kethoo/mimu-gloves/gestures.png

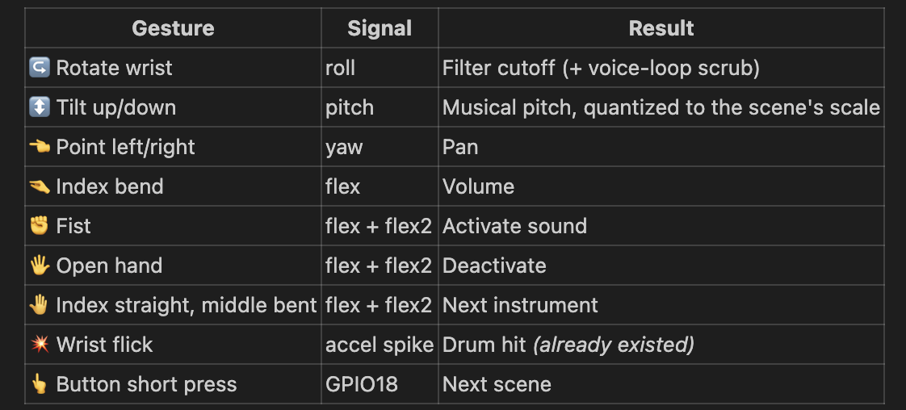
gestures.png
