kethoo/mimu-gloves/gestures_2.png

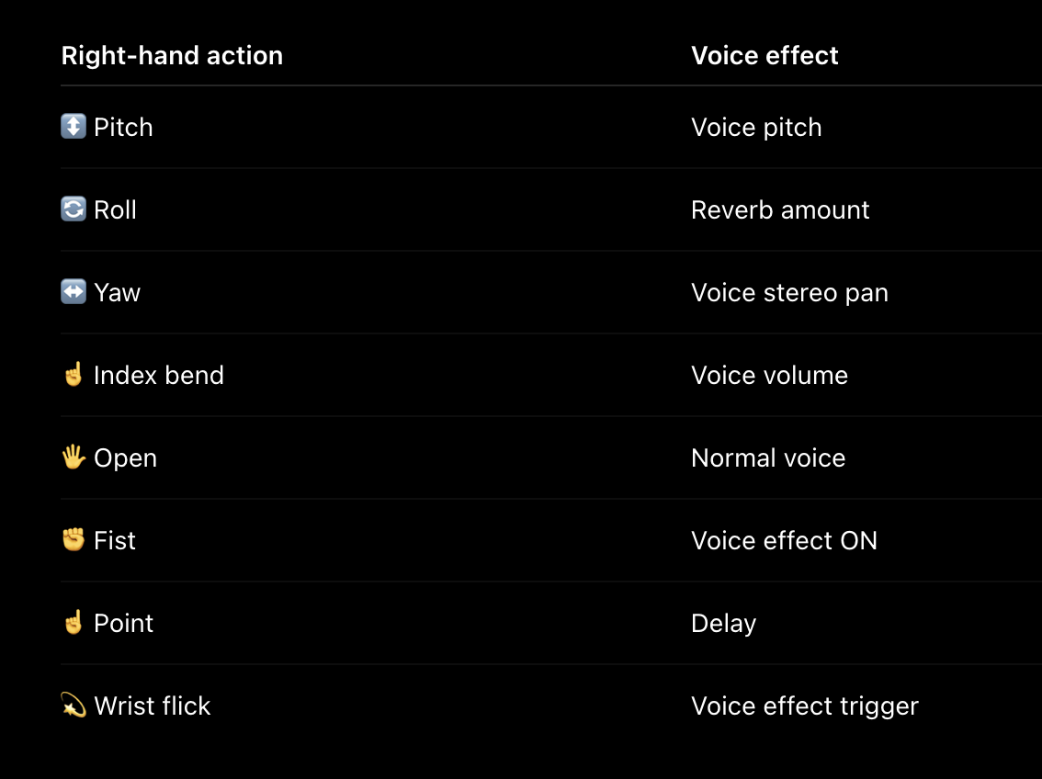
gestures_2.png
