kethoo/mimu-gloves/mid-tr-gestures.png

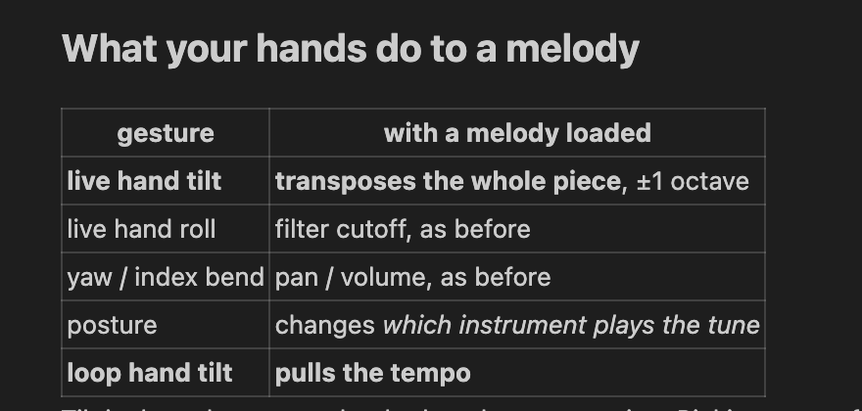
mid-tr-gestures.png
