kethoo/mimu-gloves/esp32/glove_ble/glove_ble.ino

// MiMu-style glove — ESP32 + BNO08x firmware
//
// The BNO08x does sensor fusion on-chip, so we stream ready-made
// orientation (Euler angles) plus linear acceleration over BLE at ~100 Hz.
// Sensor init and quaternion->Euler math merged from the user's original
// serial sketch (see ../reference/bno08x_serial_original.ino).
//
// Wiring (GY-BNO08x -> ESP32):
//   VCC -> 3V3,  GND -> GND,  SDA -> GPIO21,  SCL -> GPIO22,  RST -> GPIO4
//
// This firmware NEVER fabricates motion. If the sensor is missing it keeps
// retrying init and reports status=0 so the laptop can say so plainly.
//
// Wiring (flex sensors): 3V3 -> flex -> GPIO34 -> 15k -> GND
//                        3V3 -> flex -> GPIO35 -> 15k -> GND
//
// Packet format (40 bytes, little-endian, must match ble_receiver.py):
//   float roll, pitch, yaw;  // degrees, absolute (laptop zeroes them)
//   float lax, lay, laz;     // linear acceleration, m/s^2 (gravity removed)
//   float status;            // 1 = live sensor, 0 = sensor not detected
//   float flex, flex2;       // raw ADC 0..4095 from the two flex dividers
//   float scenePresses;      // running count of short button presses; the
//                            // laptop advances one scene per increment

#include <Adafruit_BNO08x.h>
#include <ESP_I2S.h>
#include <BLE2902.h>
#include <BLEDevice.h>
#include <BLEServer.h>
#include <BLEUtils.h>
#include <Wire.h>
#include <math.h>

// Which hand this board is. Flash one board with "-I" and the other with
// "-V"; the laptop tells them apart by advertised name, since two boards
// running the same sketch would otherwise advertise identically and the host
// would connect to whichever it happened to see first — nondeterministically,
// run to run. The service/characteristic UUIDs stay the same for both:
// devices are addressed by device, not by UUID.
//
//   "-I"  instrument hand (pitch, brightness, pan, scenes)
//   "-V"  voice hand      (voice pitch, reverb, delay, stutter)
//
// The laptop also matches by prefix, so a board still on the old un-suffixed
// "MIMU-GLOVE" firmware keeps working as the instrument hand.
// Defaults to the instrument hand. Flash the voice board by adding
//   --build-property "compiler.cpp.extra_flags=-DHAND_VOICE"
// to the arduino-cli command — no editing this file, so there is no way to
// leave the wrong identity committed or to flash two boards the same.
#ifdef HAND_VOICE
  #define HAND_SUFFIX "-V"
#else
  #define HAND_SUFFIX "-I"
#endif
#define DEVICE_NAME  "MIMU-GLOVE" HAND_SUFFIX
#define SERVICE_UUID "6e400001-b5a3-f393-e0a9-e50e24dcca9e"
#define CHAR_UUID    "6e400003-b5a3-f393-e0a9-e50e24dcca9e"
#define AUDIO_UUID   "6e400004-b5a3-f393-e0a9-e50e24dcca9e"
// The first thing the laptop can SEND to the glove rather than read from it.
// Everything else here is notify-only, so the glove had no way of knowing
// which instrument or loop mode it was part of — which is most of what the
// LED on the hand wants to show.
#define LED_UUID     "6e400005-b5a3-f393-e0a9-e50e24dcca9e"

#define BNO08X_I2C_ADDR 0x4B
#define BNO_RST 4
// Flex sensor divider. GPIO34 is input-only and on ADC1, which (unlike ADC2)
// keeps working while the BLE radio is active.
// The divider only swings ~212 of 4095 counts end to end (a 13-16k sensor
// into a 15k leg is 0.17 V), and raw ESP32 ADC noise measured ~50 counts —
// a quarter of the whole usable range. Averaging N samples cuts random noise
// by sqrt(N), so 16 reads takes it to ~13 counts. 32 reads per loop at 50 Hz
// is a rounding error against the BLE and I2S work.
#define FLEX_OVERSAMPLE 16
#define FLEX_PIN  34
#define FLEX2_PIN 35   // second finger; ADC1, input-only
// Record button, status LED and the INMP441 microphone.
#define BTN_PIN     18
#define HOLD_MS     400   // press longer than this records; shorter = next scene
// Longer than any real press, so a button that stays down is a fault.
#define BTN_STUCK_MS 8000
// More presses than this inside the window means the pin is producing them
// itself. A player does not press a glove's one button six times in ten
// seconds; a floating input does it constantly.
// Counted over a minute, not ten seconds. A pin that misfires every
// twenty or thirty seconds never produces a burst, so a short window
// never sees it — but each misfire still records two seconds of the room
// and replaces whatever was loaded. Three deliberate presses in a minute
// is already more than this button is for.
#define BTN_FAULT_PRESSES   3
#define BTN_FAULT_WINDOW_MS 60000
// Status LED: one WS2812B (NeoPixel). GND to ground, DIN here, and VDD to
// 3V3 rather than 5V — the ESP32 drives DIN at 3.3 V, while a WS2812B run
// from 5 V wants about 3.5 V before it reads a bit as high. That is the
// wiring that mostly works and occasionally shows the wrong colour.
// Driven by the core's own neopixelWrite(), so there is no library to add.
// GPIO23 rather than 16: on a WROVER the PSRAM chip owns 16 and 17, so the
// LED there works only in a build without PSRAM, which costs the 8 s
// recording buffer. 23 is not a strapping pin, not flash and not PSRAM, so
// it is quiet at boot and keeps both.
#define LED_PIN     23
#if defined(BOARD_HAS_PSRAM) && (LED_PIN == 16 || LED_PIN == 17)
  #error "LED_PIN 16/17 is the PSRAM bus on a WROVER - see the note above it"
#endif
// A WS2812B at full scale is blinding at arm's length and draws 60 mA. These
// are the only two levels the patterns use.
#define LED_LOW      6
#define LED_HIGH    60

// The second WS2812B: sewn to the back of the hand, between the glove's two
// layers, so the fabric spreads it into a patch of light rather than a dot.
// This one is driven by the laptop over LED_UUID and says what the hand is
// doing musically, where the board LED says whether the hardware is well.
// The same pin on both hands, so the two gloves are wired identically and
// there is nothing to get the wrong way round. 27 is a plain GPIO: no
// strapping, no flash, no PSRAM, nothing driven at boot.
#define HAND_LED_PIN 27
// The same trap as the status LED, plus one of its own: GPIO12 sets the
// flash voltage at boot, and held the wrong way the board does not come up
// at all — a far worse afternoon than a dark LED.
#if defined(BOARD_HAS_PSRAM) && (HAND_LED_PIN == 16 || HAND_LED_PIN == 17)
  #error "HAND_LED_PIN 16/17 is the PSRAM bus on a WROVER - use 27 or 19"
#endif
#if HAND_LED_PIN == 12
  #error "HAND_LED_PIN 12 is the flash-voltage strap (MTDI) - use 27 or 19"
#endif
// Sewn in under two layers of fabric. 48 read as off at the laptop's dimmer
// levels, and 255 is more current than this rail should carry for an indicator.
// The right glove stays at its earlier 48 until the brighter one has been judged.
#ifdef HAND_VOICE
  #define HAND_LED_MAX 48
#else
  #define HAND_LED_MAX 120
#endif
#define I2S_SCK     33
#define I2S_WS      25
#define I2S_SD      32
#define AUDIO_RATE  16000
#define MAX_SECONDS 8
// Internal RAM to leave untouched for the BLE stack, I2S DMA and the rest of
// the sketch when there is no PSRAM to put the audio buffer in. Sized with
// headroom: running the heap dry shows up as a BLE disconnect mid-recording,
// which is far harder to diagnose than a shorter take.
#define HEAP_RESERVE 40000
#define MAX_SAMPLES (AUDIO_RATE * MAX_SECONDS)
#define AUDIO_CHUNK 180   // bytes per BLE notification during a transfer
// 50 Hz is plenty for gesture control and leaves the I2C bus ~8x headroom;
// asking the BNO08x for 100 Hz on two reports wedges its SHTP transport.
#define SAMPLE_HZ 50
#define REPORT_US 20000  // 20 ms -> 50 Hz sensor reports
#define STALL_RESET_MS 20000  // silence before the sensor is hard reset

// No reset pin in the constructor: we drive it manually below, because the
// BNO08x needs a long (~500 ms) settle time after reset that the library's
// built-in pulse does not give it.
Adafruit_BNO08x bno08x;
sh2_SensorValue_t sensorValue;
BLECharacteristic *sensorChar;
BLECharacteristic *audioChar;
bool deviceConnected = false;
// Kept so a disconnect can clear them. See ServerCallbacks::onDisconnect.
BLE2902 *sensorCccd = nullptr;
BLE2902 *audioCccd = nullptr;
bool imuPresent = false;
uint32_t lastReportMs = 0;  // watchdog: when did a real sensor report arrive
uint32_t nextRetryMs = 0;   // rate-limit recovery attempts
int reEnableCount = 0;      // failed soft recoveries before a hard re-init

// Latest sensor readings, updated as reports arrive.
float roll = 0, pitch = 0, yaw = 0;
float lax = 0, lay = 0, laz = 0;
float flex = 0, flex2 = 0;  // smoothed raw ADC; the laptop calibrates these
uint32_t scenePresses = 0;  // running count of short button presses
bool btnStuck = false;      // button ignored until it releases (see buttonHeld)
bool btnFaulty = false;     // button disabled for this session (see buttonHeld)

// Microphone / recording state.
I2SClass i2s;
bool micOK = false, recording = false;
size_t maxSamples = 0;   // however many the allocation gave us
int16_t *audioBuf = nullptr;     // allocated in PSRAM at boot
size_t audioLen = 0;
int ledMode = 0;                 // 0 idle, 1 recording, 2 sending, 3 error

// The glove LED's state, as the laptop last described it. Declared here
// rather than beside its animation code because the BLE callback below
// writes it. See updateHandLed() for what the bytes mean.
enum : uint8_t {
  PAT_OFF = 0, PAT_STEADY, PAT_BREATHE, PAT_PULSE,
  PAT_SLICES, PAT_FROZEN, PAT_REVERSE, PAT_RECORD,
  // Like PULSE but barely dipping: the melody hand shares the loop's clock
  // without turning into a blinker and competing with what it is playing.
  PAT_ACCENT,
};
// hue, value, pattern, phase, period low, period high. Written by the BLE
// task and read by the loop; a torn read would cost one frame of one LED, so
// it is not worth a lock.
volatile uint8_t handPkt[6] = {0, 0, PAT_OFF, 0, 0, 0};
volatile uint32_t handPktAt = 0;

// Six bytes from the laptop: hue, value, pattern, phase, period (uint16 LE).
// Anything shorter is ignored rather than half-applied.
class LedCallbacks : public BLECharacteristicCallbacks {
  void onWrite(BLECharacteristic *c) override {
    if (c->getLength() < 6) return;
    const uint8_t *d = c->getData();
    for (int i = 0; i < 6; i++) handPkt[i] = d[i];
    handPktAt = millis();
  }
};

class ServerCallbacks : public BLEServerCallbacks {
  void onConnect(BLEServer *srv, esp_ble_gatts_cb_param_t *param) override {
    deviceConnected = true;
    // Ask for the fastest link Apple allows: 15-30 ms (units of 1.25 ms), no
    // skipped events, 4 s timeout. Left to itself the Mac was measured settling
    // on 30 ms with long gaps, about 20 packets a second from a 50 Hz sensor,
    // which is a visible lag on the wrist.
    srv->updateConnParams(param->connect.remote_bda, 12, 24, 0, 400);
  }
  void onDisconnect(BLEServer *srv) override {
    deviceConnected = false;
    // A subscription belongs to the link, but the stack keeps it after the
    // link is gone. The next client then gets 50 notifications a second while
    // it is still discovering services, and the Mac never finishes: the link
    // comes up, the status LED goes green, and the laptop times out, on every
    // connection after the first until the board reboots.
    if (sensorCccd) sensorCccd->setNotifications(false);
    if (audioCccd) audioCccd->setNotifications(false);
    // Nobody is describing the music any more, so stop showing the last colour:
    // it read as still being connected.
    handPkt[2] = PAT_OFF;
    srv->getAdvertising()->start();  // let the laptop reconnect
  }
};

void setReports() {
  if (!bno08x.enableReport(SH2_ROTATION_VECTOR, REPORT_US))
    Serial.println("Could not enable Rotation Vector");
  if (!bno08x.enableReport(SH2_LINEAR_ACCELERATION, REPORT_US))
    Serial.println("Could not enable Linear Acceleration");
  // NOTE: deliberately does not touch lastReportMs — only a real incoming
  // report may reset the watchdog, or it can never escalate to a re-init.
}

// Unstick the I2C bus. If the sensor locked up mid-transfer it can hold SDA
// low forever, which makes every device — including itself — invisible to a
// scan. Clocking SCL manually lets it finish that transfer and release SDA.
void recoverI2CBus() {
  Wire.end();
  pinMode(22, OUTPUT);      // SCL
  pinMode(21, INPUT_PULLUP);  // SDA
  for (int i = 0; i < 10 && digitalRead(21) == LOW; i++) {
    digitalWrite(22, LOW);
    delayMicroseconds(5);
    digitalWrite(22, HIGH);
    delayMicroseconds(5);
  }
  // Manual STOP condition so the bus is left idle.
  pinMode(21, OUTPUT);
  digitalWrite(21, LOW);
  delayMicroseconds(5);
  digitalWrite(22, HIGH);
  delayMicroseconds(5);
  digitalWrite(21, HIGH);
  delayMicroseconds(5);
  Wire.begin(21, 22);
  Wire.setClock(100000);  // slower bus: safer over long jumper wires
  Wire.setTimeOut(50);    // never block forever on a line that is still stuck
}

// Hard-reset the sensor the way the original sketch did: hold RST low,
// release, then give it half a second to boot before talking to it.
void hardResetSensor() {
  pinMode(BNO_RST, OUTPUT);
  digitalWrite(BNO_RST, LOW);
  delay(20);
  digitalWrite(BNO_RST, HIGH);
  delay(500);
}

void scanI2C() {
  Serial.print("I2C devices found:");
  bool any = false;
  for (uint8_t addr = 1; addr < 127; addr++) {
    Wire.beginTransmission(addr);
    if (Wire.endTransmission() == 0) {
      Serial.printf(" 0x%02X", addr);
      any = true;
    }
  }
  Serial.println(any ? "" : " NONE (check wiring: VCC/GND/SDA=21/SCL=22)");
}

// Try both common BNO08x addresses, with retries — a cold sensor sometimes
// needs a second attempt after reset.
bool initSensor() {
  for (int attempt = 1; attempt <= 3; attempt++) {
    recoverI2CBus();
    hardResetSensor();
    if (attempt > 1) scanI2C();  // show whether it is even on the bus
    for (uint8_t addr : {(uint8_t)BNO08X_I2C_ADDR, (uint8_t)0x4A}) {
      if (bno08x.begin_I2C(addr, &Wire)) {
        Serial.printf("BNO08X found at 0x%02X (attempt %d)\n", addr, attempt);
        setReports();
        lastReportMs = millis();
        reEnableCount = 0;
        return true;
      }
    }
    Serial.printf("BNO08X init attempt %d failed\n", attempt);
  }
  return false;
}

// Written only when the colour actually changes. Each write is an RMT
// transaction that holds the pin for ~80 us, and there is no reason to run
// one fifty times a second to say what the LED is already saying. The cache
// is per LED, since there are two of them on different pins now.
void writePixel(uint8_t pin, uint8_t idx, uint8_t r, uint8_t g, uint8_t b) {
  static uint8_t last[2][3] = {{0, 0, 0}, {0, 0, 0}};
  static bool written[2] = {false, false};
  if (written[idx] && r == last[idx][0] && g == last[idx][1] && b == last[idx][2])
    return;
  last[idx][0] = r; last[idx][1] = g; last[idx][2] = b; written[idx] = true;
  neopixelWrite(pin, r, g, b);
}

void setLed(uint8_t r, uint8_t g, uint8_t b) {
  writePixel(LED_PIN, 0, r, g, b);
}

// Status LED. Non-blocking so the pattern survives audio work. One colour
// per state, so the glove can be read on its own without the laptop:
//   solid red        recording
//   blue blink       sending the take over BLE
//   fast red blink   sensor stalled — the watchdog below is trying to recover
//   dim green        idle, laptop connected
//   dim blue pulse   idle, advertising and waiting to be connected to
void statusColour(uint8_t low, uint8_t high, uint8_t &r, uint8_t &g, uint8_t &b) {
  uint32_t t = millis();
  r = g = b = 0;
  if (ledMode == 1) r = high;
  else if (ledMode == 2) b = (t / 400) % 2 ? high : 0;
  else if (ledMode == 3) r = (t / 120) % 2 ? high : 0;
  else if (deviceConnected) g = low;
  else b = (t / 900) % 2 ? low : 0;
}

void updateLed() {
  uint8_t r, g, b;
  statusColour(LED_LOW, LED_HIGH, r, g, b);
  setLed(r, g, b);
}

// ---- the LED sewn into the glove ----------------------------------------
// This one belongs to the laptop. It knows the instrument, the loop mode and
// where the playhead is; the glove knows none of that, which is exactly why
// the write characteristic had to exist. Six bytes arrive and are animated
// here rather than streamed frame by frame, so the pulse stays smooth
// between updates and a dropped packet costs nothing.
// Mirrors N_SLICES in synth.py: the take is chopped into four, so the hand
// beats four times a cycle and you can see where the chops land.
#define HAND_SLICES 4

// Hue at full brightness; the pattern scales it afterwards. An integer
// rainbow rather than real HSV — this is a glowing patch of fabric, not a
// colour-managed display.
static void hueToRgb(uint8_t h, uint8_t &r, uint8_t &g, uint8_t &b) {
  uint8_t sector = h / 43, f = (uint8_t)((h % 43) * 6);
  switch (sector) {
    case 0:  r = 255;     g = f;       b = 0;       break;
    case 1:  r = 255 - f; g = 255;     b = 0;       break;
    case 2:  r = 0;       g = 255;     b = f;       break;
    case 3:  r = 0;       g = 255 - f; b = 255;     break;
    case 4:  r = f;       g = 0;       b = 255;     break;
    default: r = 255;     g = 0;       b = 255 - f; break;
  }
}

// A hit rather than a blink: full at the top of the cycle and gone a quarter
// of the way in, over a floor so the hand never goes black mid-loop.
static float accent(float p) {
  float a = 1.0f - p * 4.0f;
  return a > 0.0f ? a : 0.0f;
}

void updateHandLed() {
  uint8_t pat = handPkt[2];
  uint32_t now = millis();

#ifndef HAND_VOICE
  // The instrument glove has no LED on GPIO23, so this is the only one it can
  // speak through. It shows the status colours until the laptop sends a colour,
  // and again whenever the glove has something to say that the laptop cannot
  // know: recording, sending a take, or a stalled sensor.
  if (ledMode != 0 || pat == PAT_OFF) {
    uint8_t r, g, b;
    statusColour(HAND_LED_MAX / 2, HAND_LED_MAX, r, g, b);
    writePixel(HAND_LED_PIN, 1, r, g, b);
    return;
  }
#endif

  // Where the loop is *now*, carried on from the last packet. Interpolating
  // locally is what keeps the beat smooth: the laptop only has to resync
  // occasionally instead of sending every frame of the animation.
  float p = 0.0f;
  uint16_t period = (uint16_t)handPkt[4] | ((uint16_t)handPkt[5] << 8);
  if (period > 0) {
    float turns = handPkt[3] / 256.0f + (float)(now - handPktAt) / period;
    p = turns - floorf(turns);
  }

  float level;
  switch (pat) {
    case PAT_OFF:
      writePixel(HAND_LED_PIN, 1, 0, 0, 0);
      return;
    case PAT_RECORD:   // the one state that overrides its own colour
      writePixel(HAND_LED_PIN, 1, HAND_LED_MAX, 0, 0);
      return;
    case PAT_BREATHE:
      level = 0.15f + 0.35f * (0.5f + 0.5f * sinf(now / 1200.0f));
      break;
    case PAT_PULSE:
      level = 0.35f + 0.65f * accent(p);
      break;
    case PAT_SLICES: {
      float q = p * HAND_SLICES;
      level = 0.35f + 0.65f * accent(q - floorf(q));
      break;
    }
    case PAT_REVERSE:  // the hit decays into the beat instead of off it
      level = 0.35f + 0.65f * accent(1.0f - p);
      break;
    case PAT_ACCENT:
      level = 0.82f + 0.18f * accent(p);
      break;
    default:           // STEADY and FROZEN both just hold
      level = 1.0f;
      break;
  }

  uint8_t r, g, b;
  hueToRgb(handPkt[0], r, g, b);
  // The base colour eases over ~100 ms, so changing instrument reads as a
  // change rather than a glitch. Freeze snaps, because the audio snaps.
  static float cr = 0, cg = 0, cb = 0;
  float k = (pat == PAT_FROZEN) ? 1.0f : 0.25f;
  cr += (r - cr) * k; cg += (g - cg) * k; cb += (b - cb) * k;

  float scale = level * (handPkt[1] / 255.0f) * (HAND_LED_MAX / 255.0f);
  writePixel(HAND_LED_PIN, 1, (uint8_t)(cr * scale),
             (uint8_t)(cg * scale), (uint8_t)(cb * scale));
}

// Oversampled flex read: see FLEX_OVERSAMPLE above for why this matters.
int readFlex(int pin) {
  uint32_t sum = 0;
  for (int i = 0; i < FLEX_OVERSAMPLE; i++) sum += analogRead(pin);
  return (int)(sum / FLEX_OVERSAMPLE);
}

bool buttonHeld() {
  static bool stable = false, lastRaw = false, lastStable = false;
  static uint32_t lastChange = 0, heldSince = 0;
  bool raw = digitalRead(BTN_PIN) == LOW;
  if (raw != lastRaw) { lastRaw = raw; lastChange = millis(); }
  if (millis() - lastChange > 30) {
    if (raw && !stable) heldSince = millis();
    stable = raw;
  }
  // A healthy button is pressed deliberately, a few times a minute. One
  // that produces presses on its own is a wiring fault, and it is far more
  // damaging than it sounds: each phantom hold records two seconds of the
  // room from the glove's own mic, and a take REPLACES the loop — so a song
  // you just loaded is overwritten by whatever the speakers were playing.
  // Measured on the faulty glove: four recordings in twenty-two seconds.
  static uint32_t presses = 0, windowStart = 0;
  if (stable && !lastStable) {
    uint32_t now = millis();
    if (now - windowStart > BTN_FAULT_WINDOW_MS) { windowStart = now; presses = 0; }
    if (++presses > BTN_FAULT_PRESSES && !btnFaulty) {
      btnFaulty = true;
      Serial.printf("!! button produced %u presses in %lu s on its own - "
                    "disabling it for this session (check its wiring)\n",
                    (unsigned)presses,
                    (unsigned long)(BTN_FAULT_WINDOW_MS / 1000));
    }
  }
  lastStable = stable;
  if (btnFaulty) return false;

  if (!stable) { btnStuck = false; return false; }

  // A press that never ends is a wiring fault, not a very long press. It
  // matters because the buffer-full path waits for the release and would
  // spin there for good, and recording returns early from the loop — so a
  // shorted button stops the glove sending orientation at all. Measured on
  // a glove whose GPIO18 was shorted: one heartbeat in thirty seconds, the
  // panel showing it connected and stalled with the hand frozen at zero.
  if (!btnStuck && millis() - heldSince > BTN_STUCK_MS) {
    btnStuck = true;
    Serial.println("!! button has read as pressed for 8 s - treating it as "
                   "stuck and ignoring it until it releases (check its wiring)");
  }
  return !btnStuck;
}

// Ship the take to the laptop: a 12-byte header, then raw little-endian
// int16 samples. Latency does not matter here - the recording is already
// finished - which is why this works where live streaming would not.
void sendAudio() {
  if (!deviceConnected || audioLen == 0) return;
  ledMode = 2;
  uint8_t hdr[12];
  memcpy(hdr, "AUD0", 4);
  uint32_t n = audioLen, r = AUDIO_RATE;
  memcpy(hdr + 4, &n, 4);
  memcpy(hdr + 8, &r, 4);
  audioChar->setValue(hdr, sizeof(hdr));
  audioChar->notify();
  delay(20);

  const uint8_t *data = (const uint8_t *)audioBuf;
  size_t total = audioLen * sizeof(int16_t), sent = 0;
  while (sent < total && deviceConnected) {
    size_t n2 = min((size_t)AUDIO_CHUNK, total - sent);
    audioChar->setValue((uint8_t *)(data + sent), n2);
    audioChar->notify();
    sent += n2;
    updateLed();
    delay(6);   // let the BLE stack drain; without this notifications are lost
  }
  Serial.printf("audio sent: %u samples (%.2f s)\n",
                (unsigned)audioLen, (float)audioLen / AUDIO_RATE);
  ledMode = 0;
  audioLen = 0;
}

void setup() {
  Serial.begin(115200);
  delay(100);
  Serial.println("========== MIMU GLOVE (BLE) ==========");

  Wire.begin(21, 22);
  // 100 kHz, NOT 400 kHz. Measured: at 400 kHz over dupont jumpers the
  // BNO08x wedged every ~15-20 s (it kept ACKing its address but would not
  // re-initialize); at 100 kHz it ran 90 s under BLE load with zero dropouts.
  Wire.setClock(100000);
  // A held-low SDA or SCL makes endTransmission() block, and a board that
  // blocks here never reaches BLEDevice::init and so never advertises at
  // all — which looks exactly like a dead board. Seen on the voice glove:
  // serial stopped mid-way through the I2C scan and nothing followed.
  Wire.setTimeOut(50);
  delay(100);

  pinMode(BTN_PIN, INPUT_PULLUP);
  // Held low until the first colour is written: a WS2812B whose DIN floats
  // at power-up latches whatever noise it saw and sits there lit.
  pinMode(LED_PIN, OUTPUT);
  digitalWrite(LED_PIN, LOW);
  pinMode(HAND_LED_PIN, OUTPUT);
  digitalWrite(HAND_LED_PIN, LOW);
  // Nobody powers the glove up with the button held, so a button that is
  // already down at boot is a short. Waiting out BTN_STUCK_MS still let it
  // record a stray take first, and a take REPLACES whatever is in the loop
  // — so a song you had just loaded was overwritten by two seconds of the
  // room, picked up from the speakers, which then looped.
  delay(20);
  if (digitalRead(BTN_PIN) == LOW) {
    btnStuck = true;
    Serial.println("!! button is already pressed at boot - treating it as "
                   "stuck and ignoring it (check its wiring)");
  }

  // The audio buffer lives in PSRAM: this is a WROVER module, and internal
  // RAM has no room for it beside the BLE stack. Falls back to a shorter
  // take in internal RAM if PSRAM is unavailable.
  audioBuf = (int16_t *)ps_malloc(MAX_SAMPLES * sizeof(int16_t));
  if (audioBuf) {
    maxSamples = MAX_SAMPLES;
    Serial.printf("Audio buffer: %d s in PSRAM.\n", MAX_SECONDS);
  } else {
    // No PSRAM. Size the buffer to what internal RAM can actually spare
    // rather than assuming: free heap after the BLE stack comes up varies by
    // core version and build options, and a hardcoded 2 s was leaving room
    // unused on some boards and would overrun on others.
    // Largest CONTIGUOUS block, not total free. getFreeHeap() reports the
    // sum of every free fragment, so asking malloc for that much fails on a
    // fragmented heap — measured 228 kB free but no single block that size,
    // which silently produced a 0-second buffer.
    size_t freeHeap = ESP.getMaxAllocHeap();
    size_t budget = freeHeap > HEAP_RESERVE ? freeHeap - HEAP_RESERVE : 0;
    size_t want = (size_t)AUDIO_RATE * MAX_SECONDS * sizeof(int16_t);
    size_t take = budget < want ? budget : want;
    maxSamples = take / sizeof(int16_t);
    audioBuf = maxSamples ? (int16_t *)malloc(maxSamples * sizeof(int16_t)) : nullptr;
    if (!audioBuf) maxSamples = 0;
    Serial.printf(
        "No PSRAM - largest free block %u B, reserving %u B -> %.1f s buffer.\n",
        (unsigned)freeHeap, (unsigned)HEAP_RESERVE,
        (float)maxSamples / AUDIO_RATE);
  }

  i2s.setPins(I2S_SCK, I2S_WS, -1, I2S_SD);
  micOK = i2s.begin(I2S_MODE_STD, AUDIO_RATE, I2S_DATA_BIT_WIDTH_32BIT,
                    I2S_SLOT_MODE_MONO);
  Serial.println(micOK ? "Microphone ready." : "Microphone FAILED to start.");

  BLEDevice::init(DEVICE_NAME);
  BLEDevice::setMTU(517);   // big MTU so audio chunks fit in one packet
  BLEServer *server = BLEDevice::createServer();
  server->setCallbacks(new ServerCallbacks());
  BLEService *service = server->createService(SERVICE_UUID);
  sensorChar = service->createCharacteristic(
      CHAR_UUID, BLECharacteristic::PROPERTY_NOTIFY);
  sensorCccd = new BLE2902();
  sensorChar->addDescriptor(sensorCccd);
  audioChar = service->createCharacteristic(
      AUDIO_UUID, BLECharacteristic::PROPERTY_NOTIFY);

  // Write-without-response as well as write: the laptop sends this several
  // times a second and has no use for an acknowledgement, and waiting for
  // one would put it in the way of the audio transfer.
  BLECharacteristic *ledChar = service->createCharacteristic(
      LED_UUID, BLECharacteristic::PROPERTY_WRITE |
                BLECharacteristic::PROPERTY_WRITE_NR);
  ledChar->setCallbacks(new LedCallbacks());
  audioCccd = new BLE2902();
  audioChar->addDescriptor(audioCccd);
  service->start();
  server->getAdvertising()->start();
  // Print the real macro, never a copy of it: a hardcoded literal here
  // said "MIMU-GLOVE" on a board that was correctly advertising as
  // "MIMU-GLOVE-V", which is a genuinely confusing thing to debug.
  Serial.print("Advertising as ");
  Serial.println(DEVICE_NAME);

  // Sensor last, and only after the radio is up. The flex sensors and the
  // microphone do not need the IMU, so a glove with a dead BNO08x should
  // still link and still be playable — and a board that cannot be found at
  // all is far harder to diagnose than one that connects and reports
  // status=0. recoverI2CBus() first, to clock out a stuck line before the
  // scan rather than after it.
  recoverI2CBus();
  hardResetSensor();
  scanI2C();
  imuPresent = initSensor();
  if (!imuPresent)
    Serial.println("BNO08X not found - will keep retrying (no fake data sent).");
}

void readSensor() {
  if (bno08x.wasReset()) {
    Serial.println("Sensor reset.");
    delay(100);
    setReports();
  }
  // Drain everything that has arrived since last loop.
  while (bno08x.getSensorEvent(&sensorValue)) {
    lastReportMs = millis();
    if (sensorValue.sensorId == SH2_ROTATION_VECTOR) {
      float qr = sensorValue.un.rotationVector.real;
      float qi = sensorValue.un.rotationVector.i;
      float qj = sensorValue.un.rotationVector.j;
      float qk = sensorValue.un.rotationVector.k;
      yaw = atan2(2.0f * (qr * qk + qi * qj),
                  1.0f - 2.0f * (qj * qj + qk * qk)) * 180.0f / PI;
      pitch = asin(constrain(2.0f * (qr * qj - qk * qi), -1.0f, 1.0f))
              * 180.0f / PI;
      roll = atan2(2.0f * (qr * qi + qj * qk),
                   1.0f - 2.0f * (qi * qi + qj * qj)) * 180.0f / PI;
    } else if (sensorValue.sensorId == SH2_LINEAR_ACCELERATION) {
      lax = sensorValue.un.linearAcceleration.x;
      lay = sensorValue.un.linearAcceleration.y;
      laz = sensorValue.un.linearAcceleration.z;
    }
  }

  // Watchdog: reports stop arriving if the SHTP transport wedges (a known
  // BNO08x quirk, provoked here by BLE traffic). Try re-enabling reports a
  // few times, then escalate to a full hardware reset + re-init.
  uint32_t now = millis();
  uint32_t since = now - lastReportMs;
  // The error colour was defined and never used, which is a waste of the one
  // thing the glove can say by itself. The stall now shows on the hand as it
  // happens, instead of only in the laptop's log: red the moment reports go
  // missing, back to idle the moment they come back. Recording and sending
  // outrank it — those say something the wearer is waiting on.
  if (ledMode != 1 && ledMode != 2) ledMode = (since > 1000) ? 3 : 0;
  if (since > 1000 && now > nextRetryMs) {
    nextRetryMs = now + 1000;
    // Measured on the right glove: reports stopped while the hand lay still and
    // flowed while it moved, and escalating after 3 s rebooted the board and
    // dropped the laptop about every 8 s. So a quiet sensor is only re-enabled,
    // and the reset waits until it has been silent for a long time.
    if (since < STALL_RESET_MS) {
      reEnableCount++;
      Serial.printf("No reports for %lums - re-enabling (%d).\n",
                    (unsigned long)since, reEnableCount);
      setReports();
    } else {
      Serial.println("Soft recovery failed - hard resetting sensor.");
      imuPresent = initSensor();
      lastReportMs = millis();
      reEnableCount = 0;
      if (!imuPresent) {
        // The sensor still ACKs its address but refuses to initialize: it is
        // wedged in a state that re-init cannot clear. A full reboot is the
        // one recovery proven to work every time, so stop limping and reboot.
        Serial.println("Sensor unrecoverable in place - rebooting ESP32.");
        Serial.flush();
        delay(50);
        ESP.restart();
      }
    }
  }
}

void loop() {
  static uint32_t next = 0;
  uint32_t now = millis();

  updateLed();
  updateHandLed();

  // One button, two jobs: a short press asks the laptop for the next scene,
  // holding it records. Recording only begins once the press passes HOLD_MS,
  // so a tap can never start a stray take.
  //
  // The scene press is reported as a running count rather than a one-frame
  // pulse: a dropped BLE notification would silently swallow a pulse, but the
  // laptop notices a count that has moved on whenever the next packet lands.
  bool btn = buttonHeld();
  static bool prevBtn = false;
  static uint32_t pressStart = 0;
  if (btn && !prevBtn) pressStart = now;
  if (!btn && prevBtn && !recording && now - pressStart < HOLD_MS) {
    scenePresses++;
    Serial.println(">>> short press: next scene");
  }
  prevBtn = btn;

  // Audio capture takes priority over the sensor stream: a few dropped
  // orientation frames cost nothing, a gap in the recording is audible.
  bool held = micOK && btn && (now - pressStart >= HOLD_MS);
  if (held && !recording) {
    recording = true;
    audioLen = 0;
    ledMode = 1;
    Serial.println(">>> RECORDING <<<");
  } else if (!held && recording) {
    recording = false;
    Serial.printf(">>> STOPPED: %.2f s\n", (float)audioLen / AUDIO_RATE);
    sendAudio();
  }

  if (recording) {
    static int32_t rawAudio[256];
    size_t got = i2s.readBytes((char *)rawAudio, sizeof(rawAudio));
    size_t n = got / sizeof(int32_t);
    for (size_t i = 0; i < n && audioLen < maxSamples; i++)
      audioBuf[audioLen++] = (int16_t)(rawAudio[i] >> 16);   // 24-bit -> 16-bit
    if (audioLen >= maxSamples) {
      Serial.println("(buffer full)");
      recording = false;
      sendAudio();
      while (buttonHeld()) { updateLed(); delay(5); }
    }
    return;   // skip sensor work while capturing
  }

  if (imuPresent) {
    readSensor();
  } else if (now > nextRetryMs) {
    // Never give up: a marginal connection often comes back, and a boot-time
    // failure must not doom the whole session. After a few in-place retries,
    // reboot — that path reliably brings the sensor back.
    nextRetryMs = now + 3000;
    static int missingRetries = 0;
    Serial.println("Retrying BNO08X...");
    imuPresent = initSensor();
    if (imuPresent) {
      missingRetries = 0;
    } else if (++missingRetries >= 2) {
      Serial.println("Still no sensor - rebooting ESP32.");
      Serial.flush();
      delay(50);
      ESP.restart();
    }
  }

  // Yield to the FreeRTOS scheduler. Without this the tight poll loop
  // starves the BLE stack, which is what wedged the sensor's I2C transport
  // as soon as a client connected.
  delay(2);

  if (now < next) return;
  next = now + 1000 / SAMPLE_HZ;

  // Flex sensor, lightly smoothed against ADC noise. Sent raw (0..4095) so
  // the laptop can calibrate it to the player's actual bend range. Seed the
  // filter from the first sample — ramping up from 0 produced a fake swing
  // that looked like a real bend to the laptop's auto-calibration.
  int flexRaw = readFlex(FLEX_PIN);
  int flex2Raw = readFlex(FLEX2_PIN);
  static bool flexInit = false;
  if (!flexInit) {
    flex = flexRaw;
    flex2 = flex2Raw;
    flexInit = true;
  } else {
    flex = 0.8f * flex + 0.2f * flexRaw;
    flex2 = 0.8f * flex2 + 0.2f * flex2Raw;
  }

  // Heartbeat first, so serial diagnostics work with no BLE client attached.
  static uint32_t nextLog = 0;
  if (now > nextLog) {
    nextLog = now + 1000;
    Serial.printf("%s roll %7.2f  pitch %7.2f  yaw %7.2f  |acc| %5.2f  flex %5.0f/%5.0f  ble=%d\n",
                  imuPresent ? "SENSOR " : "NO-IMU!", roll, pitch, yaw,
                  sqrtf(lax * lax + lay * lay + laz * laz), flex, flex2,
                  deviceConnected);
  }

  if (!deviceConnected) return;

  if (!imuPresent) roll = pitch = yaw = lax = lay = laz = 0;

  float pkt[10] = {roll,      pitch, yaw, lax, lay, laz,
                   imuPresent ? 1.0f : 0.0f, flex, flex2,
                   (float)scenePresses};
  sensorChar->setValue((uint8_t *)pkt, sizeof(pkt));
  sensorChar->notify();
}
