kethoo/mimu-gloves/glove/mapping.py

"""The LIVE hand: everything about the note happening right now.

One of two hands, and deliberately asymmetric with the other. This hand makes
sound — pitch, brightness, dynamics, articulation — and never touches an
effect. `loop_mapping.py` shapes what has already been captured and never
plays a note. There is exactly one of each parameter in the instrument, and
each belongs to exactly one hand; see renewed-design.md.

Gesture vocabulary:

  ^v tilt hand up/down (pitch)  -> musical pitch, quantized to the scene's scale
  |> rotate wrist (roll)        -> filter cutoff / brightness
  <> point left/right (yaw)     -> stereo pan
  -- index finger bend (flex)   -> volume / expression
  ~~ middle finger bend         -> vibrato depth
  >> motion                     -> how hard a wrist flick lands
  () fist, both fingers curled  -> activate the sound
  || open hand, both straight   -> deactivate it
  ^  point: index straight,
     middle curled              -> next instrument
  *  wrist flick                -> drum hit
  #  button, short press        -> next scene
  #  button, hold               -> capture the phrase into the loop

Two notes on what the hardware can actually sense.

"Up/down" and "left/right" are tilt and yaw, not translation. The BNO08x
reports orientation only; position would mean double-integrating acceleration,
which drifts into nonsense within seconds. Tilting the hand is the honest
proxy and is what the sensor can support.

Postures come from two flex sensors, which give four states in total, and the
index finger is already busy being the volume control — a swell sweeps it
through the posture regions constantly. So a posture fires only on entry, once,
and only after it has been held steady for POSTURE_HOLD seconds. The dead band
between POSTURE_LO and POSTURE_HI is the hysteresis: values in between are
"playing", not "posturing".

Discrete gesture/button events (see handle_event):
  punch    -> wrist flick: percussive hit; in slice mode, fires a chunk
  scene    -> next scene (instrument + scale + modes)
  record   -> start/stop recording the mic into the voice loop
  overdub  -> start/stop layering a new take on top of the playing loop
  loop     -> voice loop play/pause
  granular -> normal loop <-> granular cloud
  slices   -> punch = drum hit <-> punch = recording slice
  mute     -> drone tone on/off (hear the voice alone)
  instrument:<name> -> switch drone instrument (see synth.INSTRUMENTS)
"""

from __future__ import annotations

import math

from glove.sensors import SensorFrame
from glove.synth import GloveSynth

# Scales as MIDI note numbers, low to high. A scene picks one.
SCALES = {
    "pentatonic": [57, 60, 62, 64, 67, 69, 72, 74, 76, 79, 81],
    "minor":      [57, 59, 60, 62, 64, 65, 67, 69, 71, 72, 74],
    "dorian":     [57, 59, 60, 62, 64, 66, 67, 69, 71, 72, 74],
    "whole":      [57, 59, 61, 63, 65, 67, 69, 71, 73, 75, 77],
}

# A scene is a whole performance setup: what it plays, in what key, in what
# mode. The button cycles them, so keep the list short enough to reach the one
# you want mid-performance.
#            name         instrument  scale         granular  slices
SCENES = [
    ("Lead",           "saw",      "pentatonic", False, False),
    ("Cathedral",      "organ",    "minor",      False, False),
    ("Bowed",          "strings",  "dorian",     False, False),
    ("Chimes",         "bell",     "whole",      False, False),
    ("Amp",            "guitar",   "minor",      False, False),
    ("Cloud",          "strings",  "whole",      True,  False),
]

# How far you actually have to move to reach the extremes. A wrist holding
# the board comfortably covers roughly +/-45 deg, not the +/-90 the sensor
# can report, so mapping against 90 wastes most of the musical range.
ROLL_RANGE = 45.0   # degrees of roll from darkest to brightest
PITCH_RANGE = 45.0  # degrees of tilt for the full scale, low to high
YAW_RANGE = 45.0    # degrees of yaw for hard-left to hard-right pan

CUTOFF_LO, CUTOFF_HI = 200.0, 6000.0
# The record filter opens further than the instrument's: a track is full-range
# material, so 6 kHz at the top would sound permanently muffled where the same
# ceiling on a single oscillator sounds bright.
VOICE_CUTOFF_HI = 18000.0

# The scale quantizer remembers the step it last committed to, so a hand
# parked on a boundary between two notes does not flutter between them.
# Plain rounding measured 50 note changes a second with only +/-0.3 deg of
# sensor noise — and since a note change re-articulates the envelope, that is
# a machine-gun rattle on the struck instruments, not just a wobbly pitch.
# The hand has to travel 68% of the way to a neighbour before the note moves.
STEP_HYSTERESIS = 0.18

# Volume response to finger bend. `flex` already arrives as 0..1 across the
# sensor's calibrated range, so making it "more sensitive" means changing the
# shape of the response, not the range.
#
# FLEX_CURVE < 1 expands the early part of the bend, where a finger has the
# most control: at 0.6, bending 20% from straight gives ~38% of the travel
# instead of 20%. Lower it for a hair trigger, raise it past 1 to make the
# first part of the bend do less.
FLEX_CURVE = 0.6

# Loudness is perceived roughly logarithmically, so a linear amplitude ramp
# wastes the top half of the bend — going from 0.5 to 1.0 amplitude is only
# 6 dB, which barely reads as a change. Mapping the finger across a dB range
# instead makes the whole travel feel even, and is most of why this now
# responds to a small bend.
VOL_RANGE_DB = 34.0
AMP_MAX = 0.55

POSTURE_HI = 0.62    # bent past this counts as curled
POSTURE_LO = 0.28    # straighter than this counts as extended

# Seconds a posture must hold before it fires. "open" needs much longer than
# the others because a relaxed hand *is* an open hand: fading out with the
# index finger passes through the open posture every single time. Nobody holds
# both fingers flat for the best part of a second while still playing, so the
# long dwell separates "quiet" from "done".
# Measured: a slow fade-out running straight into a fade-in dwells about
# 0.84 s below the threshold, so 0.8 s was not enough margin.
POSTURE_HOLD = {"fist": 0.35, "point": 0.35, "open": 1.00}

# A three-sensor build has one finger on one hand doing both jobs: shaping a
# continuous parameter and standing in for a posture. These two numbers are
# all that separates the jobs. The bend has to go past where the control
# range is useful, and it has to stay there — a performer pushing a blend to
# maximum passes through, a performer meaning a fist stops.
POSTURE_SOLO_HI = 0.85
POSTURE_HOLD_SOLO = {"fist": 0.90, "open": 1.00}
# Frames voted on before a reading is believed. Five at 100 Hz is 50 ms:
# shorter than any gesture and longer than any noise spike.
POSTURE_VOTE = 5

class HandState:
    """Everything `apply` remembers between ticks, for ONE hand.

    This was module-level state until the second glove arrived, and sharing it
    broke both hands rather than favouring one: two gloves alternating into
    `apply` reset each other's posture dwell timer every tick, so no posture
    could ever accumulate its hold time and none of them ever fired.
    """

    def __init__(self) -> None:
        self.last_step = 0
        self.last_transpose = 0            # semitones, melody mode only
        self.scene = 0
        self.posture: str | None = None    # posture currently committed to
        self.pending: str | None = None    # being held, not yet committed
        self.pending_since = 0.0
        self.recent: list[str | None] = []  # last few reads, for the vote


# The single-glove default, so `apply(frame, synth)` keeps working unchanged.
_default = HandState()


def midi_to_hz(note: float) -> float:
    return 440.0 * 2.0 ** ((note - 69) / 12.0)


def _norm(value: float, limit: float) -> float:
    """Map -limit..+limit onto 0..1, clamped."""
    return min(max((value + limit) / (2.0 * limit), 0.0), 1.0)


def _read_posture(flex: float | None, flex2: float | None) -> str | None:
    """Which posture the hand is in, or None for "playing".

    Anything between the two thresholds is deliberately nothing: that gap is
    where the index finger lives while it is working as the volume control.

    With one sensor instead of two, a hand can still say "curled" and
    "straight" but it cannot say "point", because point is the two fingers
    disagreeing. Refusing to read anything at all was the old behaviour and
    it cost all three, which is the wrong trade when the second sensor is
    missing from the build or has simply died.
    """
    if flex is None and flex2 is None:
        return None
    if flex is None or flex2 is None:
        return _solo_posture(flex if flex is not None else flex2)
    if flex > POSTURE_HI and flex2 > POSTURE_HI:
        return "fist"
    if flex < POSTURE_LO and flex2 < POSTURE_LO:
        return "open"
    if flex < POSTURE_LO and flex2 > POSTURE_HI:
        return "point"
    return None


def _solo_posture(f: float) -> str | None:
    """Fist and open from a single finger.

    The threshold is higher than POSTURE_HI and the dwell longer, because
    that finger is also a continuous control. With two sensors a fist needs
    both curled, so a swell on the index alone can never fire one; with one
    there is nothing to disambiguate it, and the only thing left to separate
    "I am using this as a control" from "I mean a fist" is that a fist is
    bent harder and held.
    """
    if f > POSTURE_SOLO_HI:
        return "fist"
    if f < POSTURE_LO:
        return "open"
    return None


def step_posture(frame, st, synth, fire=None) -> None:
    """One tick of the posture state machine, for either hand.

    The two hands ran identical copies of this and it is fiddly enough that
    two copies is one too many. `fire` is what differs: the same fist means
    "make a sound" on one hand and "freeze" on the other.

    The vote is what makes a single sensor workable. A posture must be held
    for its dwell, and the timer restarts whenever the reading changes — so
    with two sensors, where the thresholds sit far from where a finger rests,
    noise never interrupts it. With one sensor the threshold has to sit near
    the top of the finger's travel, close enough that noise crosses it
    constantly: a deliberate fist held at 0.97 with the measured noise dips
    below 0.90 about one frame in eight, which restarted the dwell every time
    and fired nothing at all. Measured: 0 of 30 deliberate fists detected.
    Taking the majority of the last five reads costs 50 ms and removes it.
    """
    read = _read_posture(frame.flex, frame.flex2)
    st.recent.append(read)
    del st.recent[:-POSTURE_VOTE]
    posture = max(set(st.recent), key=st.recent.count)

    if posture != st.pending:
        st.pending, st.pending_since = posture, frame.t
    if posture is None:
        st.posture = None              # leaving a posture re-arms it
    elif (posture != st.posture and frame.t - st.pending_since
          >= posture_hold(posture, frame.flex, frame.flex2)):
        st.posture = posture
        (fire or _fire_posture)(posture, synth)


def posture_hold(posture: str, flex: float | None, flex2: float | None) -> float:
    """How long a posture must be held before it fires.

    Longer when only one sensor is reporting: that finger is doing two jobs
    at once, so the only protection left is that a posture is deliberate.
    """
    if (flex is None) != (flex2 is None):
        return POSTURE_HOLD_SOLO.get(posture, 1.0)
    return POSTURE_HOLD[posture]


def _fire_posture(posture: str, synth: GloveSynth) -> None:
    if posture == "fist":
        synth.set_gate(True)
    elif posture == "open":
        synth.set_gate(False)
    elif posture == "point":
        synth.next_instrument()


def apply_scene(synth: GloveSynth, state: HandState | None = None,
                announce: bool = True) -> None:
    """Install the current scene: instrument, scale and modes together."""
    st = state or _default
    name, instrument, scale, granular, slices = SCENES[st.scene]
    synth.set_instrument(instrument, announce=False)
    synth.granular_on = granular
    synth.slices_on = slices
    # Harmony picks its third out of the scale, so the scene has to say which
    # one is playing. A minor third over a major scene is the whole reason
    # this is not a fixed interval.
    synth.harmony_scale = scale
    synth.harmony_on = False
    # The new scale may be shorter than the old one.
    st.last_step = min(st.last_step, len(SCALES[scale]) - 1)
    if announce:
        modes = ", ".join(
            m for m, on in (("granular", granular), ("slices", slices)) if on
        )
        print(
            f"\n[scene {st.scene + 1}/{len(SCENES)}: {name} — {instrument}, "
            f"{scale}{', ' + modes if modes else ''}]"
        )


def next_scene(synth: GloveSynth, state: HandState | None = None) -> None:
    st = state or _default
    st.scene = (st.scene + 1) % len(SCENES)
    apply_scene(synth, st)


def apply(frame: SensorFrame, synth: GloveSynth,
          state: HandState | None = None, seq=None) -> None:
    """Map one hand's pose onto the synth.

    `seq` is a melody.Sequencer when a MIDI tune is playing. It owns the
    note, so tilt transposes the piece instead of picking from the scale —
    the only reading of tilt that still means anything once the notes are
    already written. Nothing else changes: filter, pan, volume, postures
    and effects are all about how a note sounds, not which one.
    """
    st = state or _default

    # ---- postures ---------------------------------------------------------
    step_posture(frame, st, synth)

    # Playing implies wanting sound. Bending the index past the posture
    # threshold always re-opens the gate, so an accidental deactivate can
    # never strand you in silence waiting to remember the recovery gesture —
    # you just play, and it comes back.
    if frame.flex is not None and frame.flex > POSTURE_HI:
        synth.set_gate(True)

    # ---- continuous control ----------------------------------------------
    scale = SCALES[SCENES[st.scene][2]]

    # tilt up/down -> index into the scale, with hysteresis so a hand
    # hovering on a boundary holds its note
    if seq is not None:
        # Melody mode: tilt transposes. Same hysteresis as the scale
        # quantizer and for the same reason — a hand resting on a semitone
        # boundary would otherwise retune the whole piece 50 times a second.
        want = _norm(frame.pitch, PITCH_RANGE) * 2.0 - 1.0
        semis = want * seq.TRANSPOSE_RANGE
        if abs(semis - st.last_transpose) > 0.5 + STEP_HYSTERESIS:
            st.last_transpose = int(round(semis))
        seq.transpose = st.last_transpose
    else:
        pos = _norm(frame.pitch, PITCH_RANGE) * (len(scale) - 1)
        if abs(pos - st.last_step) > 0.5 + STEP_HYSTERESIS:
            st.last_step = min(max(int(round(pos)), 0), len(scale) - 1)
        synth.target_freq = midi_to_hz(scale[min(st.last_step, len(scale) - 1)])

    # rotate wrist -> cutoff, exponential so it feels even to the ear
    roll_u = _norm(frame.roll, ROLL_RANGE)
    cutoff = CUTOFF_LO * math.exp(roll_u * math.log(CUTOFF_HI / CUTOFF_LO))
    # Key-follow. The filter is 4-pole now, so a fixed 200 Hz floor would put
    # the top of the scale two octaves below its own corner and bury it. Keep
    # the corner above the fundamental so "dark" means the same thing at every
    # pitch instead of "silent up high".
    synth.target_cutoff = max(cutoff, synth.target_freq * 1.4)

    # point left/right -> pan
    synth.target_pan = 2.0 * _norm(frame.yaw, YAW_RANGE) - 1.0

    # Roll also sweeps a lowpass over a loaded record — this hand's one job
    # on someone else's recording, and the classic filter sweep. Only over a
    # record: on a live mic it would mean this hand reshaping the other
    # hand's voice, which is exactly what the split chains prevent.
    # Open at rest, and only closing as the wrist rolls one way — the
    # centre-detent behaviour of a DJ filter. Spreading the sweep across the
    # whole range instead put a lowpass at 1.9 kHz on a level hand and about
    # 3 kHz on a hand at its natural angle, so a full mix arrived muffled
    # and you had to hold your wrist rolled over just to hear the record.
    synth.target_voice_cutoff = (
        CUTOFF_LO * (VOICE_CUTOFF_HI / CUTOFF_LO) ** min(roll_u / 0.5, 1.0)
        if synth.has_record else 20000.0)

    # index finger bend -> volume, like a breath controller. Without a flex
    # sensor connected, fall back to movement energy.
    if frame.flex is not None:
        u = min(max(frame.flex, 0.0), 1.0) ** FLEX_CURVE
        synth.target_amp = AMP_MAX * 10.0 ** ((u - 1.0) * VOL_RANGE_DB / 20.0)
    else:
        synth.target_amp = 0.12 + 0.35 * min(frame.motion, 1.0)

    # Motion -> how hard a wrist flick lands. Percussion works this way: move
    # faster, hit harder. Previously this hand wrote target_echo, which the
    # loop hand overwrote on the very same tick, so the axis did nothing.
    synth.target_hit = 0.35 + 0.65 * min(frame.motion, 1.0)

    # Single-glove fallback. With no loop hand attached this hand keeps the
    # old duties so nothing regresses; when a loop hand IS driving, it owns
    # these and this must not fight it at the control rate.
    if not synth.voice_hand:
        synth.target_rate = 2.0 ** (2.0 * roll_u - 1.0)
        synth.target_scrub = roll_u
        synth.target_echo = 0.15 + 0.55 * min(frame.motion, 1.0)
        synth.target_voice_pitch = synth.target_rate
        synth.target_voice_volume = 0.9

    # Second finger also adds vibrato while it is not holding a posture. It
    # only reads as "point" with the index straight, i.e. at near-zero volume,
    # so the two uses rarely collide in practice.
    synth.target_vibrato = frame.flex2 if frame.flex2 is not None else 0.0


def handle_event(event: str, synth: GloveSynth,
                 state: HandState | None = None) -> None:
    """Discrete gestures / button presses (drained from the event queue)."""
    st = state or _default
    if event == "punch":
        # A flick also opens the gate. Without flex calibrated there is no
        # other gesture that can start the sound, and on a glove with one
        # working sensor that left the instrument unplayable.
        synth.set_gate(True)
        if synth.slices_on:
            synth.trigger_slice()
        else:
            synth.pluck()
    elif event == "gate_on":
        # What the fist posture does. Reachable from the panel too, because
        # a glove with a dead flex channel cannot make that posture at all.
        synth.set_gate(True)
    elif event == "gate_off":
        synth.set_gate(False)
    elif event == "instrument_next":
        synth.next_instrument()
    elif event == "scene":
        next_scene(synth, st)
    elif event == "record":
        synth.toggle_record()
    elif event == "overdub":
        synth.toggle_overdub()
    elif event == "loop":
        synth.toggle_loop()
    elif event == "granular":
        synth.toggle_granular()
    elif event == "slices":
        synth.toggle_slices()
    elif event == "harmony":
        synth.toggle_harmony()
    elif event == "bounce":
        synth.bounce()
    elif event == "session":
        synth.toggle_session()
    elif event == "export":
        synth.export_loop()
    elif event.startswith("layerfx:"):
        # "layerfx:7:add:reverb" / "layerfx:7:del:1" / "layerfx:7:clear:"
        _, ident, action, value = event.split(":", 3)
        synth.layer_fx(int(ident), action, value)
    elif event.startswith("track:"):
        # "track:mute:7" — the panel addresses a layer by its id, not by the
        # row it is sitting on. Rows are renumbered by every bounce and every
        # delete; ids are not, so a press cannot land on the wrong layer.
        _, what, ident = event.split(":")
        synth.track_action(int(ident), what)
    elif event == "mute":
        synth.toggle_drone()
    elif event == "live":
        synth.toggle_live()
    elif event.startswith("instrument:"):
        synth.set_instrument(event.split(":", 1)[1])
