kethoo/mimu-gloves/glove/synth.py

"""Real-time synth engine.

Runs a PortAudio callback at audio rate (44.1 kHz). The rest of the program
only sets high-level targets (frequency, brightness, pan, volume, pluck);
this module smooths them per-sample so parameter changes never click.
"""

from __future__ import annotations

import datetime
import pathlib
import wave

import numpy as np
import sounddevice as sd

SAMPLE_RATE = 44100
BLOCK = 256  # ~6 ms of audio per callback

# How far the smoothed scrub has to move before the playhead jumps to it,
# in scrub units where 1.0 is the whole 90 degrees of roll.
#
# 0.004 was 0.36 degrees, which is less than a hand trembles: measured, a
# glove lying completely still drifts 3.6 degrees, and a hand trying to
# hold a position moves several. The playhead was being dragged back to
# almost the same spot continuously, so the same fraction of a second
# replayed over and over and sounded like a very short loop.
#
# 0.025 is 2.25 degrees — still a fortieth of the gesture, so a deliberate
# twist seeks immediately, while holding a position lets the track run.
SEEK_MIN_MOVE = 0.025
SEEK_FADE = 0.006          # seconds of fade-in after a jump, to kill the click
# Above this the voice lowpass is bypassed rather than run wide open.
FILTER_OPEN = 15000.0

# How long to crossfade when a layer joins or leaves the mix. Long enough
# that the step is inaudible, short enough that a mute still feels immediate.
MIX_FADE = 0.012

# Above this coefficient the resonant ladder needs its resonance held
# back to stay stable. Below it, the full range is safe.
LADDER_A_SAFE = 0.82

GRAIN_LEN = int(0.09 * SAMPLE_RATE)   # granular mode: 90 ms grains...
GRAIN_HOP = int(0.045 * SAMPLE_RATE)  # ...spawned every 45 ms (2x overlap)

# Harmony mode stacks a third and a fifth on the recording. The third has to
# come from the scene's own scale: +4 semitones is a major third and is wrong
# in a minor key, which is most of them here. Whole-tone has neither a minor
# third nor a perfect fifth, so it takes the intervals it does have.
HARMONY_INTERVALS = {
    "pentatonic": (3, 7),
    "minor":      (3, 7),
    "dorian":     (3, 7),
    "whole":      (4, 8),
}
# Under the original rather than beside it: harmony that matches the lead in
# level stops sounding like harmony and starts sounding like three takes.
HARMONY_GAIN = 0.55
# Three voices at different pitches are uncorrelated, so they sum in power
# rather than amplitude and the chord lands about a quarter louder than the
# same take played plain. Trimmed back by that much, so switching into
# harmony is heard as harmony and not as someone turning it up.
HARMONY_TRIM = 1.0 / (1.0 + 2.0 * HARMONY_GAIN ** 2) ** 0.5

# A session is held in memory until it stops, at about 21 MB a minute. Ten
# minutes is longer than anything anyone has played here and still small
# enough that forgetting to stop costs nothing worse than a large file.
SESSION_MAX = 10 * 60 * SAMPLE_RATE


def _recordings_dir() -> pathlib.Path:
    d = pathlib.Path(__file__).parent.parent / "recordings"
    d.mkdir(exist_ok=True)
    return d


def _stamp() -> str:
    return datetime.datetime.now().strftime("%Y-%m-%d-%H%M%S")


def _write_wav(path: pathlib.Path, data: np.ndarray) -> None:
    """16-bit WAV, mono or stereo depending on the array's shape.

    Scaled rather than clipped when it is too loud: a performance that ran
    hot should come back quieter, not squared off.
    """
    data = np.asarray(data, dtype=np.float64)
    channels = 1 if data.ndim == 1 else data.shape[1]
    peak = float(np.abs(data).max()) if data.size else 0.0
    if peak > 0.99:
        data = data * (0.99 / peak)
    with wave.open(str(path), "wb") as w:
        w.setnchannels(channels)
        w.setsampwidth(2)
        w.setframerate(SAMPLE_RATE)
        w.writeframes((np.clip(data, -1, 1) * 32767).astype("<i2").tobytes())
N_SLICES = 4                          # slice mode: recording split into 4 pads
VIBRATO_HZ = 5.5                      # wobble speed, roughly a singer's
VIBRATO_DEPTH = 0.02                  # max pitch swing (+/-2%, ~a third of
                                      # a semitone). Raise for a seasick
                                      # effect, lower for a subtle one.

PS_BUF = 1 << 16                     # live voice: ring buffer (~1.5 s)
PS_WIN = 2048                        # pitch-shifter tap window (~46 ms)
# How close to unity counts as "no shift at all". 0.004 is about 7 cents,
# well under what anyone hears as a pitch change, and inside it the shifter
# is faded out: see _pitch_shift for why it cannot be left running there.
PS_UNITY = 0.004

# ---- voice hand (second glove) ----------------------------------------
# Schroeder reverb: four parallel combs summed into two series allpasses.
# Every delay here is longer than BLOCK on purpose — that is what lets the
# whole reverb stay vectorized. A delay shorter than one block would need the
# previous output *within* the same block and force a per-sample loop, which
# is why the two short Freeverb allpasses (341, 225) are not used.
REVERB_COMBS = (1116, 1188, 1277, 1356)
REVERB_APS = (556, 441)
REVERB_FB = 0.90          # comb feedback. Measured T60 ~1.45 s, a hall
                          # rather than a room; roll dials the wet amount.
REVERB_AP_G = 0.5         # allpass coefficient: diffusion

VOICE_DELAY = int(0.28 * SAMPLE_RATE)   # "point" delay time. Its feedback is
                                        # target_echo, i.e. hand motion — wave
                                        # and the repeats ring on longer.
STUTTER_LEN = int(0.15 * SAMPLE_RATE)   # wrist flick grabs this much
STUTTER_HOLD = int(0.70 * SAMPLE_RATE)  # ...and repeats it for this long


def _ring_read(buf: np.ndarray, i: int, frames: int) -> np.ndarray:
    """Read `frames` samples from a circular buffer, handling one wrap."""
    n = len(buf)
    if i + frames <= n:
        return buf[i:i + frames]
    k = n - i
    return np.concatenate((buf[i:], buf[:frames - k]))


def _ring_write(buf: np.ndarray, i: int, data: np.ndarray) -> None:
    n = len(buf)
    frames = len(data)
    if i + frames <= n:
        buf[i:i + frames] = data
    else:
        k = n - i
        buf[i:] = data[:k]
        buf[:frames - k] = data[k:]

FILTER_RES = 1.1     # ladder feedback; higher = more resonant peak at cutoff
# Samples kept for the on-screen waveform and spectrum. 2048 at 44.1 kHz is
# 46 ms: long enough to resolve down to about 40 Hz, short enough that the
# display still looks live rather than averaged.
SCOPE_LEN = 2048

KS_MAX = 2048        # plucked string: longest delay line (lowest note)
KS_GAIN = 2.4        # the string sits quieter than the oscillators; match it

# Karplus-Strong voices: (T60 seconds, loop-filter weight).
# The weight is how much of the *current* sample the loop keeps versus the
# previous one. The classic 0.5 is a plain two-point average, which dulls the
# string fast — right for an acoustic pluck. An electric string is driven by a
# magnetic pickup rather than radiating into a soundboard, so it keeps its
# highs and rings far longer: a higher weight, and a much longer T60.
KS_VOICES = {
    "pluck":  (2.0, 0.50),
    "guitar": (5.0, 0.86),
}

GUITAR_DRIVE = 11.0     # preamp gain into the clipper
GUITAR_PICKUP = 0.21    # tap position along the string (bridge-ish, nasal)
GUITAR_CAB_LO = 90.0    # speaker rolls off below this...
GUITAR_CAB_HI = 4200.0  # ...and hard above this. Without it: fizz.

INSTRUMENTS = {
    "saw": "Saw Lead",
    "organ": "Organ",
    "strings": "String Pad",
    "bell": "FM Bell",
    "flute": "Flute",
    "pluck": "Plucked String",
    "guitar": "Electric Guitar",
}

# Per-instrument amplitude envelope: (attack s, decay s, sustain 0..1, struck).
#
# This table matters more than the harmonic recipes below. Without it every
# instrument is a constant-amplitude drone, and a bell that never rings out
# is not a bell — the ear identifies an instrument mostly by its attack
# transient and decay shape, not by its steady-state spectrum.
#
# "struck" means the note is re-articulated rather than glided into: the
# pitch snaps instead of sliding, and a punch re-strikes it.
ENVELOPES = {
    #            attack  decay  sustain  struck
    "saw":     (  0.010,  0.30,    0.72,  False),
    "organ":   (  0.004,  0.02,    1.00,  False),  # organs are on/off
    "strings": (  0.350,  0.50,    0.85,  False),  # slow bow
    "bell":    (  0.002,  2.20,    0.00,   True),  # struck, rings out
    "flute":   (  0.100,  0.20,    0.88,  False),  # breath takes time
    "pluck":   (  0.001,  0.01,    1.00,   True),  # string decays on its own
    "guitar":  (  0.001,  0.01,    1.00,   True),  # ditto, plus the amp
}


def _poly_saw(p: np.ndarray, dt: float) -> np.ndarray:
    """Band-limited sawtooth from a phase ramp (PolyBLEP).

    A raw `2*p - 1` ramp has unlimited harmonics, and every one above Nyquist
    folds back down as inharmonic grit — measured at 55% of total energy for
    the four-saw string pad at the top of the scale, which is most of what
    made it sound harsh. Smoothing the wrap discontinuity with a two-sample
    polynomial removes the bulk of it for a couple of array ops.
    """
    s = 2.0 * p - 1.0
    if dt <= 0.0:
        return s
    lo = p < dt
    if lo.any():
        x = p[lo] / dt
        s[lo] -= x + x - x * x - 1.0
    hi = p > 1.0 - dt
    if hi.any():
        x = (p[hi] - 1.0) / dt
        s[hi] -= x * x + x + x + 1.0
    return s


class GloveSynth:
    def __init__(self, input_device=None, output_device=None,
                 no_mic: bool = False, open_stream: bool = True) -> None:
        # PortAudio binds a stream to whatever device was default when the
        # stream was *created*. Switching the system default afterwards (say,
        # connecting AirPods mid-session) does not move an already-open
        # stream, which is why audio can keep coming out of the laptop.
        # Passing devices explicitly also lets output and input be different
        # hardware — AirPods out, laptop mic in — which matters because using
        # AirPods as an input forces them into a 24 kHz hands-free mode that
        # noticeably degrades what you hear.
        self._devices = (input_device, output_device)
        # Targets, written by the control thread at ~100 Hz.
        self.target_freq = 220.0     # Hz
        self.target_cutoff = 1000.0  # Hz, lowpass brightness
        self.target_pan = 0.0        # -1 left .. +1 right
        self.target_amp = 0.25       # 0..1
        self.target_rate = 1.0       # voice-loop playback speed (0.5..2)
        self.target_scrub = 0.5      # granular position / slice selector, 0..1
        self.target_vibrato = 0.0    # pitch wobble depth, 0..1 (second finger)
        self.target_hit = 1.0        # wrist-flick velocity, from hand motion

        # Smoothed values owned by the audio callback.
        self._freq = self.target_freq
        self._cutoff = self.target_cutoff
        self._pan = self.target_pan
        self._amp = 0.0
        self._rate = 1.0

        self.instrument = "saw"
        # Phase accumulators: one per oscillator, kept across blocks so a
        # pitch change does not restart a partial mid-cycle and click. Six,
        # because a designed additive instrument stacks six partials; the
        # built-ins use at most four.
        self._ph = [0.0] * 6
        self._scope = np.zeros(SCOPE_LEN)
        self._blocks = 0            # see blocks_rendered
        self._wave_cache: list = []
        self._wave_for = None
        self._fenv = 0.0        # see _note_on
        self._lfo = 0.0           # vibrato LFO phase (flute)
        self._vib = 0.0           # vibrato LFO phase (finger-controlled)
        self._vibDepth = 0.0      # smoothed depth
        self._lp = [0.0, 0.0, 0.0, 0.0]  # four-pole ladder filter state
        self._pluck_env = 0.0     # decaying envelope for percussive hits
        self._pluck_lp = 0.0
        self._rng = np.random.default_rng()

        # Note articulation. mapping.py quantizes roll to a scale, so
        # target_freq moves in discrete steps and each step is a note-on.
        self._note_freq = 0.0     # 0 => the first block articulates a note
        self._env = 0.0           # amplitude envelope level
        self._env_stage = 0       # 0 = attack, 1 = decay/sustain
        self._chiff = 0.0         # flute breath-onset burst

        # Karplus-Strong string: a delay line one wavelength long, fed back
        # through a two-point average. The averaging is a lowpass, so every
        # pass round the loop dulls the tone a little — which is what a real
        # string does as it rings.
        self._ks_buf = np.zeros(KS_MAX)
        self._ks_n = 200          # current delay length, in samples
        self._ks_i = 0            # read/write position
        self._ks_prev = 0.0       # previous sample, for the averaging filter
        self._ks_decay = 1.0      # per-pass loop gain
        self._ks_b = 0.5          # loop-filter weight (see KS_VOICES)
        self._cab = [0.0, 0.0, 0.0]  # guitar speaker filter state

        # Voice loop: recorded from the mic, replayed through the same
        # gesture-controlled filter/pan chain as the oscillator.
        # Silent until played. An instrument that sounds the moment you
        # launch it is just noise you have to go and switch off — a fist, a
        # bent finger or `m` starts it.
        self.drone_on = False
        # Instruments you designed, loaded from instruments.json. Read before
        # the first note, because envelope() consults it on every block.
        import glove.instruments as _instruments

        self.customs = _instruments.load()
        # Muted on purpose, as opposed to merely gated off. Loading a record
        # sets this, so the hands shape the record instead of playing a synth
        # over it; 'm' brings the instrument back to play along.
        self.instrument_off = False
        # Playback direction, and the bookkeeping for roll-to-seek.
        self.reverse = False
        self.pitch_lock = False     # tilt moves pitch only, speed stays 1x
        self._scrub_held = 0.5      # scrub value the playhead was last set to
        self._seek_fade = 1.0       # 0..1 fade-in after a seek
        self.loop_on = False
        self.loop_label = "glove take"   # what the panel calls what is loaded
        self.take_status = ""            # how the last take ended, for the page
        self._track_seq = 0              # layer ids, never reused
        # Layers playing past the effects rather than through them.
        self._dry_buf: np.ndarray | None = None
        self._dry_pos = 0.0        # its own playhead: scrubbing the wet
        self._dry_old = None       # layers must not drag the dry ones with it
        self._dry_fade = 1.0
        self._loop_buf: np.ndarray | None = None
        self._loop_pos = 0.0
        self._rec_stream: sd.InputStream | None = None
        self._rec_chunks: list[np.ndarray] = []
        self._overdub = False
        self._overdub_from = 0.0  # loop position when the overdub started

        # Layers, kept apart. Overdub used to sum the new take straight into
        # the buffer, which made a layer unrecoverable the moment it landed:
        # you could add to a loop but never take anything back out of it.
        # Each take is its own array now and `_loop_buf` is their mix, so
        # muting one is a question of leaving it out of that sum.
        #
        # The mix is cached rather than built per block. Nothing downstream
        # knows the difference — every mode still reads `_loop_buf` — and the
        # audio callback does no extra work at all.
        self._tracks: list[dict] = []
        self._mix_old = None       # the mix being faded out of, if any
        self._mix_fade = 1.0       # 1.0 means no crossfade in progress

        # Bounce: write what you are hearing back into the recording. Until
        # this existed a gesture only ever shaped playback, so every effect
        # applied to the whole buffer at once and a second layer could not be
        # shaped differently from the first.
        self._bounce: list[np.ndarray] | None = None
        self._bounce_left = 0

        # Session recording: the finished stereo output, kept in memory while
        # it runs. Nothing in the instrument survived quitting before this —
        # a performance only existed while it was being played.
        self._session: list[np.ndarray] | None = None
        self._session_frames = 0
        self._session_full = False

        # Granular mode: the loop becomes a cloud of short windowed grains
        # drawn from wherever the hand is "pointing" in the recording.
        self.granular_on = False
        self._scrub = 0.5
        self._grains: list[list[int]] = []  # [start_sample, age] per grain
        self._grain_timer = 0
        self._grain_win = np.hanning(GRAIN_LEN)

        # Harmony mode: the same grains, read again at two higher pitches and
        # mixed under the original, so the take sings a chord against itself.
        # It rides on granular because that is the only path where pitch is
        # independent of time: a second reader at 1.5x speed on the ordinary
        # loop would also run through the buffer half again as fast and drift
        # away from the voice it is supposed to be harmonising.
        self.harmony_on = False
        self.harmony_scale = "pentatonic"   # mapping.apply_scene sets this

        # Slice mode: punches fire one-shot chunks of the recording.
        self.slices_on = False
        self._shot: list[int] | None = None  # [slice_start, play_pos, end]

        # Live voice mode: mic streams straight through a granular pitch
        # shifter + echo, warped by gestures as you speak.
        self.live_on = False
        self.target_echo = 0.2       # echo feedback, driven by hand motion
        self._live_in: np.ndarray | None = None
        self._ps_buf = np.zeros(PS_BUF)
        self._ps_w = 0               # ring-buffer write position
        self._ps_phase = 0.0         # tap-window phase, 0..1
        self._pshift = 1.0           # smoothed pitch ratio
        self._gate = 0.0             # noise-gate envelope follower
        self._echo_fb = 0.2   # smoothed delay feedback, driven by motion

        # ---- voice hand (second glove) --------------------------------
        # Disjoint from the instrument targets on purpose: two gloves control
        # two parameter sets, so the voice never passes through the
        # instrument's ladder filter or pan.
        self.voice_hand = False       # True once a voice glove is driving us
        # Where the voice chain gets its audio. BLE cannot carry live audio
        # (16 kHz mono needs 32 kB/s against a link measured at 30 kB/s with
        # the sensor stream already switched off, and the latency would be
        # 100 ms+), so the glove's own mic reaches us as recorded takes. With
        # this set, those takes feed the voice effects instead of the
        # instrument bus — the source is the board's microphone, the control
        # is the voice hand, they just are not simultaneous.
        # Automatic: the loop hand shapes the recording when there is one,
        # and the live microphone when there is not. It is always the "space
        # and time" hand; it simply has more to do once material exists.
        self.voice_from_loop = True
        # Loop-hand freeze: hold the current grab indefinitely rather than
        # letting it decay like a wrist-flick stutter does.
        self.freeze_on = False
        self._st_hold = False
        # Stereo width from the two hands' relative roll. 0 = mono,
        # 1 = normal, 2 = wide. Neither hand can express this alone.
        self.target_width = 1.0
        self._width = 1.0
        self.voice_fx_on = True       # fist on / open hand = dry
        self.voice_delay_on = False   # "point" toggles it
        self.target_voice_pitch = 1.0     # 0.5 (octave down) .. 2.0 (up)
        # Lowpass over a loaded record, driven by the LIVE hand's roll: the
        # one job that hand has on someone else's recording. Off by default
        # and skipped entirely above FILTER_OPEN, so the per-sample loop it
        # costs is only paid while the filter is actually doing something.
        self.target_voice_cutoff = 20000.0
        self._v_cutoff = 20000.0
        self._v_lp = [0.0, 0.0]
        self.target_voice_reverb = 0.25   # 0..1 wet
        self.target_voice_pan = 0.0       # -1..+1
        self.target_voice_volume = 0.6    # 0..1
        self._v_pitch = 1.0
        self._v_reverb = 0.25
        self._v_pan = 0.0
        self._v_vol = 0.6

        # Reverb: parallel combs -> series allpasses.
        self._rv_comb = [np.zeros(d) for d in REVERB_COMBS]
        self._rv_comb_i = [0] * len(REVERB_COMBS)
        self._rv_comb_prev = [0.0] * len(REVERB_COMBS)
        self._rv_ap = [np.zeros(d) for d in REVERB_APS]
        self._rv_ap_i = [0] * len(REVERB_APS)

        # "Point" delay, separate from the legacy live-mode echo.
        self._vd_buf = np.zeros(VOICE_DELAY + BLOCK)
        self._vd_w = 0

        # Wrist-flick stutter: a rolling history to grab from, the grabbed
        # slice itself, and how much longer to keep repeating it.
        self._st_hist = np.zeros(STUTTER_LEN)
        self._st_hw = 0
        self._st_buf = np.zeros(STUTTER_LEN)
        self._st_left = 0
        self._st_pos = 0

        # Duplex stream (mic in + speakers out in one callback) so live
        # mode works; fall back to output-only if there's no input device.
        # `no_mic` forces that fallback: a duplex stream can open cleanly and
        # then never call back when the OS has not granted microphone
        # access, which is silence with nothing reporting a fault.
        # measure.py builds the engine without a sound card, so the deadline
        # it reports is the engine's own cost and not the driver's mood.
        if not open_stream:
            self._stream = None
            self._has_input = False
            return
        try:
            if no_mic:
                raise RuntimeError("--no-mic")
            self._stream = sd.Stream(
                samplerate=SAMPLE_RATE,
                blocksize=BLOCK,
                channels=(1, 2),
                dtype="float32",
                device=self._devices,
                callback=self._duplex_callback,
            )
            self._has_input = True
        except Exception as exc:
            print(f"[output only, live voice mode disabled: {exc}]")
            self._stream = sd.OutputStream(
                samplerate=SAMPLE_RATE,
                blocksize=BLOCK,
                channels=2,
                dtype="float32",
                device=output_device,
                callback=self._callback,
            )
            self._has_input = False

    def loop_wave(self, points: int = 240) -> list:
        """Peak envelope of the loaded loop, for the deck's waveform.

        Cached against the buffer it was built from: this walks the whole
        recording, which for a four-minute track is ten million samples,
        and the panel asks for it ten times a second.
        """
        buf = self._loop_buf
        if buf is None or len(buf) < 2:
            return []
        if self._wave_for is buf and self._wave_cache:
            return self._wave_cache
        n = min(points, len(buf))
        edges = np.linspace(0, len(buf), n + 1).astype(np.intp)
        peaks = np.maximum.reduceat(np.abs(buf), edges[:-1])
        top = float(peaks.max()) or 1.0
        self._wave_cache = [round(float(v / top), 3) for v in peaks]
        self._wave_for = buf
        return self._wave_cache

    @property
    def loop_position(self) -> float:
        """Seconds into the loop, for the playhead."""
        if self._loop_buf is None or len(self._loop_buf) < 2:
            return 0.0
        return float(self._loop_pos) / SAMPLE_RATE

    def scope(self, points: int = 160, bins: int = 56) -> dict:
        """Waveform and spectrum for the panel.

        Computed here rather than in the callback. The waveform is
        trigger-aligned on a rising zero crossing, which is what stops it
        sliding sideways and makes a shape readable instead of a blur.
        """
        buf = self._scope
        peak = float(np.abs(buf).max())
        if peak < 1e-5:
            return {"wave": [0.0] * points, "spec": [0.0] * bins, "peak": 0.0}

        # Trigger: first upward zero crossing in the first half.
        half = len(buf) // 2
        seg = buf[:half]
        crossings = np.nonzero((seg[:-1] <= 0) & (seg[1:] > 0))[0]
        start = int(crossings[0]) if len(crossings) else 0
        win = buf[start:start + half]
        if len(win) < half:
            win = buf[:half]
        idx = np.linspace(0, len(win) - 1, points).astype(np.intp)
        wave = [float(v) for v in (win[idx] / max(peak, 1e-6))]

        # Spectrum on log-spaced bands, in dB — linear bins put almost
        # everything musical in the leftmost pixels.
        mag = np.abs(np.fft.rfft(buf * np.hanning(len(buf))))
        freqs = np.fft.rfftfreq(len(buf), 1.0 / SAMPLE_RATE)
        edges = np.geomspace(40.0, 16000.0, bins + 1)
        spec = []
        for lo, hi in zip(edges[:-1], edges[1:]):
            sel = (freqs >= lo) & (freqs < hi)
            v = float(mag[sel].max()) if sel.any() else 0.0
            db = 20.0 * np.log10(max(v, 1e-6) / max(mag.max(), 1e-6))
            # float(), not np.float64: json.dumps cannot serialise numpy
            # scalars and the whole state message would fail to send.
            spec.append(float(max(0.0, 1.0 + db / 70.0)))   # -70 dB -> 0..1
        return {"wave": wave, "spec": spec, "peak": round(peak, 4)}

    def describe_devices(self) -> str:
        """Which hardware the stream actually bound to. Printed at startup
        because 'why is the sound coming out of the wrong thing' is otherwise
        invisible."""
        try:
            dev = self._stream.device
            names = []
            for d, role in zip(
                dev if isinstance(dev, (list, tuple)) else [dev],
                ("in", "out") if self._has_input else ("out",),
            ):
                names.append(f"{role}: {sd.query_devices(d)['name']}")
            return "  |  ".join(names)
        except Exception:
            return "unknown"

    @property
    def blocks_rendered(self) -> int:
        """How many audio blocks the device has actually asked for.

        A stream can start without error and then never call back — on
        macOS a duplex stream whose microphone permission was never granted
        does exactly that. Silence with everything reporting healthy is the
        worst failure to diagnose, so this is here to be checked.
        """
        return self._blocks

    def start(self) -> None:
        self._stream.start()

    def stop(self) -> None:
        self._stream.stop()
        self._stream.close()

    def pluck(self) -> None:
        """Trigger a percussive hit (wrist flick). On a struck instrument it
        also re-articulates the note, so a flick re-rings the bell or
        re-plucks the string instead of only firing the drum layer.

        Velocity comes from how fast the hand was moving, which is how
        percussion actually works — every hit used to land at exactly the
        same level.
        """
        self._pluck_env = min(max(self.target_hit, 0.0), 1.0)
        if self.envelope()[3]:
            self._note_on()

    def _note_on(self) -> None:
        """Articulate a new note.

        Struck instruments restart from silence. The sustained ones re-enter
        the attack from wherever the envelope already is, so a run of notes
        is legato — resetting them to zero would gate the sound off on every
        step, and a 350 ms pad would never get to full level while the hand
        was moving.
        """
        self._env_stage = 0
        self._chiff = 1.0
        self._fenv = 1.0        # filter envelope, decays on its own clock
        if self.envelope()[3]:
            self._env = 0.0
            patch = self.custom
            if self.instrument in KS_VOICES or (
                    patch is not None and patch["engine"] == "string"):
                self._ks_pluck()

    @property
    def custom(self) -> dict | None:
        """The patch behind the selected instrument, or None for a built-in."""
        return self.customs.get(self.instrument)

    def envelope(self, name: str | None = None):
        """(attack, decay, sustain, struck) for any instrument, built-in or
        designed. One accessor so the callback never has to know which."""
        name = name or self.instrument
        patch = self.customs.get(name)
        if patch is None:
            return ENVELOPES.get(name, ENVELOPES["saw"])
        return (patch["attack"], patch["decay"], patch["sustain"],
                patch["struck"])

    def reload_customs(self) -> None:
        from glove import instruments
        self.customs = instruments.load()
        if self.instrument not in INSTRUMENTS and self.instrument not in self.customs:
            self.set_instrument("saw", announce=False)

    def all_instruments(self) -> dict:
        """Built-ins first, then yours — the order the point gesture walks."""
        return {**INSTRUMENTS, **{k: k for k in sorted(self.customs)}}

    def set_instrument(self, name: str, announce: bool = True) -> None:
        names = self.all_instruments()
        if name in names:
            self.instrument = name
            self._note_on()  # so you hear the new instrument's attack
            if announce:
                print(f"\n[instrument: {names[name]}]")

    def next_instrument(self) -> None:
        """Step to the next instrument (the 'point' posture)."""
        names = list(self.all_instruments())
        if self.instrument not in names:
            self.instrument = names[0]
        self.set_instrument(names[(names.index(self.instrument) + 1) % len(names)])

    def set_gate(self, on: bool) -> None:
        """Fist activates the sound, an open hand deactivates it. Distinct
        from toggle_drone only in being absolute rather than a toggle, which
        is what a posture needs: holding a fist must always mean 'on'.

        Silenced deliberately, it stays silenced. Without that, muting the
        instrument to hear a loaded track lasted until the next gesture:
        bending the index finger to set the track's volume re-opened the
        gate and the synth came straight back over the top of the music.
        """
        if self.instrument_off:
            return
        if on != self.drone_on:
            self.drone_on = on
            print("\n[sound ON]" if on else "\n[sound OFF — make a fist, or just play]")

    def mute_instrument(self, off: bool) -> None:
        """Silence the synth itself, as opposed to closing the gate.

        The two are different intentions: a gate is part of playing, and
        every playing gesture may reopen it, while this is a decision about
        whether the instrument is in the piece at all.
        """
        self.instrument_off = bool(off)
        if off:
            self.drone_on = False

    @property
    def is_recording(self) -> bool:
        return self._rec_stream is not None

    @property
    def loop_seconds(self) -> float:
        return 0.0 if self._loop_buf is None else len(self._loop_buf) / SAMPLE_RATE

    def toggle_record(self) -> None:
        """Start/stop recording the mic; the take replaces the voice loop.
        Later this is the glove button.
        """
        if self._rec_stream is None:
            self._start_recording(overdub=False)
        else:
            self._stop_recording()

    @property
    def is_bouncing(self) -> bool:
        return self._bounce is not None

    @property
    def is_recording_session(self) -> bool:
        return self._session is not None

    @property
    def session_seconds(self) -> float:
        return self._session_frames / SAMPLE_RATE if self._session else 0.0

    def toggle_session(self) -> None:
        """Start or stop recording the performance to a file."""
        if self._session is None:
            self._session, self._session_frames = [], 0
            self._session_full = False
            print(f"\n[recording the session — press again to stop "
                  f"(stops itself after {SESSION_MAX // SAMPLE_RATE // 60} min)]")
            return
        blocks, self._session = self._session, None
        if not blocks:
            print("\n[session: nothing recorded]")
            return
        audio = np.concatenate(blocks)
        path = _recordings_dir() / f"session-{_stamp()}.wav"
        _write_wav(path, audio)
        print(f"\n[session saved — {path} "
              f"({len(audio) / SAMPLE_RATE / 60:.0f}m "
              f"{len(audio) / SAMPLE_RATE % 60:04.1f}s)]")

    def maybe_finish_session(self) -> None:
        """Stop a session that reached the cap. Called from the control loop,
        because the callback cannot be the thing that opens a file."""
        if self._session_full and self._session is not None:
            self._session_full = False
            print(f"\n[session reached the "
                  f"{SESSION_MAX // SAMPLE_RATE // 60} minute limit]")
            self.toggle_session()

    def export_loop(self) -> None:
        """Write the loop itself out, layers, bounces and all."""
        buf = self._loop_buf
        if buf is None or len(buf) < 2:
            print("\n[nothing to export — record something first with 'v']")
            return
        path = _recordings_dir() / f"loop-{_stamp()}.wav"
        _write_wav(path, buf)
        print(f"\n[loop exported — {path} ({len(buf) / SAMPLE_RATE:.1f}s). "
              f"Load it again with:  python main.py --web --song {path.name}]")

    def bounce(self) -> None:
        """Write what you are hearing back into the recording.

        Harmony, granular, the slices and the effects all live outside the
        buffer and shape it on the way out, which means they apply to every
        layer at once. Capturing one cycle of the processed output and making
        it the recording is what lets the next layer be shaped differently
        from this one — the usual looper move, under its usual name.
        """
        if self._loop_buf is None or len(self._loop_buf) < 2:
            print("\n[nothing to bounce — record something first with 'v']")
            return
        if self._bounce is not None:
            self._bounce = None
            print("\n[bounce cancelled]")
            return
        self._bounce = []
        self._bounce_left = len(self._loop_buf)
        self._loop_pos = 0.0          # capture from the top, not mid-phrase
        self._scrub_held = self._scrub
        self.loop_on = True
        print(f"\n[bouncing one cycle — "
              f"{len(self._loop_buf) / SAMPLE_RATE:.1f}s, hold still...]")

    def _capture_bounce(self, block: np.ndarray) -> None:
        """Collect processed output until a whole loop has gone past."""
        take = block[: self._bounce_left]
        self._bounce.append(take.copy())
        self._bounce_left -= len(take)
        if self._bounce_left > 0:
            return

        baked = np.concatenate(self._bounce)
        self._bounce = None
        peak = float(np.abs(baked).max())
        if peak < 1e-5:
            print("\n[bounce: nothing was playing — loop left as it was]")
            return
        baked *= 0.5 / peak
        self.loop_on = False          # keep the callback off the swap
        self._tracks = []             # the layers are in the samples now
        self._loop_pos = 0.0
        self._shot = None
        self.add_track(baked, "bounced")
        # Those effects are in the samples now. Leaving the modes on would
        # apply them to their own output a second time.
        self.harmony_on = self.granular_on = self.slices_on = False
        self.reverse = False
        print(f"\n[bounced — {len(baked) / SAMPLE_RATE:.1f}s. What you heard "
              "is now the recording; layer on top of it with 'o']")

    def toggle_overdub(self) -> None:
        """Like record, but the take is layered ON TOP of the playing loop,
        aligned to where the loop was when the overdub started.
        """
        if self._rec_stream is not None:
            self._stop_recording()
        elif self._loop_buf is None:
            self.toggle_record()  # nothing to layer onto yet: plain record
        else:
            self._start_recording(overdub=True)

    def _start_recording(self, overdub: bool) -> None:
        self._rec_chunks = []
        self._overdub = overdub
        self._overdub_from = self._loop_pos
        self._rec_stream = sd.InputStream(
            samplerate=SAMPLE_RATE,
            channels=1,
            dtype="float32",
            callback=lambda indata, *_: self._rec_chunks.append(indata.copy()),
        )
        self._rec_stream.start()
        print(
            "\n[overdubbing on top of the loop... press o again to stop]"
            if overdub
            else "\n[recording mic... press v again to stop]"
        )

    def _stop_recording(self) -> None:
        self._rec_stream.stop()
        self._rec_stream.close()
        self._rec_stream = None
        # Every way this can end says so on the page as well as in the
        # terminal. A take that is thrown away is the one outcome you most
        # need told about, and it was the one that only ever appeared in a
        # console nobody is looking at while playing: from the browser it
        # looked like pressing the button had simply done nothing.
        if not self._rec_chunks:
            self.take_status = "nothing recorded — the microphone sent no audio"
            print("\n[nothing recorded]")
            return
        take = np.concatenate(self._rec_chunks)[:, 0]
        peak = float(np.abs(take).max())
        if peak < 1e-3:
            self.take_status = (
                f"take discarded: almost silent (peak {peak:.5f}). "
                "Check mic permission in System Settings > Privacy & "
                "Security > Microphone")
            print(
                "\n[take was almost silent (peak "
                f"{peak:.5f}) — discarded. Check mic permission in "
                "System Settings > Privacy & Security > Microphone]"
            )
            return
        # Normalize to 0.5 peak, but cap the boost so a faint take doesn't
        # become amplified room hiss.
        take *= min(0.5 / peak, 40.0)

        if self._overdub and self._loop_buf is not None:
            # Mix into a copy starting where the loop was at record start,
            # wrapping around, then swap the copy in.
            self.add_track(take, f"take {len(self._tracks) + 1}",
                           at=self._overdub_from)
            self.take_status = (f"layer {len(self._tracks)} added — "
                                f"{len(self._tracks)} layers now")
            print(f"\n[layer {len(self._tracks)} added — "
                  f"{self.layer_summary()}]")
        else:
            self.loop_on = False  # keep the callback off the buffer while we swap it
            self._tracks = []
            self._loop_pos = 0.0
            self._shot = None
            self.add_track(take, "take 1")
            # Said plainly, because this is the button people reach for when
            # they meant to add: a new take starts the stack over, and the
            # layers that were there are gone.
            self.take_status = (
                f"take 1 recorded, {len(take) / SAMPLE_RATE:.1f}s — this "
                "replaced the stack. Use Overdub to add a layer instead")
            print(f"\n[{len(take) / SAMPLE_RATE:.1f}s recorded — looping; move your hand to shape it]")

    # ---- layers ---------------------------------------------------------

    @property
    def soloing(self) -> bool:
        return any(t["solo"] for t in self._tracks)

    def _audible(self, t: dict) -> bool:
        """Solo wins over mute, the way it does on every mixer: the moment
        anything is soloed, everything else is out whatever its own flag."""
        return t["solo"] if self.soloing else not t["muted"]

    def _remix(self) -> None:
        """Rebuild the mix from the layers that are audible.

        Called when the set of layers changes, never per block. The new array
        is built whole and then swapped in, so the callback is never reading
        one that is half written.
        """
        prev = self._loop_buf
        live = [t for t in self._tracks if self._audible(t)]
        if not self._tracks:
            self.loop_on = False
            self._loop_buf = None
            self._dry_buf = None
            self._grains, self._shot = [], None
            return
        n = len(self._tracks[0]["buf"])
        # Headroom comes from the whole stack, not from the layers that
        # happen to be audible right now. Scaling the audible sum instead
        # made every mute 3 dB louder for everyone else — measured — which
        # is not what a mute does on any mixer: you take one part out and
        # the rest stay exactly where you set them. Adding a layer still
        # lowers the lot, and deleting one still raises them, because then
        # the stack itself has genuinely changed.
        full = np.zeros(n)
        for t in self._tracks:
            full += t["buf"] * t["level"]
        # Split rather than summed: a layer with FX off is kept out of the
        # buffer the effects read and played back alongside it instead. The
        # chain still runs exactly once, so this costs one array and no DSP
        # — the alternative, a whole chain per layer, would mean a reverb
        # and a delay line each and would break the one rule this instrument
        # is built on, that there is exactly one of each parameter.
        mix = np.zeros(n)
        dry = np.zeros(n)
        has_dry = False
        for t in self._tracks:
            if not self._audible(t):
                continue
            if t.get("fx", True):
                mix += t["buf"] * t["level"]
            else:
                dry += t["buf"] * t["level"]
                has_dry = True
        peak = float(np.abs(full).max())
        if peak > 0.9:
            mix *= 0.9 / peak
            dry *= 0.9 / peak
        prev_dry = self._dry_buf
        self._loop_buf = mix
        self._dry_buf = dry if has_dry else None
        if prev_dry is not None and self._dry_buf is not None \
                and len(prev_dry) == len(dry):
            self._dry_old, self._dry_fade = prev_dry, 0.0
        # Grains are not touched. Each one holds the mix it was drawn from,
        # so the ones in flight finish on the old sum and fade out through
        # their own window. Cutting them was measured at four times any
        # other jump in the block.
        # Taking a layer out changes the waveform under the playhead, which
        # is a step discontinuity and so a click: measured at seven times any
        # other jump in the block. Borrowing the seek fade made it worse,
        # because that ramps up from silence and the drop to silence is
        # itself a bigger step. The old mix is kept instead and the two are
        # crossfaded, which is the only version with nothing to hear.
        if prev is not None and len(prev) == len(mix):
            self._mix_old, self._mix_fade = prev, 0.0

    def add_track(self, samples: np.ndarray, label: str, at: float = 0.0) -> None:
        """Add a layer. The first one sets the loop's length; later ones wrap
        into it from wherever the loop was when they started."""
        samples = np.asarray(samples, dtype=np.float64)
        if not self._tracks:
            buf = samples.copy()
        else:
            n = len(self._tracks[0]["buf"])
            buf = np.zeros(n)
            idx = (int(at) + np.arange(len(samples))) % n
            np.add.at(buf, idx, samples)
        # Every layer gets an id that is never reused. Positions are, and a
        # position is not a safe thing to send a command to: bounce and
        # delete both renumber the rows, so a button pressed against the
        # list as it was a moment ago would land on whichever layer had
        # moved into that slot. That is how a freshly bounced take ended up
        # muted by a click meant for a layer that no longer existed.
        self._track_seq += 1
        # `src` is the recording as it arrived and is never written to
        # again; `buf` is that source with the layer's own effect chain
        # rendered into it. Keeping both is what lets an effect be taken
        # off: the chain is simply rendered again without it.
        self._tracks.append(
            {"buf": buf, "src": buf.copy(), "chain": [],
             "muted": False, "solo": False, "level": 1.0,
             "fx": True, "label": label, "id": self._track_seq})
        self._remix()
        self.loop_on = True

    def track_action(self, ident: int, what: str) -> None:
        """mute, solo or delete one layer, addressed by its id.

        An id that is not here any more is a button pressed against a list
        that has since changed — ignored, and said out loud, because the
        alternative is acting on a layer nobody pointed at.
        """
        # Found by position rather than by object: a layer holds its buffer,
        # so list.remove would compare two numpy arrays with == and raise.
        idx = next((i for i, tr in enumerate(self._tracks)
                    if tr["id"] == ident), None)
        if idx is None:
            print(f"\n[layer {ident} is gone — that press was for a list "
                  f"that has changed. Now: {self.layer_summary()}]")
            return
        t = self._tracks[idx]
        if what == "mute":
            t["muted"] = not t["muted"]
        elif what == "solo":
            t["solo"] = not t["solo"]
        elif what == "fx":
            t["fx"] = not t.get("fx", True)
        elif what == "delete":
            self._tracks.pop(idx)
        else:
            return
        self._remix()
        print(f"\n[layers: {self.layer_summary()}]")

    def layer_fx(self, ident: int, action: str, value: str | int) -> None:
        """Add an effect to one layer, or take one off it.

        Rendered here and not in the callback: the layer's samples are
        rebuilt once, now, so playing it costs exactly what it cost before.
        A layer with four effects on it is no more expensive than a bare
        one, which is the whole reason these are a property of the layer
        rather than another thing the hand is holding.
        """
        from glove import layerfx
        idx = next((i for i, tr in enumerate(self._tracks)
                    if tr["id"] == ident), None)
        if idx is None:
            print(f"\n[layer {ident} is gone — nothing to change]")
            return
        t = self._tracks[idx]
        chain = list(t.get("chain", []))
        if action == "add":
            if value not in layerfx.EFFECTS:
                print(f"\n[no such effect: {value}]")
                return
            if value in chain:
                print(f"\n[{t['label']} already has {value}]")
                return
            chain.append(str(value))
        elif action == "del":
            try:
                chain.pop(int(value))
            except (ValueError, IndexError):
                return
        elif action == "clear":
            chain = []
        else:
            return
        t["chain"] = chain
        # The scene's scale travels with it: a major third baked over a
        # minor scene would be wrong in exactly the way the live harmony
        # mode takes care not to be.
        t["buf"] = layerfx.render(t["src"], chain, self.harmony_scale)
        self._remix()
        print(f"\n[{t['label']}: {' + '.join(chain) if chain else 'clean'}]")

    def layer_summary(self) -> str:
        if not self._tracks:
            return "none"
        return ", ".join(
            f"{i + 1} {t['label']}"
            + ("" if self._audible(t) else " (out)")
            + (" SOLO" if t["solo"] else "")
            + ("" if t.get("fx", True) else " dry")
            + (" [" + "+".join(t["chain"]) + "]" if t.get("chain") else "")
            for i, t in enumerate(self._tracks))

    def tracks_state(self) -> list:
        """What the panel draws: one row per layer."""
        # `n` is what the row is called on screen; `id` is what a press on it
        # is sent against. They are not the same number and must not be: the
        # first is a position and gets reused, the second never does.
        return [{"n": i + 1, "id": t["id"], "label": t["label"],
                 "muted": t["muted"], "solo": t["solo"],
                 "fx": t.get("fx", True), "chain": list(t.get("chain", ())),
                 "audible": self._audible(t)}
                for i, t in enumerate(self._tracks)]

    def set_loop(self, samples, rate: int, label: str = "glove take") -> None:
        """Install a recording made elsewhere as the voice loop, resampled
        to the audio engine's rate. Everything downstream — pitch, granular,
        slices, overdub — then works on it exactly as it does on a
        laptop-recorded take. `label` is what the console calls it: a glove
        take by default, or a song's name when one has been loaded."""
        samples = np.asarray(samples, dtype=np.float64)
        if len(samples) < 2:
            return
        if rate != SAMPLE_RATE:
            n_out = int(len(samples) * SAMPLE_RATE / rate)
            samples = np.interp(
                np.linspace(0.0, len(samples) - 1, n_out),
                np.arange(len(samples)),
                samples,
            )
        peak = float(np.abs(samples).max())
        if peak > 1e-4:
            samples = samples * min(0.5 / peak, 40.0)
        self.loop_on = False           # keep the callback off the buffer
        self._tracks = []              # a loaded take replaces the whole stack
        self._loop_pos = 0.0
        self._shot = None
        self.add_track(samples, label)
        self.loop_label = label
        print(f"\n[{label} loaded — {len(samples) / SAMPLE_RATE:.1f}s looping]")

    def toggle_granular(self) -> None:
        # Granular and harmony are two readings of the same grains, and the
        # callback can only take one, so leaving both on lit two cards and
        # played one. Slices is not in that argument: a fired chunk is mixed
        # on top of whatever is playing, so it combines with either.
        self.granular_on = not self.granular_on
        if self.granular_on:
            self.harmony_on = False
        self._grains = []
        print(
            "\n[granular mode: roll scrubs through the frozen voice]"
            if self.granular_on
            else "\n[normal loop mode]"
        )

    def toggle_harmony(self) -> None:
        """Harmony is a way of reading the grains, so it owns granular while
        it is on and hands it back when it is switched off."""
        self.harmony_on = not self.harmony_on
        if self.harmony_on:
            self.granular_on = False      # the one mode it genuinely replaces
            third, fifth = HARMONY_INTERVALS.get(
                self.harmony_scale, HARMONY_INTERVALS["minor"])
            print(f"\n[harmony: +{third} and +{fifth} semitones under the take, "
                  f"from the {self.harmony_scale} scale]")
        else:
            print("\n[harmony off]")

    def toggle_slices(self) -> None:
        self.slices_on = not self.slices_on
        print(
            f"\n[slice mode: punch fires 1 of {N_SLICES} chunks, roll picks which]"
            if self.slices_on
            else "\n[slice mode off: punch is a drum hit again]"
        )

    def trigger_slice(self) -> None:
        buf = self._loop_buf
        if buf is None or len(buf) < N_SLICES:
            print("\n[no recording to slice — record one with v]")
            return
        i = min(int(self.target_scrub * N_SLICES), N_SLICES - 1)
        step = len(buf) // N_SLICES
        self._shot = [i * step, i * step, min((i + 1) * step, len(buf))]

    def toggle_loop(self) -> None:
        if self._loop_buf is None:
            print("\n[no voice loop yet — record one with v]")
            return
        self.loop_on = not self.loop_on
        print("\n[voice loop on]" if self.loop_on else "\n[voice loop off]")

    @property
    def has_record(self) -> bool:
        """True when the loop hand is shaping a recording rather than a live
        mic. The live hand's filter is only allowed to touch the former: one
        hand's brightness gesture silently reshaping the other hand's voice
        is the thing the two chains were split up to prevent."""
        return self._loop_buf is not None and len(self._loop_buf) > 1

    def toggle_freeze(self) -> None:
        """Manual freeze toggle, for when the gesture cannot reach it.

        Freeze is set by a fist and cleared by an open hand, both of which
        need working flex sensors. A glove with a dead flex channel can
        therefore be frozen with no way back — the state is only escapable
        by the one gesture that hand can no longer make.
        """
        self.set_freeze(not self.freeze_on)

    def toggle_reverse(self) -> None:
        """Play the loop backwards. Free: the reader indexes modulo the
        buffer length, so a negative rate simply walks the other way."""
        self.reverse = not self.reverse
        self._seek_fade = 0.0       # direction change is a discontinuity too
        print("\n[reverse]" if self.reverse else "\n[forward]")

    def toggle_pitch_lock(self) -> None:
        """Separate pitch from speed.

        Normally tilt varispeeds the loop, so slowing a track also drops its
        key - the two cannot be moved apart. Locked, the loop runs at 1x and
        tilt drives the granular pitch shifter instead, which transposes
        without changing the tempo.
        """
        self.pitch_lock = not self.pitch_lock
        if not self.pitch_lock:
            self.target_voice_pitch = 1.0
        print("\n[tilt = pitch only, speed stays 1x]" if self.pitch_lock
              else "\n[tilt = speed and pitch together]")

    def clear_loop(self) -> None:
        """Stop whatever is in the loop and throw it away.

        Stronger than toggle_loop, which only pauses: a song loaded from the
        panel has to be removable, and pausing leaves it ready to restart on
        the next gesture that touches the loop. Order matters — the flag goes
        down before the buffer, so the audio callback never sees loop_on with
        nothing to read.
        """
        self.loop_on = False
        self.granular_on = False
        self.harmony_on = False
        self._tracks = []
        self._loop_buf = None
        self._loop_pos = 0.0
        self._grains = []
        self._shot = None
        self.loop_label = "glove take"
        print("\n[loop cleared]")

    def toggle_drone(self) -> None:
        # 'm' is the deliberate decision, so it owns instrument_off. A gate
        # gesture can no longer undo it; only another press of 'm' can.
        self.mute_instrument(not self.instrument_off)
        if not self.instrument_off:
            self.drone_on = True
        print("\n[instrument on]" if self.drone_on
              else "\n[instrument muted — press m to bring it back]")

    def toggle_live(self) -> None:
        if not self._has_input:
            print("\n[live voice unavailable: no mic]")
            return
        self.live_on = not self.live_on
        print(
            "\n[live voice ON — speak! roll = pitch, motion = echo. "
            "Use headphones or it will feed back]"
            if self.live_on
            else "\n[live voice off]"
        )

    def _duplex_callback(
        self, indata: np.ndarray, out: np.ndarray, frames: int, time_info, status
    ) -> None:
        self._live_in = indata[:, 0].astype(np.float64)
        self._callback(out, frames, time_info, status)

    def _callback(self, out: np.ndarray, frames: int, time_info, status) -> None:
        self._blocks += 1
        # Per-block smoothing of control parameters (~50 ms time constant).
        k = 0.15
        self._freq += (self.target_freq - self._freq) * k
        self._cutoff += (self.target_cutoff - self._cutoff) * k
        self._pan += (self.target_pan - self._pan) * k
        self._amp += (self.target_amp - self._amp) * k

        # Drone oscillator (selected instrument). Volume applied here,
        # pre-filter, so the voice loop below has its own independent level.
        if self.drone_on:
            saw = self._render_tone(frames) * self._amp
        else:
            saw = np.zeros(frames)

        # Voice: mixed in before the filter so tilt brightens/darkens it too.
        loop_block = None
        buf = self._loop_buf
        if buf is not None and len(buf) > 1:
            voice = None
            if self.loop_on:
                if self.granular_on and not self.harmony_on:
                    voice = self._render_grains(buf, frames)
                else:
                    # Variable-rate loop (tilt = speed & pitch), linear interp.
                    self._rate += (self.target_rate - self._rate) * k
                    rate = -self._rate if self.reverse else self._rate

                    # Roll seeks. It used to set target_scrub and then only
                    # granular and slices ever read it, so in plain playback
                    # the most obvious gesture on the hand did nothing at
                    # all. Moving the wrist jumps the playhead; holding it
                    # still lets the track run on from there, which is what
                    # a hand on a record does.
                    self._scrub += (self.target_scrub - self._scrub) * 0.25
                    if abs(self._scrub - self._scrub_held) > SEEK_MIN_MOVE:
                        self._scrub_held = self._scrub
                        self._loop_pos = self._scrub * (len(buf) - 1)
                        # Jumping mid-waveform is a step discontinuity, i.e.
                        # a click. Fading back in over a few ms costs
                        # nothing and is the difference between scrubbing
                        # and a burst of static.
                        self._seek_fade = 0.0

                    idx = (self._loop_pos + rate * np.arange(frames)) % len(buf)
                    i0 = idx.astype(np.intp)
                    i1 = (i0 + 1) % len(buf)
                    frac = idx - i0
                    voice = buf[i0] * (1.0 - frac) + buf[i1] * frac
                    if self._mix_fade < 1.0 and self._mix_old is not None:
                        old = (self._mix_old[i0] * (1.0 - frac)
                               + self._mix_old[i1] * frac)
                        step = 1.0 / max(MIX_FADE * SAMPLE_RATE, 1.0)
                        xr = np.minimum(
                            self._mix_fade + step * np.arange(frames), 1.0)
                        voice = old * (1.0 - xr) + voice * xr
                        self._mix_fade = float(xr[-1])
                        if self._mix_fade >= 1.0:
                            self._mix_old = None
                    if self._seek_fade < 1.0:
                        step = 1.0 / max(SEEK_FADE * SAMPLE_RATE, 1.0)
                        ramp = np.minimum(
                            self._seek_fade + step * np.arange(frames), 1.0)
                        voice = voice * ramp
                        self._seek_fade = float(ramp[-1])
                    if self.harmony_on:
                        # The take itself plays whole, and only the added
                        # notes are grains. Chopping the original as well made
                        # the voice buzz at the grain rate. The original's
                        # pitch follows the rate, so the added notes are read
                        # at that rate too or the chord would go out of tune
                        # whenever the hand tilts.
                        third, fifth = HARMONY_INTERVALS.get(
                            self.harmony_scale, HARMONY_INTERVALS["minor"])
                        speed = abs(self._rate)
                        added = HARMONY_GAIN * HARMONY_TRIM
                        voice = voice * HARMONY_TRIM + self._render_grains(
                            buf, frames,
                            ratios=(speed * 2.0 ** (third / 12.0),
                                    speed * 2.0 ** (fifth / 12.0)),
                            gains=(added, added),
                            at=self._loop_pos)
                    self._loop_pos = float(
                        (self._loop_pos + rate * frames) % len(buf)
                    )
            shot = self._render_shot(buf, frames)
            if shot is not None:
                voice = shot if voice is None else voice + shot
            if voice is not None:
                if self.voice_from_loop:
                    # Hand it to the voice chain below instead of the
                    # instrument bus, so it is not processed twice.
                    loop_block = voice
                else:
                    # Solid base level so the voice is always clearly audible;
                    # motion still adds a swell on top.
                    saw = saw + voice * (0.6 + self._amp)

        # The live voice is deliberately NOT mixed in here any more. It runs
        # its own chain below with its own level and pan, because the voice
        # glove controls a parameter set disjoint from the instrument's —
        # dragging it through the instrument's ladder filter would mean one
        # hand's brightness gesture silently reshaped the other hand's voice.

        # Four-pole resonant lowpass (-24 dB/oct), the classic ladder shape.
        # A single pole managed only -4 dB one octave above cutoff, so almost
        # every harmonic survived it and all six instruments came out fizzy.
        # The resonant peak is also what makes a tilt sweep sound like an
        # instrument opening up rather than a tone knob being turned.
        # Four poles pull the corner down but the resonant peak lifts it back,
        # so the coefficient needs no trim: measured, a nominal 1 kHz lands
        # its -3 dB point at 1009 Hz.
        fc = min(self._cutoff, 0.45 * SAMPLE_RATE)
        res = FILTER_RES
        patch = self.custom
        if patch is not None:
            # A designed instrument brings its own filter. The hand still
            # sweeps — that gesture has to keep working — but it now scales
            # the patch's own corner instead of replacing it, so a patch
            # that is meant to be dark stays dark wherever the wrist is.
            # Without this every instrument was rendered and then pushed
            # through the same filter at the same frequency with the same
            # resonance, which is most of why they all converged.
            sweep = self._cutoff / 2000.0          # 1.0 at the hand's centre
            fc = patch["cutoff"] * min(max(sweep, 0.12), 8.0)
            # Envelope on the filter: the "wow" at the start of a note. Its
            # own decay, because a filter that tracks the amplitude envelope
            # just sounds like a volume change.
            if abs(patch["env_amount"]) > 1e-3:
                self._fenv *= float(np.exp(-frames /
                                           (patch["env_decay"] * SAMPLE_RATE)))
                fc *= 2.0 ** (patch["env_amount"] * self._fenv)
            fc = min(max(fc, 30.0), 0.45 * SAMPLE_RATE)
            res = patch["resonance"]
        a = min(1.0 - np.exp(-2.0 * np.pi * fc / SAMPLE_RATE), 0.9)
        # The feedback runs round a one-sample delay, so the loop gain creeps
        # past unity as `a` approaches 1 and the ladder tears itself apart:
        # measured, it diverges to infinity above resonance 2.2 once a
        # reaches 0.9. A designed patch can ask for exactly that, and the
        # patch matcher found it on its own within a dozen tries.
        #
        # Only designed patches are held back. The seven built-ins were swept
        # across the whole hand range with this off and none of them can
        # reach the unstable corner, so clamping them would have cost the
        # guitar its top end for nothing - and that top end is most of what
        # makes it a guitar.
        if patch is not None and a > LADDER_A_SAFE:
            res = min(res, max(3.6 - 20.0 * (a - LADDER_A_SAFE), 0.5))
        y1, y2, y3, y4 = self._lp
        lp = np.empty(frames)
        for i in range(frames):
            x = saw[i] - res * y4   # feedback around the whole ladder
            y1 += a * (x - y1)
            y2 += a * (y1 - y2)
            y3 += a * (y2 - y3)
            y4 += a * (y3 - y4)
            lp[i] = y4
        self._lp = [y1, y2, y3, y4]

        # The feedback costs (1 + res) of passband gain; put it back.
        mono = lp * (1.0 + res)

        # Percussive layer: filtered noise burst with exponential decay.
        if self._pluck_env > 1e-4:
            noise = self._rng.standard_normal(frames)
            env = self._pluck_env * np.exp(
                -np.arange(frames) / (0.12 * SAMPLE_RATE)
            )
            self._pluck_env = float(env[-1])
            pn = np.empty(frames)
            y2 = self._pluck_lp
            for i in range(frames):
                y2 += 0.25 * (noise[i] - y2)
                pn[i] = y2
            self._pluck_lp = y2
            mono = mono + pn * env * 0.8

        # Soft clip so stacked layers saturate gently instead of crackling.
        mono = np.tanh(mono)

        # Equal-power stereo pan for the instrument.
        angle = (self._pan + 1.0) * (np.pi / 4.0)
        left = mono * np.cos(angle)
        right = mono * np.sin(angle)

        # Voice hand: its own chain, its own level, its own pan. Summed at the
        # very end so nothing the instrument glove does can touch it.
        # The loop hand's chain gets the recording when one is playing, and
        # the live microphone when it is not — so the hand always has
        # something to shape rather than sitting dead before you record.
        live_in = self._live_in
        v_in = loop_block
        if v_in is None and self.live_on and live_in is not None and len(live_in) == frames:
            v_in = live_in
        if v_in is not None:
            v = self._process_voice(v_in, frames)
            v = v + self._read_dry(frames)
            v = np.tanh(v)   # its own soft clip; reverb tails can stack up
            if self._bounce is not None:
                self._capture_bounce(v)
            v_angle = (self._v_pan + 1.0) * (np.pi / 4.0)
            left = left + v * np.cos(v_angle)
            right = right + v * np.sin(v_angle)
        elif self._bounce is not None:
            # Silence still counts, or a bounce started with nothing playing
            # would never reach its end and never hand the loop back.
            self._capture_bounce(np.zeros(frames))

        # Stereo width, driven by how far the two hands' roll differs.
        # Mid/side: collapse toward mono at 0, exaggerate the difference above 1.
        self._width += (self.target_width - self._width) * k
        if abs(self._width - 1.0) > 1e-3:
            mid = (left + right) * 0.5
            side = (left - right) * 0.5 * self._width
            left, right = mid + side, mid - side

        out[:, 0] = left.astype(np.float32)
        out[:, 1] = right.astype(np.float32)

        # Everything the instrument made, tapped at the very end: both hands,
        # the loop with all its layers, harmony, the effects and the stereo
        # width. Collected here and written to disk when it stops, because
        # opening a file from the audio callback is how you get a click.
        if self._session is not None:
            self._session.append(np.stack((left, right), axis=1).astype(np.float32))
            self._session_frames += frames
            if self._session_frames >= SESSION_MAX:
                self._session_full = True

        # Tap for the on-screen scope. A ring write and nothing else: this
        # runs in the audio callback, so the FFT and the downsampling happen
        # on the control thread where a slow frame costs a dropped redraw
        # rather than a click.
        n = min(frames, SCOPE_LEN)
        mono = (left[-n:] + right[-n:]) * 0.5
        self._scope = np.concatenate((self._scope[n:], mono))

    # ---- voice hand ---------------------------------------------------

    def set_voice_fx(self, on: bool) -> None:
        """Fist activates the effect chain, an open hand returns the dry
        voice. Absolute rather than a toggle, because a held posture must
        always mean the same thing."""
        if on != self.voice_fx_on:
            self.voice_fx_on = on
            print("\n[voice FX ON]" if on else "\n[voice: dry]")

    def toggle_voice_source(self) -> None:
        """Switch the voice effects between the laptop mic and the glove's own
        recorded takes."""
        self.voice_from_loop = not self.voice_from_loop
        print(
            "\n[voice source: GLOVE mic (recorded takes) — hold the glove "
            "button to record]"
            if self.voice_from_loop
            else "\n[voice source: laptop mic — press l for live]"
        )

    def toggle_voice_delay(self) -> None:
        self.voice_delay_on = not self.voice_delay_on
        print("\n[voice delay on]" if self.voice_delay_on else "\n[voice delay off]")

    def set_freeze(self, on: bool) -> None:
        """Loop hand fist: hold the current moment. Reuses the stutter grab,
        but without the decay — time simply stops until the hand opens."""
        if on == self.freeze_on:
            return
        self.freeze_on = on
        if on:
            self.trigger_stutter()
            self._st_hold = True
            print("\n[FROZEN]")
        else:
            self._st_hold = False
            self._st_left = int(0.25 * SAMPLE_RATE)   # let it fade, not cut
            print("\n[released]")

    # The posture walks these in order. It is a tour of four useful settings
    # rather than three independent switches: the glove has one posture to
    # spare and the panel can still make any combination it likes. Each step
    # names all three flags, so there is never a question of what is on.
    #
    # Slices earns the fourth step because it is the one that combines — a
    # fired chunk mixes over whatever is playing — and the pairing with
    # harmony is the reason the two were untangled in the first place.
    LOOP_MODES = (
        (False, False, False, "normal loop"),
        (True,  False, False, "granular: roll scrubs the playhead"),
        (False, True,  False, "harmony"),
        (False, True,  True,  "harmony + slices: flick fires a chunk over it"),
    )

    def cycle_loop_mode(self) -> None:
        """Step to the next of the four, on one posture."""
        now = (self.granular_on, self.harmony_on, self.slices_on)
        for i, step in enumerate(self.LOOP_MODES):
            if step[:3] == now:
                nxt = self.LOOP_MODES[(i + 1) % len(self.LOOP_MODES)]
                break
        else:
            nxt = self.LOOP_MODES[0]   # arrived from some panel combination
        self.granular_on, self.harmony_on, self.slices_on = nxt[:3]
        self._grains = []
        mode = nxt[3]
        if self.harmony_on:
            mode += f" ({self.harmony_scale})"
        print(f"\n[loop mode: {mode}]")

    def trigger_stutter(self) -> None:
        """Wrist flick: freeze the last STUTTER_LEN of voice and repeat it.

        The grab is taken from a rolling history rather than from the moment
        of the flick, so the captured audio is what you *just said* — waiting
        to fill a buffer after the gesture would repeat the silence after it.
        """
        h = self._st_hist
        w = self._st_hw
        # Unwrap the history so the grab reads oldest-to-newest.
        self._st_buf = np.concatenate((h[w:], h[:w])).copy()
        self._st_left = STUTTER_HOLD
        self._st_pos = 0

    def _comb(self, j: int, x: np.ndarray) -> np.ndarray:
        buf = self._rv_comb[j]
        i = self._rv_comb_i[j]
        delayed = _ring_read(buf, i, len(x))
        y = x + REVERB_FB * delayed
        # One-sample average damps highs on every pass round the loop, the
        # same trick the plucked string uses. Real rooms lose treble fastest;
        # an undamped comb sounds like a metal tank.
        damped = 0.5 * (y + np.concatenate(([self._rv_comb_prev[j]], y[:-1])))
        self._rv_comb_prev[j] = float(y[-1])
        _ring_write(buf, i, damped)
        self._rv_comb_i[j] = (i + len(x)) % len(buf)
        return y

    def _allpass(self, j: int, x: np.ndarray) -> np.ndarray:
        buf = self._rv_ap[j]
        i = self._rv_ap_i[j]
        delayed = _ring_read(buf, i, len(x))
        y = delayed - x
        _ring_write(buf, i, x + delayed * REVERB_AP_G)
        self._rv_ap_i[j] = (i + len(x)) % len(buf)
        return y

    def _reverb(self, x: np.ndarray, frames: int) -> np.ndarray:
        """Schroeder reverb, fully vectorized (see REVERB_COMBS)."""
        wet = np.zeros(frames)
        for j in range(len(REVERB_COMBS)):
            wet += self._comb(j, x)
        wet /= len(REVERB_COMBS)
        for j in range(len(REVERB_APS)):
            wet = self._allpass(j, wet)
        return wet

    def _voice_delay(self, x: np.ndarray, frames: int) -> np.ndarray:
        buf = self._vd_buf
        n = len(buf)
        w = self._vd_w
        k = np.arange(frames)
        self._echo_fb += (self.target_echo - self._echo_fb) * 0.15
        y = x + buf[(w + k - VOICE_DELAY) % n] * self._echo_fb
        buf[(w + k) % n] = y
        self._vd_w = (w + frames) % n
        return y

    def _stutter(self, x: np.ndarray, frames: int) -> np.ndarray:
        """Keep the rolling history fed; replace the signal while a grab is
        playing, fading out over the tail so it does not end on a click."""
        h = self._st_hist
        n = len(h)
        w = self._st_hw
        k = np.arange(frames)
        h[(w + k) % n] = x
        self._st_hw = (w + frames) % n

        if self._st_hold:
            # Frozen: replay the grab forever, no decay, no fade.
            idx = (self._st_pos + k) % len(self._st_buf)
            out = self._st_buf[idx]
            self._st_pos = int((self._st_pos + frames) % len(self._st_buf))
            return out
        if self._st_left <= 0:
            return x
        idx = (self._st_pos + k) % len(self._st_buf)
        out = self._st_buf[idx]
        self._st_pos = int((self._st_pos + frames) % len(self._st_buf))
        left = self._st_left - k
        fade = np.clip(left / (0.25 * SAMPLE_RATE), 0.0, 1.0)
        self._st_left -= frames
        return out * fade

    def _pitch_shift(self, x: np.ndarray, frames: int, ratio: float) -> np.ndarray:
        """Granular delay-line pitch shifter: two taps chase the write head at
        `ratio` speed, each windowed by a half-offset sine and crossfaded so
        the periodic tap-wrap is inaudible. ~25 ms latency."""
        n = np.arange(frames)
        w = self._ps_w
        self._ps_buf[(w + n) % PS_BUF] = x
        self._ps_w = (w + frames) % PS_BUF

        dphi = (1.0 - ratio) / PS_WIN
        phase = (self._ps_phase + dphi * n) % 1.0
        self._ps_phase = float((self._ps_phase + dphi * frames) % 1.0)
        shifted = np.zeros(frames)
        gain_sum = np.zeros(frames)
        for offset in (0.0, 0.5):
            p = (phase + offset) % 1.0
            pos = (w + n - (p * PS_WIN + 2.0)) % PS_BUF
            i0 = np.floor(pos).astype(np.intp)
            frac = pos - i0
            tap = self._ps_buf[i0] * (1.0 - frac) + self._ps_buf[(i0 + 1) % PS_BUF] * frac
            g = np.sin(np.pi * p)
            shifted += tap * g
            gain_sum += g
        shifted /= gain_sum + 1e-6

        # At unity there is nothing to shift, and the algorithm stops being a
        # copier and becomes a comb filter: dphi is zero, so the window phase
        # freezes, the two taps sit at a fixed distance apart for good, and
        # the crossfade that exists to hide the tap wrap never runs. What
        # comes out is the input summed with itself a few hundred samples
        # late, coloured by wherever the phase happened to stop — and at a
        # loop wrap the two taps straddle the seam and disagree, which was
        # measured as a 0.17 step with the loop playing at normal speed.
        #
        # Faded to dry instead. The band is a few cents wide, so no shift a
        # hand can ask for is touched, and crossing it is a crossfade rather
        # than a switch: the shifter runs ~25 ms behind, and swapping between
        # the two in one sample would trade the comb for a click.
        if abs(ratio - 1.0) < PS_UNITY:
            wet = abs(ratio - 1.0) / PS_UNITY
            shifted = shifted * wet + x * (1.0 - wet)
        return shifted

    def _noise_gate(self, x: np.ndarray) -> np.ndarray:
        """Door opens for speech, stays shut for room hiss — which would
        otherwise be robotized into an annoying drone."""
        rms = float(np.sqrt((x ** 2).mean()))
        self._gate = 0.85 * self._gate + 0.15 * rms
        return x * np.clip((self._gate - 0.004) / 0.012, 0.0, 1.0)

    def _read_dry(self, frames: int) -> np.ndarray | float:
        """The layers that are playing past the effects, not through them.

        Its own playhead, always at speed one and never seeking. That is the
        point: scrub or stretch the layers you are shaping and the dry ones
        carry on in time underneath, which is what makes them usable as a
        bed to play against. Sharing the wet playhead would drag them along
        and there would be nothing steady left to hear.

        It still answers to the blend, because the blend is the loop's level
        and not an effect, and it is panned with the rest below.
        """
        dry = self._dry_buf
        if dry is None or len(dry) < 2:
            self._dry_fade, self._dry_old = 1.0, None
            return 0.0
        idx = (self._dry_pos + np.arange(frames)) % len(dry)
        i0 = idx.astype(np.intp)
        i1 = (i0 + 1) % len(dry)
        frac = idx - i0
        out = dry[i0] * (1.0 - frac) + dry[i1] * frac
        # Taking a layer off the effects changes this waveform under the
        # playhead, which is a step and so a click. Same crossfade the wet
        # mix uses, for the same reason.
        if self._dry_fade < 1.0 and self._dry_old is not None \
                and len(self._dry_old) == len(dry):
            old = self._dry_old[i0] * (1.0 - frac) + self._dry_old[i1] * frac
            step = 1.0 / max(MIX_FADE * SAMPLE_RATE, 1.0)
            xr = np.minimum(self._dry_fade + step * np.arange(frames), 1.0)
            out = old * (1.0 - xr) + out * xr
            self._dry_fade = float(xr[-1])
            if self._dry_fade >= 1.0:
                self._dry_old = None
        self._dry_pos = float((self._dry_pos + frames) % len(dry))
        return out * self._v_vol

    def _process_voice(self, x: np.ndarray, frames: int) -> np.ndarray:
        """Voice-hand chain: gate -> pitch -> stutter -> delay -> reverb.

        Returns the block already at its own level; panning happens in the
        callback so the voice keeps a stereo position independent of the
        instrument's.
        """
        k = 0.15
        self._v_pitch += (self.target_voice_pitch - self._v_pitch) * k
        self._v_reverb += (self.target_voice_reverb - self._v_reverb) * k
        self._v_pan += (self.target_voice_pan - self._v_pan) * k
        self._v_vol += (self.target_voice_volume - self._v_vol) * k

        y = self._noise_gate(x)
        if not self.voice_fx_on:
            # Open hand: completely dry. Still feed the stutter history so a
            # flick right after re-activating has something to grab.
            self._stutter(y, frames)
            return y * self._v_vol

        y = self._pitch_shift(y, frames, self._v_pitch)
        y = self._voice_filter(y, frames)
        y = self._stutter(y, frames)
        if self.voice_delay_on:
            y = self._voice_delay(y, frames)
        if self._v_reverb > 1e-3:
            wet = self._reverb(y, frames)
            y = y * (1.0 - 0.6 * self._v_reverb) + wet * self._v_reverb
        return y * self._v_vol

    def _voice_filter(self, x: np.ndarray, frames: int) -> np.ndarray:
        """Two-pole lowpass on the loop hand's material.

        Two poles, not the instrument's four: this runs a Python loop per
        sample on top of the one the ladder already costs, and -12 dB/oct is
        plenty for a sweep across a record. Wide open it is skipped, so an
        untouched filter costs a comparison.
        """
        self._v_cutoff += (self.target_voice_cutoff - self._v_cutoff) * 0.15
        if self._v_cutoff >= FILTER_OPEN:
            self._v_lp = [0.0, 0.0]
            return x
        fc = min(self._v_cutoff, 0.45 * SAMPLE_RATE)
        a = min(1.0 - np.exp(-2.0 * np.pi * fc / SAMPLE_RATE), 0.9)
        y1, y2 = self._v_lp
        out = np.empty(frames)
        for i in range(frames):
            y1 += a * (x[i] - y1)
            y2 += a * (y1 - y2)
            out[i] = y2
        self._v_lp = [y1, y2]
        return out

    def _render_tone(self, frames: int) -> np.ndarray:
        """One block of the selected instrument at the current frequency.

        Each instrument is a cheap vectorized recipe; self._ph holds phase
        accumulators for the fundamental and extra partials so pitch changes
        stay click-free. The per-instrument envelope from ENVELOPES is
        applied here — it does more to separate a struck bell from a bowed
        pad than the harmonic recipes do.
        """
        attack, decay, sustain, struck = self.envelope()

        # A change in target_freq is a note-on: mapping.py has already
        # quantized roll to a scale, so the target only moves in steps.
        # Struck instruments jump to the new pitch — a bell does not glide.
        if abs(self.target_freq - self._note_freq) > 1e-6:
            self._note_freq = self.target_freq
            if struck:
                self._freq = self.target_freq
            self._note_on()

        # Vibrato: the second finger wobbles the pitch, like a singer or a
        # string player. Applied to the increment so every instrument gets it.
        self._vibDepth += (self.target_vibrato - self._vibDepth) * 0.1
        n = np.arange(frames)
        two_pi = 2.0 * np.pi
        env = self._env_block(n, frames, attack, decay, sustain)
        if self._vibDepth > 1e-3:
            lfo = np.sin(two_pi * (self._vib + VIBRATO_HZ / SAMPLE_RATE * n)).mean()
            self._vib = float((self._vib + VIBRATO_HZ * frames / SAMPLE_RATE) % 1.0)
            freq = self._freq * (1.0 + VIBRATO_DEPTH * self._vibDepth * lfo)
        else:
            freq = self._freq
        inc = freq / SAMPLE_RATE

        def ph(k: int, mult: float = 1.0) -> np.ndarray:
            p = (self._ph[k] + inc * mult * n) % 1.0
            self._ph[k] = float((self._ph[k] + inc * mult * frames) % 1.0)
            return p

        def saw(k: int, mult: float = 1.0) -> np.ndarray:
            return _poly_saw(ph(k, mult), inc * mult)

        ins = self.instrument
        if ins == "pluck":
            # The string carries its own decay, so the envelope above only
            # supplies the attack.
            tone = self._render_ks(frames) * KS_GAIN
        elif ins == "guitar":
            # String -> pickup -> overdrive -> cabinet, the order a real rig
            # works in. The clipper is also what gives the note its sustain:
            # it compresses hard while the string is loud and cleans up as the
            # string decays, so the note blooms instead of just fading.
            string = self._render_ks(frames, pickup=GUITAR_PICKUP)
            tone = self._cabinet(np.tanh(string * GUITAR_DRIVE)) * 0.55
        elif ins == "organ":
            # Hammond drawbars: strong octaves (2x, 4x) over a weak third
            # partial. A 1/n series here would just *be* a sawtooth, which is
            # why the old weights measured 0.98 spectrally similar to "saw".
            tone = (
                np.sin(two_pi * ph(0))
                + 0.80 * np.sin(two_pi * ph(1, 2.0))
                + 0.18 * np.sin(two_pi * ph(2, 3.0))
                + 0.55 * np.sin(two_pi * ph(3, 4.0))
            ) / 2.1
        elif ins == "strings":
            # Bowed ensemble. The detune has to be wide and unevenly spaced:
            # the old symmetric +/-0.5% put both beat rates at 1.1 Hz, so the
            # three saws swelled as one slow lump instead of blurring into a
            # section. Four voices, and the gaps between them have to be
            # unequal too — evenly spaced detune makes every adjacent pair
            # beat at the same rate, and they reinforce into exactly the
            # pulsing this is meant to avoid. The slow attack does the rest
            # of the bowing.
            tone = (
                saw(0, 0.9865) + saw(1, 0.9971) + saw(2, 1.0032) + saw(3, 1.0148)
            ) / 3.2
        elif ins == "bell":
            # 2-op FM, inharmonic ratio. The modulation index has to decay
            # faster than the amplitude: that bright metallic strike settling
            # into a pure tone is the "ding". A fixed index is a static buzz.
            idx = 7.0 * env ** 2.0
            tone = np.sin(two_pi * ph(0) + idx * np.sin(two_pi * ph(1, 2.76)))
        elif ins == "flute":
            # Sine + a little octave, and breath noise that is loud for the
            # first ~50 ms (the player's "chiff") then drops to a whisper.
            # Constant noise just reads as hiss and swamped the harmonics.
            lfo = np.sin(two_pi * (self._lfo + 5.0 / SAMPLE_RATE * n))
            self._lfo = float((self._lfo + 5.0 * frames / SAMPLE_RATE) % 1.0)
            chiff = self._chiff * np.exp(-n / (0.05 * SAMPLE_RATE))
            self._chiff = float(chiff[-1])
            tone = 0.85 * (
                np.sin(two_pi * ph(0) + 0.3 * lfo)
                + 0.14 * np.sin(two_pi * ph(1, 2.0))
            ) + self._rng.standard_normal(frames) * (0.008 + 0.10 * chiff)
        elif self.custom is not None:
            tone = self._render_custom(self.custom, frames, n, env, ph, saw, inc)
        else:
            # default: classic bright sawtooth
            tone = saw(0)
        return tone * env

    def _render_custom(self, patch, frames, n, env, ph, saw, inc):
        """One block of a designed instrument.

        Four engines, the same four the built-ins are made of, with their
        numbers taken from the patch instead of being written into the
        branch. Nothing here is new synthesis — it is the existing recipes
        with the constants pulled out, which is why a custom instrument
        sounds like it belongs beside the built-in ones.
        """
        two_pi = 2.0 * np.pi
        eng = patch["engine"]
        q = patch["params"]

        if eng == "additive":
            # Partials 1..6 over the fundamental. Normalised by the weights
            # actually used, so raising one partial does not also raise the
            # overall level and make every edit sound like a volume change.
            amps = [q[f"p{k}"] for k in range(1, 7)]
            total = sum(amps) or 1.0
            tone = np.zeros(frames)
            for k, a in enumerate(amps):
                if a > 1e-4:
                    tone = tone + a * np.sin(two_pi * ph(k, float(k + 1)))
            tone /= total
            if q["noise"] > 1e-4:
                tone = tone + self._rng.standard_normal(frames) * q["noise"]

        elif eng == "saws":
            # Unevenly spaced on purpose: evenly spaced detune makes every
            # adjacent pair beat at the same rate and they reinforce into a
            # pulse instead of blurring. The primes do the uneven spacing.
            count = int(q["voices"])
            cents = q["spread"]
            offs = [(-1.0, 0.0), (-0.37, 0.53), (-0.81, 1.19),
                    (-1.43, 1.71), (-2.11, 2.29)][: max(count - 1, 1)]
            mults = [1.0]
            for lo, hi in offs:
                mults.append(2.0 ** (cents * lo / 1200.0))
                if len(mults) < count:
                    mults.append(2.0 ** (cents * hi / 1200.0))
            mults = mults[:count]
            tone = np.zeros(frames)
            for k, m in enumerate(mults):
                tone = tone + saw(k, m)
            tone /= max(len(mults) * 0.8, 1.0)

        elif eng == "fm":
            # Modulation index decaying faster than the amplitude is what
            # makes a struck sound: bright attack settling to a pure tone.
            idx = q["index"] * env ** q["index_decay"]
            tone = np.sin(two_pi * ph(0) + idx * np.sin(two_pi * ph(1, q["ratio"])))

        else:   # string
            tone = self._render_ks(
                frames, pickup=q["pickup"] if q["pickup"] > 1e-3 else 0.0
            ) * KS_GAIN
            if q["drive"] > 1e-3:
                tone = self._cabinet(np.tanh(tone * q["drive"])) * 0.55

        return tone

    def _env_block(
        self, n: np.ndarray, frames: int, attack: float, decay: float, sustain: float
    ) -> np.ndarray:
        """One block of the amplitude envelope.

        Two exponential stages — rise to 1, then fall to the sustain level.
        Each stage is exact per sample; only the switch between them lands on
        a block boundary (~6 ms), which is well under the shortest attack
        anyone can hear as anything but instant.
        """
        if self._env_stage == 0:
            tau = max(attack, 1e-4) * SAMPLE_RATE / 3.0  # 3 tau ~= 95%
            gap = 1.0 - self._env
            env = 1.0 - gap * np.exp(-n / tau)
            self._env = float(1.0 - gap * np.exp(-frames / tau))
            if self._env > 0.99:
                self._env_stage = 1
        else:
            tau = max(decay, 1e-4) * SAMPLE_RATE / 3.0
            gap = self._env - sustain
            env = sustain + gap * np.exp(-n / tau)
            self._env = float(sustain + gap * np.exp(-frames / tau))
        return env

    def _ks_pluck(self) -> None:
        """Excite the string: fill one wavelength of the delay line with
        noise. Every pass round the loop then runs it through the two-point
        average, so the harmonics die off fastest — the same way a real
        string loses its brightness long before it goes quiet."""
        patch = self.custom
        if patch is not None and patch["engine"] == "string":
            t60 = patch["params"]["t60"]
            self._ks_b = patch["params"]["damping"]
        else:
            t60, self._ks_b = KS_VOICES.get(self.instrument, KS_VOICES["pluck"])
        n = int(np.clip(SAMPLE_RATE / max(self._freq, 20.0), 8, KS_MAX))
        self._ks_n = n
        exc = self._rng.standard_normal(n)
        self._ks_buf[:n] = exc * (0.9 / max(float(np.abs(exc).max()), 1e-6))
        self._ks_i = 0
        self._ks_prev = 0.0
        # The loop gain hits any given sample once per *pass* round the delay
        # line, not once per sample — hence the factor of n. Leave it out and
        # a 2 s decay comes out around 250 s, which just sounds like a drone.
        self._ks_decay = float(np.exp(-6.9078 * n / (t60 * SAMPLE_RATE)))

    def _render_ks(self, frames: int, pickup: float = 0.0) -> np.ndarray:
        """Karplus-Strong: read the delay line, write back a weighted average
        of the last two samples. Recursive by nature, so this is the one part
        of the engine that cannot be vectorized — same per-sample shape as the
        ladder filter in _callback.

        `pickup` places a second tap that fraction of the way along the
        string and subtracts it. The delay line really is the string, so a
        second tap really is a second listening point, and the comb notches
        that fall out are the same ones that make a bridge pickup sound
        nasal. It is the cheapest honest thing in the whole engine.
        """
        buf = self._ks_buf
        n, i, prev, d = self._ks_n, self._ks_i, self._ks_prev, self._ks_decay
        b = self._ks_b
        c = 1.0 - b
        tap = int(n * pickup)
        pk = 0.62 if tap else 0.0
        out = np.empty(frames)
        for k in range(frames):
            v = buf[i]
            j = i + tap
            if j >= n:
                j -= n
            out[k] = v - pk * buf[j]
            buf[i] = (b * v + c * prev) * d
            prev = v
            i += 1
            if i >= n:
                i = 0
        self._ks_i, self._ks_prev = i, float(prev)
        return out

    def _cabinet(self, x: np.ndarray) -> np.ndarray:
        """Guitar speaker: two poles down above ~4 kHz, one pole up below
        ~90 Hz. A real cab is a narrow, lossy box, and skipping it is what
        makes an amp sim sound like a buzzsaw — the clipper generates
        harmonics all the way to Nyquist and something has to remove them."""
        a = 1.0 - np.exp(-2.0 * np.pi * GUITAR_CAB_HI / SAMPLE_RATE)
        r = float(np.exp(-2.0 * np.pi * GUITAR_CAB_LO / SAMPLE_RATE))
        y1, y2, hp = self._cab
        out = np.empty(len(x))
        for i in range(len(x)):
            y1 += a * (x[i] - y1)
            y2 += a * (y1 - y2)
            hp = r * hp + (1.0 - r) * y2   # track the lows...
            out[i] = y2 - hp               # ...then subtract them
        self._cab = [y1, y2, hp]
        return out

    def _render_grains(self, buf: np.ndarray, frames: int,
                       ratios: tuple[float, ...] = (1.0,),
                       gains: tuple[float, ...] = (1.0,),
                       at: float | None = None) -> np.ndarray:
        """Granular cloud: short Hann-windowed grains drawn from the scrub
        position. Time is frozen — the hand moves the playhead by rolling.

        One voice per entry in `ratios`, every one of them reading the same
        grains. That sharing is the whole trick behind harmony: the voices
        are the same sound at the same instant, only transposed, so they move
        together instead of drifting apart.
        """
        self._spawn_grains(buf, frames, at)
        out = np.zeros(frames)
        for ratio, gain in zip(ratios, gains):
            out += self._grain_voice(buf, frames, ratio) * gain
        # Aged once, after every voice has read them, not once per voice.
        alive = []
        for start, age, gbuf in self._grains:
            n = min(frames, GRAIN_LEN - age)
            if age + n < GRAIN_LEN:
                alive.append([start, age + n, gbuf])
        self._grains = alive
        return out

    def _spawn_grains(self, buf: np.ndarray, frames: int,
                      at: float | None = None) -> None:
        """Start whatever grains this block is due.

        `at` is a position in samples, for a mode that travels through the
        take on its own. Left out, the grains come from wherever the hand is
        pointing and time stands still — which is what granular is for, and
        what harmony is not.
        """
        span = len(buf) - GRAIN_LEN - 1
        if at is None:
            self._scrub += (self.target_scrub - self._scrub) * 0.15
            centre = self._scrub * span
        else:
            centre = at
        self._grain_timer -= frames
        while self._grain_timer <= 0 and span > 0:
            jitter = self._rng.uniform(-0.03, 0.03) * SAMPLE_RATE
            start = int(np.clip(centre + jitter, 0, span))
            self._grains.append([start, 0, buf])
            self._grain_timer += GRAIN_HOP

    def _grain_voice(self, _buf: np.ndarray, frames: int,
                     ratio: float) -> np.ndarray:
        """The live grains, read at `ratio` times their recorded pitch.

        Each grain reads the mix it was spawned against, not whatever the
        mix is now. Muting a layer therefore never cuts a grain in half:
        the ones already in flight finish on the old sum and fade out
        through their own window, and only the next ones hear the change.

        The window is indexed by the grain's age and the sample by age times
        the ratio. That is the whole of pitch shifting: where the grain sits
        and how long it lasts are unchanged, only how fast it is read, so the
        cloud keeps its rhythm while the note moves.
        """
        out = np.zeros(frames)
        for start, age, buf in self._grains:
            n = min(frames, GRAIN_LEN - age)
            if n <= 0:
                continue
            win = self._grain_win[age : age + n]
            if ratio == 1.0:
                out[:n] += buf[start + age : start + age + n] * win
                continue
            # Read faster than 1.0 and a grain reaches past the span its
            # start was chosen within, so the index wraps rather than
            # clamping — holding on the last sample would be a click.
            pos = start + (age + np.arange(n)) * ratio
            i0 = pos.astype(np.intp) % (len(buf) - 1)
            frac = pos - np.floor(pos)
            out[:n] += (buf[i0] * (1.0 - frac) + buf[i0 + 1] * frac) * win
        return out

    def _render_shot(self, buf: np.ndarray, frames: int) -> np.ndarray | None:
        """One-shot slice playback (slice mode), with 5 ms edge fades."""
        s = self._shot
        if s is None:
            return None
        start, pos, end = s
        n = min(frames, end - pos)
        if n <= 0:
            self._shot = None
            return None
        idx = np.arange(pos, pos + n)
        fade = np.clip((idx - start) / 220.0, 0.0, 1.0)
        fade = np.minimum(fade, np.clip((end - idx) / 220.0, 0.0, 1.0))
        out = np.zeros(frames)
        out[:n] = buf[pos : pos + n] * fade
        s[1] = pos + n
        if s[1] >= end:
            self._shot = None
        return out
