kethoo/mimu-gloves/glove/ble_receiver.py

"""Real hardware source: receives sensor frames from the ESP32 over BLE.

Matches the interface of SimulatedGloveSource, so main.py can swap them.

The glove's BNO08x does sensor fusion on-chip, so packets already contain
orientation — no fusion math needed here. We just zero the angles against
a baseline captured right after connecting (hold the glove still for a
second), smooth lightly, and derive motion/punch from linear acceleration.

Reconnects on its own: the glove reboots itself to recover a wedged sensor,
and that must not end a performance.

Protocol (must match esp32/glove_ble/glove_ble.ino):
  32 bytes, 8 little-endian floats, 50x/second:
    roll, pitch, yaw   -- degrees, absolute
    lax, lay, laz      -- linear acceleration (gravity removed), m/s^2
    status             -- 1 = live sensor, 0 = sensor not detected
    flex               -- raw ADC 0..4095 from the flex divider
  (28- and 24-byte packets from older firmware are still accepted.)

Requires:  pip install bleak
"""

from __future__ import annotations

import asyncio
import pathlib
import json
import math
import struct
import time
from collections import deque

import numpy as np

from glove.sensors import GloveSource, SensorFrame

SERVICE_UUID = "6e400001-b5a3-f393-e0a9-e50e24dcca9e"
CHAR_UUID = "6e400003-b5a3-f393-e0a9-e50e24dcca9e"
AUDIO_UUID = "6e400004-b5a3-f393-e0a9-e50e24dcca9e"
# The only one we write rather than read: the glove's own LED.
LED_UUID = "6e400005-b5a3-f393-e0a9-e50e24dcca9e"
DEVICE_NAME = "MIMU-GLOVE"

BASELINE_PACKETS = 80    # ~0.8 s of "hold still" used as the zero pose
PUNCH_THRESHOLD = 12.0   # linear accel magnitude (m/s^2) that counts as a punch
SCENE_BURST_CAP = 4      # more missed presses than this means a glove reboot
FROZEN_WARN_S = 2.0      # identical orientation for this long = stalled sensor
# Orientation smoothing. The BNO08x fuses on-chip and its output is already
# very clean (jitter measured at ~0.04 deg), so this is deliberately lighter
# than the original sketch's 0.85 — at 50 Hz that gives ~40 ms of lag instead
# of ~100 ms, which is the difference between playable and sluggish.
ALPHA = 0.5
# ALPHA is per packet, so it only means ~40 ms at 50 Hz. Measured on the glove,
# the Mac can deliver 20 packets a second or fewer, and the same filter then
# lags over 200 ms. Expressed as a time constant it stays the same at any rate,
# and gives ALPHA's value back at 50 Hz.
POSE_TAU = 0.029

# Flex sensor: how much ADC swing counts as a real, deliberate bend rather
# than noise. Below this the sensor is treated as absent.
#
# Sized against the actual hardware, not a guess: a 13-16k sensor into a 15k
# leg swings 3.3*15/(13+15) - 3.3*15/(16+15) = 0.17 V, which is only ~212 of
# 4095 counts end to end. The old 150 demanded 71% of that before a channel
# would come alive, so a normal bend never registered.
FLEX_MIN_SPAN = 80.0
# The right glove carries one sensor, on the middle finger, measuring 7.9k
# straight and 8.8k bent. On the glove it rests around 1640-1730 counts and a
# full bend takes it down about 160, which is small enough that a wobble looks
# like a bend, so its range is never learned from whatever moves first: it comes
# from calibrate_flex.py, or failing that from that measured bend and the
# resting reading.
#
# That glove also has an intermittent connection that throws the reading up,
# to 3132 and 4077 in measurements, in the sensor-shorted or lost-ground
# direction. A real bend only ever moves it down, which is what separates them.
FLEX_PULLDOWN_K = 15.0
SOLO_FLEX_KOHM = (7.9, 8.8)
SOLO_FLEX_TRAVEL = -160.0      # counts from straight to fully bent
SOLO_FLEX_NORMAL_MAX = 1900.0  # above this at rest, the connection is out
SOLO_FLEX_FAULT_MARGIN = 0.25  # of a bend past straight: not the finger
# Where calibrate_flex.py keeps the two measured readings.
FLEX_CAL_FILE = pathlib.Path(__file__).parent.parent / "flex-cal.json"
# Above this the divider is effectively shorted to 3V3. A flex sensor cannot
# do that by itself; it means the resistor to ground is missing or open.
FLEX_SATURATED = 4000.0
# Smoothing and the ends of the range, for a swing this small. The dead zones
# stop 2 or 3 counts of noise reading as movement at rest or at full bend.
SOLO_FLEX_SMOOTH = 0.45
SOLO_FLEX_DEAD = 0.05


def load_flex_cal(name: str, path: pathlib.Path | None = None):
    """(straight, bent) counts for a glove, or None if it was never measured."""
    try:
        entry = json.loads((path or FLEX_CAL_FILE).read_text())[name]
        return float(entry["straight"]), float(entry["bent"])
    except (OSError, ValueError, KeyError, TypeError):
        return None


def save_flex_cal(name: str, straight: float, bent: float,
                  path: pathlib.Path | None = None) -> None:
    target = path or FLEX_CAL_FILE
    try:
        data = json.loads(target.read_text())
    except (OSError, ValueError):
        data = {}
    data[name] = {"straight": round(straight, 1), "bent": round(bent, 1)}
    target.write_text(json.dumps(data, indent=2) + "\n")


def flex_counts(kohm: float) -> float:
    """ADC counts the documented divider should read for a sensor resistance."""
    return flex_counts_through(kohm, FLEX_PULLDOWN_K)


def flex_counts_through(kohm: float, pulldown: float) -> float:
    return 4095.0 * pulldown / (kohm + pulldown)


def flex_kohm(counts: float | None, pulldown: float = FLEX_PULLDOWN_K) -> float | None:
    """The sensor resistance a reading implies. None if it implies nothing."""
    if counts is None or counts <= 0.0:
        return None
    return max(pulldown * (4095.0 / counts - 1.0), 0.0)


def solo_pulldown(straight: float) -> float:
    """The resistor to ground, assuming a straight finger is the first of
    SOLO_FLEX_KOHM. Worked out because the fitted value is not the documented
    one, and every conversion to ohms depends on it."""
    return SOLO_FLEX_KOHM[0] * straight / max(4095.0 - straight, 1.0)


# A take has stopped arriving after this long with no audio packets, and is kept
# if at least this much of it came through.
AUDIO_STALL_S = 0.5
AUDIO_MIN_FRACTION = 0.5

FLEX_INVERT = True  # bending increases resistance -> lowers the divider voltage
# True on this build: the sensor on GPIO34 is taped to the MIDDLE finger and
# the one on GPIO35 to the index, which is the opposite of what the mapping
# and the panel assume. Swapping the two readings here is a line of code
# where the alternative is unpicking the glove, and it means "flex1" means
# the index finger everywhere downstream.
# --no-swap-flex if you ever rewire the pins to match.
FLEX_SWAP = True

# Readings this low are electrically impossible for the real divider and mean
# the connection dropped out, not that a finger bent. 3V3 -> flex -> pin ->
# 15k -> GND puts the count at 4095 * 15/(Rf+15), so this floor is really a
# ceiling on sensor resistance: 1100 counts is a 41k sensor. The ones on the
# glove measure 16.5k straight and 20.9k bent (1925 and 1709 counts), so
# nothing real gets anywhere near it.
#
# They have to be rejected rather than merely ignored downstream: calibration
# tracks the min and max ever seen, so one bad reading rescales the channel
# and squashes every real bend into a sliver of its range for the rest of the
# session. That is what a run of 811s — a 62k sensor, impossible here — did
# while this floor was set at 800.
FLEX_VALID_MIN = 1100.0

# Calibration only widens on the median of the last few samples, never on a
# raw one. A dropout is a spike of a sample or two; a real bend lasts tens of
# samples at 100 Hz, so the median keeps the former out of the range entirely
# while letting the latter straight through.
#
# This guards the window FLEX_VALID_MIN cannot: a reading that is electrically
# plausible but still wrong, arriving before the channel knows its range. One
# of those cost a span of 1140 on a finger that only travels ~150 counts, and
# squashed every real bend into the bottom eighth of the scale.
FLEX_MEDIAN = 5


def _wrap(deg: float) -> float:
    return (deg + 180.0) % 360.0 - 180.0


class _Discovery:
    """One BLE scanner shared by every glove.

    Two gloves means two reconnect coroutines, and running two BleakScanners
    at once is unreliable on CoreBluetooth. So scanning is serialized behind a
    lock and the results are handed out by name: whoever asks first pays for
    the scan, and the other hand takes its device from the same sweep.
    """

    def __init__(self, timeout: float = 8.0) -> None:
        self.timeout = timeout
        self._lock = asyncio.Lock()
        self._seen: dict = {}

    def _take(self, name: str):
        """Exact match first, then prefix — so 'MIMU-GLOVE' still finds a
        glove running the older un-suffixed firmware.

        Prefix matches are sorted, which matters once both boards are
        powered: 'MIMU-GLOVE' matches -I and -V alike, and iterating the
        scan results raw meant single-glove mode attached to whichever one
        the dict happened to list first. Sorted, the bare prefix lands on
        the instrument hand every time, which is the one that mode means.
        """
        if name in self._seen:
            return self._seen.pop(name)
        for found in sorted(self._seen):
            if found.startswith(name):
                return self._seen.pop(found)
        return None

    async def find(self, name: str):
        async with self._lock:
            device = self._take(name)
            if device is not None:
                return device          # another hand's scan already found it
            from bleak import BleakScanner

            # `return_adv=True` and `adv.local_name` are load-bearing, not
            # style. CoreBluetooth caches a peripheral's name from the first
            # time it ever saw it, so after reflashing a board to a new hand
            # `dev.name` keeps reporting the OLD name indefinitely while
            # `adv.local_name` carries what it is actually advertising now.
            # Measured on this machine: dev.name "MIMU-GLOVE",
            # adv.local_name "MIMU-GLOVE-V", same device, same instant.
            self._seen = {}
            found = await BleakScanner.discover(
                timeout=self.timeout, return_adv=True
            )
            for dev, adv in found.values():
                resolved = adv.local_name or dev.name
                if resolved:
                    self._seen[resolved] = dev
            return self._take(name)


def run_gloves(sources: "list[BleGloveSource]") -> None:
    """Drive several gloves from ONE background thread and ONE event loop.

    Do not call `start()` on each source instead: that spawns a thread per
    glove, each with its own `asyncio.run`, so two independent event loops end
    up driving bleak concurrently. One loop with `gather` is the supported
    shape, and it lets the gloves share a single scanner.
    """
    import threading

    async def _all() -> None:
        discovery = _Discovery()
        await asyncio.gather(*(s._ble_loop(discovery) for s in sources))

    for src in sources:
        src._running = True
    threading.Thread(target=lambda: asyncio.run(_all()), daemon=True).start()


class _FlexChannel:
    """Self-calibrating flex input, one per finger.

    The usable ADC range depends on the sensor, the divider resistor and how
    tightly it is taped to the finger, so the range widens as you bend rather
    than being hardcoded. Until it has seen a real swing it reports None,
    which the mapping treats as "no sensor" instead of guessing.
    """

    def __init__(self, name: str) -> None:
        self.name = name
        self.lo = float("inf")
        self.hi = float("-inf")
        self.ready = False
        self.last: float | None = None   # last good mapped value
        self.dropouts = 0                # count of rejected readings
        self.recent: deque[float] = deque(maxlen=FLEX_MEDIAN)

    @property
    def span(self) -> float:
        """ADC counts seen so far. Below FLEX_MIN_SPAN the channel stays
        None, so this is what to watch while bending a finger."""
        return 0.0 if self.hi < self.lo else self.hi - self.lo

    def recalibrate(self) -> None:
        """Forget the learned range and start again. The fastest cure when a
        channel has latched onto a bad extreme."""
        self.lo = float("inf")
        self.hi = float("-inf")
        self.ready = False
        self.recent.clear()
        print(f"\n[{self.name}: recalibrating — bend the finger fully a few times]")

    def update(self, raw):
        if raw is None:
            return None
        if raw < FLEX_VALID_MIN:
            # Dropout. Hold the last good value rather than poisoning the
            # calibration or flapping the mapped output to zero.
            self.dropouts += 1
            return self.last
        if self.ready:
            # Once the range is known, a sample a whole span outside it is a
            # dropout too — a finger does not suddenly travel twice as far as
            # it ever has. This is the guard FLEX_VALID_MIN cannot provide,
            # because a plausible-looking value can still be nonsense for
            # THIS sensor.
            span = self.hi - self.lo
            if raw < self.lo - span or raw > self.hi + span:
                self.dropouts += 1
                return self.last
        # Widen on the median of the last few samples, not on `raw`, so a
        # lone spike never becomes an extreme. The channel still *reports*
        # `raw`, because the median costs latency the mapping should not pay.
        self.recent.append(raw)
        if len(self.recent) == FLEX_MEDIAN:
            # Wait for a full window: with fewer samples the median is just
            # the sample, so the first reading after connecting would define
            # an end of the range all by itself — dropout or not.
            settled = sorted(self.recent)[FLEX_MEDIAN // 2]
            self.lo = min(self.lo, settled)
            self.hi = max(self.hi, settled)
        span = self.hi - self.lo
        if span < FLEX_MIN_SPAN:
            return None
        # Clamped because `raw` can sit a little outside a range learned from
        # medians, and the postures want a true 0..1.
        u = min(max((raw - self.lo) / span, 0.0), 1.0)
        if not self.ready:
            self.ready = True
            print(f"\n[{self.name} detected — range {self.lo:.0f}..{self.hi:.0f}]")
        # Bending raises the sensor's resistance, pulling the divider down.
        self.last = 1.0 - u if FLEX_INVERT else u
        return self.last


class _SoloFlexChannel(_FlexChannel):
    """One finger between two known readings, straight and bent.

    Its range is told to it, never learned from the movement. Learning it is
    what made this finger erratic: with only about 107 counts of real travel,
    the first wobble could set the scale, so a small movement read as a full
    bend, and a wobble the wrong way set the direction, so a real bend then
    read as straightening. Now a wobble is only ever the small fraction of the
    range that it really is.
    """

    def __init__(self, name: str, cal: tuple[float, float] | None = None) -> None:
        super().__init__(name)
        self.calibrated = cal is not None
        self.straight, self.bent = cal if cal else (None, None)
        self.smooth = 0.0
        self.outside = 0
        self.rezero = False
        self.warned = False

    @property
    def span(self) -> float:
        return 0.0 if self.straight is None else abs(self.bent - self.straight)

    @property
    def pulldown(self) -> float:
        return FLEX_PULLDOWN_K if self.straight is None else solo_pulldown(self.straight)

    def recalibrate(self) -> None:
        """Take the finger's position now as straight, keeping the same bend."""
        self.rezero = True
        print(f"\n[{self.name}: taking this position as straight]")

    def _start_from_rest(self, settled: float) -> None:
        """No saved range: this reading is straight, and a full bend is the
        measured distance below it."""
        self.straight = settled
        self.bent = settled + SOLO_FLEX_TRAVEL
        print(f"\n[{self.name}: straight at {settled:.0f}, full bend at "
              f"{self.bent:.0f}. Press c with the finger straight if it drifts.]")

    def _note_fault(self, settled: float) -> None:
        self.outside += 1
        self.dropouts += 1
        if self.outside == 50 and not self.warned:
            self.warned = True
            print(f"\n[{self.name}: connection dropping out (reading "
                  f"{settled:.0f}). Holding the last value until it returns.]")

    def update(self, raw):
        if raw is None:
            return None
        if raw < FLEX_VALID_MIN:
            self.dropouts += 1
            return self.last
        self.recent.append(raw)
        if len(self.recent) < FLEX_MEDIAN:
            return self.last
        settled = sorted(self.recent)[FLEX_MEDIAN // 2]
        if settled >= FLEX_SATURATED:
            if not self.warned:
                self.warned = True
                print(f"\n[{self.name}: reads {settled:.0f}, stuck near 3.3 V. It "
                      "cannot bend like this: check the resistor from the pin "
                      "to GND.]")
            return self.last
        # A position is only taken as straight while the connection is good,
        # or a dropout at the wrong moment would become the zero point.
        trustworthy = self.calibrated or settled <= SOLO_FLEX_NORMAL_MAX
        if self.straight is None:
            if not trustworthy:
                self._note_fault(settled)
                return self.last
            self._start_from_rest(settled)
        if self.rezero and trustworthy:
            self.rezero = False
            self.straight, self.bent = settled, settled + self.bent - self.straight
            self.smooth = 0.0
        u = (settled - self.straight) / (self.bent - self.straight)
        # Past straight is not the finger, and neither is a whole bend beyond
        # full. Holding the last value keeps a dropout from reading as movement.
        if u < -SOLO_FLEX_FAULT_MARGIN or u > 2.0:
            self._note_fault(settled)
            return self.last
        self.outside = 0
        self.smooth += SOLO_FLEX_SMOOTH * (min(max(u, 0.0), 1.0) - self.smooth)
        v = self.smooth
        self.last = 0.0 if v < SOLO_FLEX_DEAD else 1.0 if v > 1.0 - SOLO_FLEX_DEAD else v
        if not self.ready:
            self.ready = True
            kind = "calibrated" if self.calibrated else "from the resting reading"
            print(f"\n[{self.name} ready: straight {self.straight:.0f}, "
                  f"bent {self.bent:.0f} ({kind})]")
        return self.last


class BleGloveSource(GloveSource):
    """One glove. Two of these can run side by side — see run_gloves().

    `name` is the BLE advertised name to look for; matching is by prefix, so
    the default finds a glove on either the old single-hand firmware
    ("MIMU-GLOVE") or the new suffixed builds. `tag` prefixes every event this
    glove emits ("V:punch"), which is how main.py tells the hands apart.
    """

    def __init__(self, name: str = DEVICE_NAME, tag: str = "",
                 label: str | None = None, managed: bool = False,
                 flip: bool = False, swap_flex: bool | None = None,
                 solo_middle: bool = False) -> None:
        super().__init__()
        # One sensor on this glove, on the middle finger. Which pin it landed
        # on is found by looking rather than assumed: FLEX_SWAP describes how
        # a two-sensor glove is taped, and would report this one as the index.
        self.solo_middle = solo_middle
        self.flex_fingers = ("middle",) if solo_middle else ("index", "middle")
        self._solo_pin: int | None = None
        self._solo_seen: list[tuple[float, float]] = []
        self._solo_warned = False
        # The board on the other hand is mounted the other way round, so the
        # same wrist movement comes back with the opposite sign and the
        # panel draws the hand rolling away from where it really went.
        # Rotating the board 180 degrees about its vertical axis - which is
        # what you do to keep the USB pointing up the arm on both hands -
        # inverts roll and pitch. Yaw also shifts by 180, but the baseline
        # captured at connect subtracts a constant, so that one cancels.
        self.flip = flip
        self.swap_flex = FLEX_SWAP if swap_flex is None else swap_flex
        self.name = name
        self.tag = tag
        self.label = label or name
        # `managed` means run_gloves() owns this source's event loop, so
        # start() must not spawn a second thread of its own. Anything that
        # composes sources (MergedGloveSource) still calls start() blindly.
        self.managed = managed
        self._baseline: list[tuple[float, float, float]] = []
        self._offset: tuple[float, float, float] | None = None
        self._smoothed = [0.0, 0.0, 0.0]
        self._prev = (0.0, 0.0, 0.0)
        self._prev_t = time.monotonic()
        self._punch_armed = True
        self.quit_requested = False
        self._last_raw: tuple[float, float, float] | None = None
        self._frozen_since = 0.0
        self._warned_frozen = False
        # What the glove's own LED should be showing. Set from the control
        # loop, written by the BLE loop — the two run on different threads,
        # and a 6-byte assignment is atomic enough that no lock is needed.
        self._led: bytes | None = None
        self._led_sent: bytes | None = None
        self._led_at = 0.0
        self._no_led = False   # older firmware: characteristic not there
        self._testpattern_hits = 0
        self._warned_testpattern = False
        self._flex = _FlexChannel("flex sensor 1")
        self._flex2 = (_SoloFlexChannel("middle finger", load_flex_cal(name))
                       if solo_middle else _FlexChannel("flex sensor 2"))
        # Re-seeded on every reconnect too, so a glove that rebooted with a
        # higher press count does not fire a burst of scene changes.
        self._presses: int | None = None
        # Surfaced to the UI panel: is the link up, and is the sensor sending
        # fresh data or repeating itself?
        self.connected = False
        self._warned_no_audio = False
        self._warned_pktlen = False
        # Audio arriving from the glove's own microphone.
        self._audio_expected = 0
        self._audio_at = 0.0
        self._audio_rate = 16000
        self._audio_parts: list[bytes] = []

    def _pick_solo(self, a: float | None, b: float | None) -> float | None:
        """The reading from whichever pin the single sensor is on.

        Half a second of both pins, then a decision that holds for the
        session. The empty pin sits on its pull-down at 0, under
        FLEX_VALID_MIN, so it can never be chosen; if it has no pull-down and
        floats, the closest to the sensor's expected counts still wins.
        """
        pair = (a or 0.0, b or 0.0)
        if self._solo_pin is not None:
            return pair[self._solo_pin]
        self._solo_seen.append(pair)
        if len(self._solo_seen) < 25:
            return None
        med = [sorted(s[i] for s in self._solo_seen)[12] for i in (0, 1)]
        self._solo_seen.clear()
        usable = [i for i in (0, 1) if med[i] >= FLEX_VALID_MIN]
        if not usable:
            if not self._solo_warned:
                self._solo_warned = True
                print(f"\n[{self.label}: no flex sensor on GPIO34 or GPIO35 "
                      f"(reading {med[0]:.0f} and {med[1]:.0f})]")
            return None
        centre = (flex_counts(SOLO_FLEX_KOHM[0]) + flex_counts(SOLO_FLEX_KOHM[1])) / 2
        self._solo_pin = min(usable, key=lambda i: abs(med[i] - centre))
        print(f"\n[{self.label}: middle finger is on "
              f"GPIO{34 + self._solo_pin}, reading {med[self._solo_pin]:.0f}]")
        return pair[self._solo_pin]

    def recalibrate_flex(self) -> None:
        """Reset both flex channels on this glove."""
        self._flex.recalibrate()
        self._flex2.recalibrate()

    @property
    def stalled(self) -> bool:
        """True while the orientation has not changed for FROZEN_WARN_S. The
        link can be perfectly healthy while this is true — that distinction
        is the whole point of showing it separately."""
        return bool(
            self._frozen_since
            and time.monotonic() - self._frozen_since > FROZEN_WARN_S
        )

    @property
    def flex_spans(self) -> tuple[float, float]:
        """ADC swing each flex channel has seen. Until one reaches
        FLEX_MIN_SPAN that channel reports None, so this is the number to
        watch when a finger 'does nothing'."""
        return (self._flex.span, self._flex2.span)

    def start(self) -> None:
        if self.managed:
            return          # run_gloves() already has it
        super().start()

    def _run(self) -> None:
        asyncio.run(self._ble_loop(_Discovery()))

    async def _ble_loop(self, discovery: "_Discovery") -> None:
        """Stay connected for as long as the app runs.

        The glove reboots itself to recover a wedged sensor, and BLE links
        drop for ordinary radio reasons. Neither should end a performance, so
        this reconnects indefinitely; only stop() ends the loop.

        Takes a shared `discovery` rather than scanning itself: two gloves
        means two of these coroutines, and two concurrent BleakScanners is
        unreliable on CoreBluetooth.
        """
        from bleak import BleakClient

        searching_announced = False
        while self._running:
            device = await discovery.find(self.name)
            if device is None:
                if not searching_announced:
                    print(
                        f"\n[looking for '{self.name}' — is the glove powered? "
                        "still searching...]"
                    )
                    searching_announced = True
                continue
            searching_announced = False
            try:
                async with BleakClient(device) as client:
                    # The glove re-zeroes its own reference when it reboots, so
                    # the pose baseline must be recaptured on every connection.
                    self._reset_pose_calibration()
                    print(
                        f"Connected to {self.label}. "
                        "Hold the glove still to calibrate..."
                    )
                    await client.start_notify(CHAR_UUID, self._on_packet)
                    # Optional: firmware older than the microphone does not
                    # publish this characteristic, and subscribing blindly
                    # threw, tore the link down and reconnected forever —
                    # over a glove whose orientation was streaming fine.
                    try:
                        await client.start_notify(AUDIO_UUID, self._on_audio)
                    except Exception:
                        if not self._warned_no_audio:
                            self._warned_no_audio = True
                            print(
                                f"\n[{self.label}: no audio characteristic — older "
                                "firmware. Orientation and flex work; recording on "
                                "the glove does not. Reflash to enable it.]"
                            )
                    self.connected = True
                    self._led_sent = None   # a new link knows nothing yet
                    while self._running and client.is_connected:
                        await self._push_led(client)
                        await asyncio.sleep(0.05)
                    self.connected = False
            except Exception as exc:  # dropped mid-transfer, adapter busy, ...
                self.connected = False
                print(f"\n[BLE connection lost: {exc}]")
            if self._running:
                print("\n[glove disconnected — reconnecting...]")
                await asyncio.sleep(1.0)
        self.quit_requested = True

    def set_led(self, hue: int, value: int, pattern: int,
                phase: float = 0.0, period_ms: int = 0) -> None:
        """Tell the glove's own LED what the music is doing.

        Called from the control loop. The glove animates the pattern itself
        from `phase` and `period_ms`, so this does not have to keep up with
        the beat — it only has to say where the beat was and how long a
        cycle lasts.
        """
        self._led = bytes((
            int(hue) & 0xFF,
            max(0, min(255, int(value))),
            int(pattern) & 0xFF,
            int(phase * 256) & 0xFF,
            period_ms & 0xFF,
            (period_ms >> 8) & 0xFF,
        ))

    async def _push_led(self, client) -> None:
        """Send the LED state when it changes, and once a second regardless.

        The resend is what keeps the beat honest: the glove runs the
        animation off its own clock between packets, so without an
        occasional correction it would drift away from the loop it is
        supposed to be marking.
        """
        if self._no_led or self._led is None:
            return
        now = time.monotonic()
        if self._led == self._led_sent and now - self._led_at < 1.0:
            return
        try:
            await client.write_gatt_char(LED_UUID, self._led, response=False)
            self._led_sent, self._led_at = self._led, now
        except Exception:
            # Firmware without the characteristic, or a link going down.
            # Either way: stop trying rather than raise once per frame, since
            # an exception here would tear down a connection that is
            # otherwise streaming orientation perfectly well.
            self._no_led = True
            print(f"\n[{self.label}: no LED characteristic — older firmware. "
                  "Everything else works; reflash to light the glove.]")

    def _on_audio(self, _handle, data: bytearray) -> None:
        """Reassemble a take from the glove: a 12-byte header, then raw
        little-endian int16 samples.

        Notifications are unacknowledged, so one can be lost. A header always
        starts a new take, and _finish_stalled_take ends one that stops short:
        waiting for every last byte left a take that lost a packet never
        playing, with each later header swallowed as more of its audio.
        """
        if len(data) >= 12 and data[:4] == b"AUD0":
            n, rate = struct.unpack("<II", bytes(data[4:12]))
            if len(data) == 12:
                if self._audio_expected:
                    self._finish_take()
                self._audio_expected = n * 2
                self._audio_rate = rate
                self._audio_parts = []
                self._audio_at = time.monotonic()
                print(f"\n[glove recording: {n / rate:.1f}s incoming...]")
                return
        if not self._audio_expected:
            return
        self._audio_at = time.monotonic()
        self._audio_parts.append(bytes(data))
        if sum(len(p) for p in self._audio_parts) >= self._audio_expected:
            self._finish_take()

    def _finish_stalled_take(self) -> None:
        """Called per sensor packet. The glove only resumes those once it has
        sent the whole take, so nothing more is coming."""
        if self._audio_expected and time.monotonic() - self._audio_at > AUDIO_STALL_S:
            self._finish_take()

    def _finish_take(self) -> None:
        raw = b"".join(self._audio_parts)
        expected, self._audio_expected = self._audio_expected, 0
        self._audio_parts = []
        got = min(len(raw), expected)
        short = 1.0 - got / expected if expected else 0.0
        if got < 2 or got / expected < AUDIO_MIN_FRACTION:
            print(f"[glove recording failed: only {got * 100 // expected}% arrived "
                  "over Bluetooth — nothing changed]")
            return
        raw = raw[:got - got % 2]
        samples = np.frombuffer(raw, dtype="<i2").astype(np.float32) / 32768.0
        peak = float(np.abs(samples).max())
        if peak < 0.005:
            print("[glove recording was silent — discarded]")
            return
        self.audio = (samples, self._audio_rate)
        lost = f", {short:.0%} lost over Bluetooth" if short > 0.001 else ""
        print(f"[glove recording received: {len(samples) / self._audio_rate:.1f}s, "
              f"peak {peak:.2f}{lost} — now playing as the loop]")

    def _reset_pose_calibration(self) -> None:
        """Forget the neutral pose so the next packets re-establish it.
        Flex calibration is kept: that sensor's range does not change."""
        self._baseline.clear()
        self._offset = None
        self._smoothed = [0.0, 0.0, 0.0]
        self._prev = (0.0, 0.0, 0.0)
        self._presses = None  # re-seed from the first packet of this session

    def _on_packet(self, _handle, data: bytearray) -> None:
        self._finish_stalled_take()
        # 40 bytes = current firmware (adds the scene-press counter);
        # 36/32/28/24 are older builds and still decode.
        flex_raw = flex2_raw = None
        presses = None
        if len(data) == 40:
            (roll, pitch, yaw, lax, lay, laz,
             status, flex_raw, flex2_raw, presses) = struct.unpack("<10f", data)
        elif len(data) == 36:
            (roll, pitch, yaw, lax, lay, laz,
             status, flex_raw, flex2_raw) = struct.unpack("<9f", data)
        elif len(data) == 32:
            roll, pitch, yaw, lax, lay, laz, status, flex_raw = struct.unpack("<8f", data)
        elif len(data) == 28:
            roll, pitch, yaw, lax, lay, laz, status = struct.unpack("<7f", data)
        elif len(data) == 24:
            roll, pitch, yaw, lax, lay, laz = struct.unpack("<6f", data)
            status = 1.0
        else:
            # Say so rather than dropping it. A silent return here looks
            # exactly like a glove that connected and then sent nothing:
            # no data, no calibration, no error, nothing to go on.
            if not self._warned_pktlen:
                self._warned_pktlen = True
                print(
                    f"\n[{self.label}: {len(data)}-byte packets, which this "
                    "build does not recognise (expects 40/36/32/28/24). The "
                    "link is fine; the firmware is a layout we cannot read. "
                    "Reflash the glove.]"
                )
            return

        if status < 0.5:
            self._testpattern_hits += 1
            if self._testpattern_hits > 50 and not self._warned_testpattern:
                self._warned_testpattern = True
                print(
                    "\n[!! The ESP32 cannot see the BNO08x — no motion data is"
                    "\n    being produced. It retries every 3s, so fix the wiring"
                    "\n    (VCC/GND/SDA=21/SCL=22, RST=GPIO4) and it will recover"
                    "\n    on its own — no reflash, no restart needed.]"
                )
            return  # never feed placeholder values into the synth
        if self._warned_testpattern:
            print("\n[sensor recovered — playing real motion]")
        self._testpattern_hits = 0
        self._warned_testpattern = False

        # A live BNO08x always jitters slightly. Bit-identical packets mean
        # its I2C transport has wedged and the ESP32 is resending stale
        # values — otherwise indistinguishable from "holding perfectly still".
        now = time.monotonic()
        current = (roll, pitch, yaw)
        if current == self._last_raw:
            # 2 s, not 5: measured, a stalled BNO08x on this hardware only
            # stays frozen for ~3 s before the firmware gives up and reboots
            # the ESP32, so a 5 s threshold never fired and the freeze looked
            # like a mapping bug instead of a stalled sensor.
            if self._frozen_since and now - self._frozen_since > FROZEN_WARN_S:
                if not self._warned_frozen:
                    print(
                        f"\n[WARNING: {self.label} orientation frozen for "
                        f"{FROZEN_WARN_S:.0f}s — the BNO08x has stalled. The link is "
                        "fine; the sensor is not. Check its 3V3 and SDA/SCL.]"
                    )
                    self._warned_frozen = True
        else:
            self._frozen_since = now
            self._warned_frozen = False
        self._last_raw = current

        # First ~0.8 s of packets define the neutral hand pose.
        if self._offset is None:
            self._baseline.append((roll, pitch, yaw))
            if len(self._baseline) < BASELINE_PACKETS:
                return
            n = len(self._baseline)
            self._offset = (
                sum(b[0] for b in self._baseline) / n,
                sum(b[1] for b in self._baseline) / n,
                sum(b[2] for b in self._baseline) / n,
            )
            print("[glove calibrated — play!]")

        raw = (
            _wrap(roll - self._offset[0]),
            _wrap(pitch - self._offset[1]),
            _wrap(yaw - self._offset[2]),
        )
        if self.flip:
            # After the baseline, not before: the offset is measured in the
            # board's own frame, so flipping first would subtract the zero
            # pose with the wrong sign and leave the hand off-centre.
            raw = (-raw[0], -raw[1], raw[2])
        keep = math.exp(-max(time.monotonic() - self._prev_t, 1e-3) / POSE_TAU)
        for i in range(3):
            self._smoothed[i] = keep * self._smoothed[i] + (1 - keep) * raw[i]
        r, p, y = self._smoothed

        now = time.monotonic()
        dt = max(now - self._prev_t, 1e-3)
        speed = (
            abs(r - self._prev[0]) + abs(p - self._prev[1]) + abs(y - self._prev[2])
        ) / dt
        self._prev = (r, p, y)
        self._prev_t = now

        accel_mag = (lax * lax + lay * lay + laz * laz) ** 0.5
        if accel_mag > PUNCH_THRESHOLD and self._punch_armed:
            self.events.append(self.tag + "punch")
            self._punch_armed = False
        elif accel_mag < 3.0:
            self._punch_armed = True

        # Short button presses arrive as a running count, not a pulse, so a
        # dropped notification costs nothing: whatever the count has advanced
        # by since the last packet is how many presses we missed. Seed from
        # the first packet rather than 0, or reconnecting to a glove that has
        # been running a while would fire a burst of scene changes.
        if presses is not None:
            count = int(presses)
            if self._presses is None:
                self._presses = count
            elif count != self._presses:
                # Cap the catch-up: a counter that jumped by hundreds means a
                # glove reboot, not that someone pressed the button 300 times.
                missed = count - self._presses
                for _ in range(missed if 0 < missed <= SCENE_BURST_CAP else 1):
                    self.events.append(self.tag + "scene")
                self._presses = count

        if self.solo_middle:
            flex_raw, flex2_raw = None, self._pick_solo(flex_raw, flex2_raw)
        elif self.swap_flex:
            flex_raw, flex2_raw = flex2_raw, flex_raw

        motion = min(speed / 400.0 + accel_mag / 30.0, 1.5)
        self.latest = SensorFrame(
            roll=r, pitch=p, yaw=y, motion=motion,
            flex=self._flex.update(flex_raw),
            flex2=self._flex2.update(flex2_raw),
            flex_raw=flex_raw,
            flex2_raw=flex2_raw,
        )
