kethoo/mimu-gloves/(commit log)

2026-08-23 added 2nd flex sensor/mic/led/button
    [ble_receiver.py, diagnose.py, glove_ble.ino, hw_test.ino, main.py, mapping.py, monitor.py, rec_test.ino]
2026-08-29 findings for adding the 2nd esp32
2026-09-12 Add the voice hand: second glove for live voice processing
    The second ESP32 (same pinout) shapes the microphone while the first hand
    plays the instrument. The two gloves drive disjoint parameter sets rather
    than averaging into one voice.
    Voice gestures: tilt = pitch (+/-12 semitones), roll = reverb, yaw = pan,
    index bend = volume, fist = effects on, open hand = dry, point = delay,
    wrist flick = stutter grab, button tap = preset, button hold = record.
    Synth
    - New voice chain: gate -> pitch -> stutter -> delay -> reverb -> level ->
    pan, kept entirely out of the instrument's ladder filter and pan so one
    hand's gesture cannot reshape the other hand's sound.
    - Schroeder reverb, T60 ~1.45 s.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
2026-09-20 diagnose.py: find suffixed gloves, and select which hand
    It used find_device_by_name, which matches on the cached device name
    CoreBluetooth keeps from the first time it saw a board — so a reflashed
    glove was never found. Shares _Discovery with ble_receiver instead, which
    reads adv.local_name.
    --voice / --instrument / --name pick a hand. This matters most when the
    board runs on a powerbank: there is no serial then, so this is the only
    window into whether it is booting, holding the link and sending real data.
2026-09-20 monitor.py --identify: which glove is on which serial port
    With both boards plugged in, the README's `ls /dev/cu.usbserial-* | head -1`
    picks one arbitrarily, so a flash can land the voice firmware on the
    instrument board without any sign it went wrong. Each board announces its
    own DEVICE_NAME at boot, so this resets each port in turn, reads the banner
    and prints the matching -p flag.
    [monitor.py]
2026-09-20 Spec the Live hand / Loop hand redesign
    The current two-hand mapping points the same vocabulary at two sound
    sources — tilt=pitch, yaw=pan, flex=volume on both hands — so it is one
    instrument played twice, and it duplicates parameters the instrument only
    needs one of. It fails the test: swap the hands and it still makes sense.
    This splits by role instead. One hand makes sound (pitch, brightness,
    dynamics, articulation) and never touches an effect; the other shapes what
    was already captured (scrub, speed, freeze, blend, space) and never plays a
    note. Exactly one of each parameter exists, owned by exactly one hand.
    Mostly a relocation rather than new DSP: granular scrub, variable-rate
    pl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
2026-09-20 Build the Live hand / Loop hand redesign
    Splits the two gloves by role instead of by target. One hand makes sound and
    never touches an effect; the other shapes what was already captured and never
    plays a note. Exactly one of each parameter exists in the instrument, owned by
    exactly one hand — verified by test, zero overlap between the two modules.
    Live hand (mapping.py)
    - Keeps pitch, brightness, pan, volume, vibrato, drum hits, scenes.
    - Loses scrub and loop speed, which belong to time rather than to the note.
    - Motion now sets wrist-flick VELOCITY. It previously wrote target_echo,
    which the other hand overwrote on the very same tick, so the axis did
    nothing at all. Every drum hit us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
    [loop_mapping.py, main.py, mapping.py, synth.py]
2026-09-20 Fix --voice-mic laptop being silently ignored once a loop existed
    It set live_on but left voice_from_loop alone, so the loop kept priority for
    the processing chain and the microphone never reached it. The flag appeared
    to work only until you recorded something.
    [main.py]
2026-09-20 Add gestures-guide.md, and fix the stale keyboard help
    A playing guide rather than a design document: what each hand does, what they
    do together, the worked performance example, and why postures need a hold.
    Every value in it is checked against the code — scene and preset names, dwell
    times, flex thresholds, filter and volume ranges.
    main.py's keyboard help still described the old mapping, telling you roll
    scrubbed the voice loop on the hand that no longer owns scrub. It now lists
    both hands separately and mentions 'h' to switch between them.
    [main.py]
2026-10-04 Add --live-name / --loop-name so a hand can target any advertised glove
    Lets a board still on older un-suffixed firmware take the live-hand role
    without being reflashed, which matters while Rosetta is blocking flashing.
2026-10-04 Add the two-hand panel to the browser UI
    A live picture of both gloves, above the existing controls. The hand drawing
    IS the sensor data: fingers curl with the real flex values, the hand rotates
    with roll, the palm dot leans with tilt. Index and middle are drawn in colour
    because they are the two that matter; the rest are grey. A glance tells you
    whether a flex channel is reading at all, which until now meant squinting at
    a scrolling status line.
    Cards change colour by state — grey searching, teal when a posture is active,
    pink frozen — and the link indicator separates "no link" from "linked but the
    sensor has stalled", a distinction that cost an afternoon to make by hand.
    Each hand sho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
    [ble_receiver.py, main.py]
2026-10-04 Add orientation gauges and posture indicators, after Glover's detail view
    Per hand: yaw as a horizontal slider, tilt as a vertical one, roll as a dial
    with a needle — a dial reads faster than a number when the hand is moving.
    Plus a chip per posture and a wrist-flick light.
    One thing beyond what Glover shows: the posture chips fill as the dwell
    accumulates, so you can see a gesture ARMING and correct before it fires.
    Glover only lights a posture once it has committed. Given fist and point need
    0.35 s and an open hand needs a full second, watching the fill is the
    difference between understanding the delay and thinking it is broken.
    main.py publishes `pending` and `pending_frac`; the gauge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
    [main.py]
2026-10-04 Title the UI "MIMU GLOVES" with a drawn glove mark
    Replaces the emoji with an inline SVG: fingers, thumb, palm, a darker cuff —
    which is what reads as a glove rather than a hand — and a sensor dot in the
    palm. It inherits currentColor, so it picks up the accent and stays sharp at
    any size rather than depending on the system emoji font.
    Also collapses the controls section behind a toggle. The panel above monitors
    the gloves; everything in <main> stands in for gloves you are not wearing.
    With hardware connected that stand-in is noise, so it folds away by default —
    but instruments, scenes and modes stay useful with real gloves, so it is one
    click away and the choice is remembered.
2026-10-04 Add light mode
    A full second palette plus a header toggle. It follows the system until you
    choose, then your choice sticks in localStorage, and it reacts live if the
    system flips while no explicit choice is set.
    The work was mostly converting hardcoded colours to variables: bar and chip
    tracks, button fills, the XY pad ground, the punch button, the status dots,
    and the drawn hands. The hand SVG now reads its colours through cssVar() and
    is redrawn on a theme change, so it re-themes with everything else instead of
    staying a dark-mode island on a white page.
    Teal and pink are darkened in light mode (#0d9488, #db2777) — the dark-mode
    values have too little contrast on white to read as text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
2026-10-04 Wider layout, capsule theme switch, larger cards
    - Content width 860 -> 1180px and smaller page gutters, so the panel no
    longer floats in the middle of a wide screen.
    - Status and theme toggle share one rounded capsule with a divider, and the
    toggle is a drawn moon/sun in a tinted circle rather than a glyph — the
    glyphs rendered differently on every machine and could not be themed.
    - Bigger cards, text and hand drawings; posture chips lie in a row now that
    there is width, instead of a stretched column.
    Fixes a bug introduced by the light-mode commit: converting hardcoded colours
    to variables also rewrote the DARK palette's own definitions, leaving
    `--track: var(--track)` and frien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
2026-10-04 Taller tinted hand cards, drawn header icons, inner status cards
    - Cards are taller (min-height 430px) with a soft teal wash — a radial tint
    from the top-left over a gradient — and a faintly accented border. The
    frozen state gets the same treatment in pink.
    - Orientation and posture now sit in their own labelled inner cards rather
    than floating in one undivided row.
    - The hand headers use drawn SVG marks instead of emoji: a waveform for the
    live hand, loop arrows for the loop hand. They take currentColor, so they
    turn teal when a posture is active and pink when frozen, which emoji
    cannot do.
    - New --gtrack for the gauge tracks. They are thin and now sit on a tinted
    inner ca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
2026-10-04 Postures on one row, wrist flick beneath, inside the same card
    The three posture chips share a row and stretch evenly; the wrist-flick
    indicator sits on its own line under them. Both still inside HAND STATUS.
    Also moves the flick dot onto --gtrack. Like the gauge tracks before it, a
    9px dot painted with the shared --track disappeared against the tinted inner
    card in dark mode while looking fine in light.
2026-10-04 Centre stereo width on normal stereo, not mono
    The unsigned roll difference scaled up from zero, so a resting pose — both
    hands level, the most common position there is — played the entire
    instrument in mono. You had to hold your hands twisted apart just to get
    ordinary stereo.
    Now signed and centred: level is 1.0, twisting one way widens to 1.85 and
    the other collapses toward mono. The panel labels the value so it is obvious
    which you are getting.
2026-10-04 Fall back to the browser hand when a glove is not connected
    With --voice-glove passed, the physical loop glove's frame was used even
    while it had never connected — so a neutral frame pinned scrub, speed and
    reverb, and there was no way to drive that hand from the UI.
    It now prefers the glove only when it is actually linked. One real glove
    plus the browser for the other hand works with no extra flag, which is what
    you want when only one glove is built or you are testing a single hand.
2026-10-04 Start silent instead of droning the moment you launch
    The synth sounded as soon as main.py started, before any glove connected and
    before you touched anything — a continuous tone you had to go and switch off.
    An instrument should be silent until played.
    A fist, a bent index finger or `m` starts it, and startup says so. --demo
    still begins sounding, since the scripted demo plays itself.
    [main.py, synth.py]
2026-10-04 Honour --live-name with a single glove too
    The override only existed inside the two-glove branch, so passing it without
    --voice-glove was accepted and silently ignored. It also now prints which
    name it is searching for, so a mismatch is visible rather than looking like
    a dead glove.
2026-10-04 Do not drop the link when a glove has no audio characteristic
    Firmware older than the microphone does not publish 6e400004. Subscribing to
    it unconditionally threw, which tore down a connection whose orientation and
    flex were streaming perfectly, and the receiver then reconnected forever.
    It is now optional, with one line saying what is unavailable and why. The
    packet decoder already accepted the older 36/32/28/24-byte layouts, so this
    was the last thing blocking a board on old firmware from simply working.
    [ble_receiver.py]
2026-10-04 Report an unrecognised packet size instead of dropping it silently
    The decoder returned without a word on any length outside 40/36/32/28/24,
    which presents as a glove that connects and then sends nothing: no data, no
    calibration, no error, nothing to go on. It now says what size arrived and
    what it expected.
    [ble_receiver.py]
2026-10-04 Let a wrist flick start the sound, and name the right key per mode
    Startup told you to press 'm', but the terminal keyboard is only read by
    SimulatedGloveSource — under --ble --web nothing listens to it, so the one
    instruction given for starting a silent instrument did nothing. It now names
    what works in the current mode.
    A wrist flick also opens the gate now. It is the only deliberate gesture a
    glove can make regardless of flex calibration, and on a glove whose flex has
    not swung 80 counts yet there was otherwise no way at all to start the sound.
    [main.py, mapping.py]
2026-10-04 Size the audio buffer by largest free block, not total free heap
    ESP.getFreeHeap() returns the sum of every free fragment. Asking malloc for
    that much fails on a fragmented heap, and the failure was silent: the board
    reported 228 kB free, allocated nothing, and came up with a 0-second
    recording buffer.
    ESP.getMaxAllocHeap() reports the largest contiguous block, which is what a
    single malloc can actually get. With the reserve retuned to match, the same
    board now reports a 2.2 s buffer and records.
    [glove_ble.ino]
2026-10-04 Stop one bad reading from ruining a finger's calibration
    A flex channel learns its range from the extremes it has seen, so a
    single dropout that lands above FLEX_VALID_MIN widens the range for
    good and squashes the real bend into a sliver of the scale. That is
    what happened to the middle finger: a learned span of 1140 counts for
    a finger that only travels about 150, so bending it barely moved the
    reading and the on-screen hand never closed.
    Three changes, smallest first: the ends now relax inward each sample,
    so a stale extreme fades on its own; once a range is known, a sample a
    whole span outside it is treated as a dropout, since a finger does not
    suddenly travel twice as far as it ever ha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
    [ble_receiver.py, main.py, sensors.py, web_source.py]
2026-10-04 Learn the flex range from medians, not from single readings
    The relax term from the last commit was wrong. It pulled both ends of the
    learned range inward every sample, and only a new extreme pushed them back
    out — so holding a pose shrank the range instead of a stale extreme fading:
    measured 214 counts falling to 96 after twenty seconds of a held fist, and
    below FLEX_MIN_SPAN the channel stops reporting at all. That is why a fully
    bent finger read 31%.
    Widening on the median of the last five samples does what the relax was
    meant to do without that failure. A dropout is a spike of a sample or two;
    a real bend lasts tens of samples at 100 Hz, so the median keeps one out
    and lets the other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
    [ble_receiver.py, flexlog.py]
2026-10-04 Advertise before touching I2C, and never block on a stuck bus
    The voice glove looked dead: it did not advertise, so nothing could find
    it. Serial showed why — it printed "I2C devices found:" and stopped there,
    mid-scan. A line held low makes Wire.endTransmission() block, and setup()
    scanned the bus and initialised the sensor *before* BLEDevice::init, so a
    stuck bus meant the radio never came up at all.
    Two of the three fixes are reordering. BLE now starts first, and the sensor
    is brought up afterwards: the flex sensors and the microphone do not need
    the IMU, so a glove with a dead BNO08x should still link and still be
    playable, reporting status=0. recoverI2CBus() — which exists to clock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
    [glove_ble.ino]
2026-10-04 Say when the loop hand is simulated, and stop picking a glove at random
    "simulated" on the loop-hand card means no BLE source was built for it,
    which only happens without --voice-glove. Nothing said so, so it read as
    a fault on a board that was working. Single-glove mode now prints what it
    is doing and which flag changes it.
    The second half is a real ambiguity that only appears once both boards
    advertise: single-glove mode looks for the bare "MIMU-GLOVE" prefix, which
    matches -I and -V alike, and _take walked the scan results in dict order.
    So it could attach to the voice board and drive it as the live hand. The
    prefix candidates are sorted now, which lands on the instrument hand every
    time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
2026-10-04 Report flex resistance, calibrated against a meter reading
    The counts tell you whether a channel works; the resistance tells you
    whether the divider suits the sensor, and getting it has meant unpicking
    a glove to put a meter across a taped-down strip.
    flexlog now derives it from the ADC instead. The ideal formula alone is
    not good enough for that — the ESP32's ADC is nonlinear enough to be a
    couple of kilohms out — so --known-bent takes one resistance you did
    measure and solves for the divider that makes the formula agree with it.
    That one number absorbs the ADC error, a 3V3 rail that is not 3.300 V and
    a resistor off its marking all at once, and since both channels share a
    rail and an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
    [flexlog.py]
2026-10-10 Let a song go in the loop buffer, not just your own voice
    The loop hand already knew how to scrub, stretch, freeze, slice and
    pitch-shift whatever sat in _loop_buf; it had simply never held anything
    but a microphone take. --song puts a finished track there, and every
    gesture works on it unchanged - which is why this is a small change for
    a large new instrument.
    Decoding goes through libsndfile and falls back to ffmpeg for the formats
    it does not know, which is most of what a download gives you. Links go
    through yt-dlp, cached by URL so a second run does not re-fetch. All three
    imports are lazy and all three are optional: without them the instrument
    runs exactly as before, and a bad path or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
2026-10-10 Load a song from the page, not only from a flag
    --song meant deciding what to play before starting the instrument, and
    restarting to change your mind. The panel takes a path or a link and
    loads it live.
    Fetching happens on its own thread. The control loop reads both gloves
    and feeds the page at 100 Hz, so a download inline would freeze the hands
    and the UI for as long as it took; the thread only decodes, and the
    finished buffer is installed back on the loop that owns the synth, since
    set_loop swaps the array the audio callback is reading. The page gets the
    three states that matter - loading, loaded, failed - because a typo in a
    path is the likeliest thing to go wrong and the player is looki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
    [main.py, sensors.py, song.py, web_source.py]
2026-10-10 Show a downloaded song's title, and one line when a link fails
    Testing the link path against a local HTTP server turned up two things
    that only appear with a real URL, both of which would have landed in the
    panel where they are most visible.
    Downloads are named after a hash of the URL, because titles are not safe
    filenames - so the page showed "d0380cc462c64015" where a song name
    belongs. The title now lives in a sidecar file next to the audio and
    survives a cache hit. The glob that finds the cached download had to learn
    to skip that sidecar, or it would have been handed to the decoder.
    And a failed link arrived as a yt-dlp paragraph: extractor name, nested
    "caused by" clauses, ANSI colour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
    [song.py]
2026-10-10 Make the song button actually stop the song
    "clear" emptied the text box and nothing else, so it looked like it had
    done something while the track kept playing. It is now "eject" and does
    what the word says: clear_loop() drops the flag, releases the buffer and
    resets the label, which is stronger than toggle_loop - that only pauses,
    leaving the song ready to restart on the next gesture that touches the
    loop. The flag goes down before the buffer so the audio callback never
    sees loop_on with nothing to read.
    Verified by rendering the callback: the track peaks at 0.189, and after
    eject it is 0.000000 and stays there through loop toggle, granular and a
    slice trigger - the three gestures that rea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
    [main.py, synth.py, web_source.py]
2026-10-10 Play a written tune through the instruments, and bend it by hand
    --song can only reshape a recording: scrub it, stretch it, freeze it. It
    cannot change a note, because a mixed track has no melody in it to change
    - the tune is tangled with everything else in the waveform. A MIDI file is
    the notes themselves, so the synth can play it and the hands can do what
    no audio effect can.
    Tilt transposes the piece an octave either way instead of picking from the
    scale. That is the only reading of tilt that still means anything once the
    notes are written, and it leaves every other gesture alone, because filter,
    pan, volume, postures and effects are all about how a note sounds rather
    than which one. The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
2026-10-11 Let the instrument actually be switched off
    Muting the synth to hear a loaded track lasted until the next gesture.
    set_gate() writes drone_on, and mapping calls set_gate(True) whenever the
    index finger bends past the posture threshold - so reaching for the
    track's volume turned the synth straight back on over the music. There was
    no way to keep it off, which made an instrument you cannot deselect.
    Gating and muting are different intentions, so they are now different
    flags. A gate is part of playing and any playing gesture may reopen it;
    instrument_off is a decision about whether the synth is in the piece at
    all, and only 'm' changes it.
    Loading a record sets it. You loaded a record to work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
2026-10-11 Lay the panel out the way the gloves are actually worn
    Three things the UI had wrong about the hardware.
    The cards were ordered live-then-loop, but the loop glove is the one with
    the microphone, button and LED on it and that is worn on the LEFT hand. So
    the loop card now sits on the left, both cards say which hand they are,
    and the loop card carries a "mic - button" badge: which glove records was
    guesswork from the panel before.
    The drawn hand bent its middle and ring fingers. The sensors are on the
    index and middle, so a bend appeared to happen one finger across from
    where it really did - the fingers are drawn thumb-side first, and the
    animated pair was the middle two of the four rather t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
2026-10-11 Give the hands four more things to do to a record
    Roll now seeks in plain playback. It always set target_scrub, but only
    granular and slices ever read it, so the most obvious gesture on the loop
    hand did nothing unless you had switched modes first. Moving the wrist
    jumps the playhead and holding it still lets the track run on, which is
    what a hand on a record does. The jump is a step discontinuity, so it
    fades back in over 6 ms - without that, scrubbing is a burst of static.
    Reverse was already free: the reader indexes modulo the buffer length, so
    a negative rate just walks the other way. It only needed a gesture.
    Pitch and speed were welded together by target_voice_pitch = target_rate,
    so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
2026-10-11 Document every gesture, and make two presets do what they claim
    The guide covered the two hands but not what either does to a loaded
    record or a loaded tune, which is most of what the instrument can do now.
    Both have their own section, including what a record cannot be made to do:
    a mix is one waveform, so there is no way to change its notes or lift out
    its melody, and that is a property of the file rather than a gap to fill.
    Roll was listed twice in each hand's table as two separate gestures, and
    the live hand still claimed it never touches an effect - untrue since it
    got the filter sweep over a record.
    Writing it down turned up a dead parameter. preset_semitones was assigned
    by apply_pre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
2026-10-11 Which glove goes on which hand is an option, not a constant
    It was hardcoded, and hardcoded the wrong way round: I inferred that the
    loop glove was the left-hand one because the microphone and button are on
    the left glove, and that inference was simply wrong. The live glove is the
    left one.
    So it is a flag now. --live-side left|right decides the two things that
    actually depend on it: which card the panel draws on the left, and which
    board gets its orientation inverted, since the board worn on the left is
    the one mounted the other way round. --flip-hand none|live|loop overrides
    the second on its own, for a board that gets remounted. Default is
    live-side left, which is how the gloves are curr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
2026-10-11 Put the right finger on the right sensor, and stop double-flipping roll
    Two things the panel showed back to front.
    The flex sensors are wired the other way from what the mapping assumes:
    GPIO34 is on the middle finger, GPIO35 on the index. FLEX_SWAP existed for
    exactly this and was set to False, so bending the index moved the middle
    finger on screen and drove vibrato instead of volume. It is on now, which
    makes "flex1" mean the index finger everywhere downstream, and it is per
    source with --no-swap-flex rather than a constant to edit.
    And the hand drawing negated its rotation whenever it was mirrored. That
    dates from before the receiver corrected the flipped board: now that roll
    arrives al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
2026-10-11 Add a way out of freeze that does not need a flex sensor
    Freeze is set by a fist and cleared by an open hand, and both postures
    need two working flex channels. A glove with a dead flex channel can
    therefore be frozen with no way back: the only exit is the one gesture
    that hand can no longer make, and nothing on the keyboard or in the panel
    could reach it either.
    Found while debugging a glove whose flex sensors both read 0 and whose
    loop card was stuck showing FROZEN. 'f' and the new button toggle it.
    The general shape of the bug is worth remembering: a state whose only
    escape is a gesture, on hardware that can stop producing gestures.
2026-10-13 Pluck the string when you switch to it in the designer
    Choosing the string engine went silent. Once the designer is already on
    its slot, a live edit swapped the patch without calling set_instrument,
    so _note_on never fired - and a Karplus-Strong string makes no sound at
    all until something plucks it, because the delay line is still empty.
    Measured: 0.03 peak against 0.3-0.5 for the other three engines, and what
    little there was came from the previous instrument still ringing.
    An engine change now retriggers. The string's decay, damping and pickup
    are all fixed at the moment of the pluck, so they can only be heard on a
    new note; those retrigger too, rate-limited to 180 ms because a slider
    dr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
2026-10-13 Give every patch its own filter — the reason they all sounded alike
    Starting points were not the problem. Every instrument was rendered and
    then pushed through ONE filter, at one cutoff, with one fixed resonance.
    Measured at the cutoff the hand actually rests at, nothing above the 5th
    harmonic survived for any instrument - and that is exactly the region
    where instruments differ from each other. Whatever the oscillators did,
    the stage that shapes a sound most was identical for all of them.
    So the filter belongs to the patch now: its own cutoff, its own
    resonance, and an envelope on it with its own decay. The hand still
    sweeps - that gesture has to keep working - but it scales the patch's
    c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
2026-10-13 Show the sound: waveform and spectrum in the designer
    Knobs with numbers on them teach you nothing about what they do. Vital,
    Serum and Synthimatic all put a live waveform and spectrum next to the
    controls, and that is how they make their own synthesis legible: you
    watch a filter close, watch resonance grow a peak, watch an envelope
    open, instead of inferring it by ear.
    The audio callback only writes its output into a ring buffer, which costs
    nothing measurable - 0.29 ms per block against a 5.80 ms budget, the same
    as before. The FFT, the log-spaced banding and the downsampling happen on
    the control thread at 0.43 ms a call, ten times a second, where a slow
    frame costs a dropped redraw rath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
2026-10-24 Show one pane at a time instead of every panel at once
    Everything was on screen together, which made the page a wall to scan
    rather than something you move through. Play, Song and Create are tabs
    now, the instrument rail sits above them as a single row, and the choice
    sticks across reloads.
    Create is laid out as the three steps it actually is: pick an engine from
    a list that says what each one sounds like, give it a character from the
    starting points, then shape it - scope, controls and keyboard together on
    the right, with the name and save on their own row at the bottom.
    Visual only. Every control is still present and still wired: checked by
    id after the move, with all twelve event button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
2026-10-24 Fill the selected character chip instead of outlining it
    One of the seven is always the sound you are editing, so it should read
    as a state rather than as a slightly emphasised button among its
    neighbours. The text colour is --bg, which keeps it legible against the
    light accent of the dark theme as well as the dark accent of the light
    one.
2026-10-24 Draw the instrument icons instead of borrowing emoji
    Emoji are a different typeface at a different weight on every machine,
    they ignore the button's colour so a selected instrument's glyph stayed
    the same while its text went accent, and several of them were only
    loosely about the instrument - there is no emoji that means "sawtooth".
    Seven line icons now say what the instrument is: a sawtooth wave, organ
    pipes, a bowed string, a bell, a flute's keys, a plucked string, a guitar.
    They inherit currentColor, so they go with the button.
    The flute was first drawn with its finger holes as 0.9-unit circles in a
    15-unit box, which are under a pixel once rendered at 16px: it vanished
    and the icon read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
2026-10-24 Draw the rest of the icons, and a guitar that looks like one
    Every button emoji is gone: record, overdub, loop, granular, slices,
    freeze, reverse, pitch, instrument, live voice, punch, scene,
    recalibrate, load, eject and the two hand buttons. They are declared as
    bare paths in one table and wrapped by a single helper, so they are all
    the same size, weight and colour and all inherit the button's state -
    which emoji could not do, staying their own colour while the label went
    accent.
    The guitar was two overlapping circles of nearly equal size and read as a
    snowman. Drawn against three alternatives at both 90px and 18px, the one
    that survives the small size is a waisted body with the neck leavi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
2026-10-24 Use the downloaded guitar and loop icons
    Both arrived drawn their own way rather than on the 15-unit stroked grid
    the hand-drawn ones share: the loop is stroked on a 24-unit grid, the
    guitar is a filled silhouette on a 16-unit one. The helper took a bare
    path and forced fill:none onto it, which renders a filled silhouette as
    nothing at all, so an entry can now be either a path string or
    {d, vb, fill, w} and keeps whatever grid and paint it was drawn with.
    The loop keeps stroke-width 2.1 on its 24-unit grid, which lands at the
    same apparent weight as 1.4 does on the 15-unit grid once both are drawn
    at 16 px. Both still take currentColor, so they go accent with the button
    like the rest.
2026-10-24 Make the Song tab a deck: vinyl, waveform, transport, pitch
    The pane was a text box and a progress bar for something that is a
    record player. It now looks like one: a turning record with a tonearm,
    artist and title, the waveform with the played part solid and the rest
    ghosted, elapsed and remaining, transport, a pitch fader and a row
    showing what each gesture is doing to the track.
    The record turns at the playback rate rather than a fixed speed, so the
    picture agrees with what you hear, and it pauses rather than stopping so
    it keeps its angle instead of snapping back to zero. The tonearm is a
    separate layer: inside the rotating svg it would turn with the record,
    and a tonearm that spins is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
2026-10-24 Say so when the audio device never asks for a block
    A stream can start without raising and then never call back, and on macOS
    that is what a duplex stream does when microphone permission was never
    granted. Everything reports healthy, the panel says PLAYING, and the
    instrument is silent with the playhead sitting at zero - which is exactly
    what it looks like from the outside, and tells you nothing.
    The synth counts the blocks the device actually asks for, and the control
    loop checks after two seconds. If the count is still zero it says the
    stream is not running, that microphone permission is the usual cause, and
    what to do about it.
    --no-mic forces the output-only path for that case: the fal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
2026-10-24 Open the record filter at rest instead of halfway down
    The live hand's lowpass spread its sweep across the whole roll range, so
    the middle of that range - where a hand sits - was the middle of the
    sweep. Measured, a level hand put a lowpass at 1.9 kHz over the track and
    a hand at its natural angle about 3 kHz, which on a full mix is simply
    muffled. You had to hold your wrist rolled over to hear the record as it
    actually sounds.
    It is a centre detent now: level or rolled right is open and the filter
    is bypassed entirely, rolling left closes it down to 200 Hz. That halves
    the gesture's travel and is worth it - a control whose resting position
    degrades the sound is not a control, it is a fault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
2026-10-24 Give the record label its own colour
    It was the accent teal, which is also the waveform, the knobs, the
    selected button and the chips — so it read as more of the same interface
    rather than as part of a record. Amber separates it from both the
    near-black disc and everything else on the page, and is what a record
    label actually looks like. The spindle is light now so it reads as a hole
    rather than as a dot the colour of the disc.
2026-10-24 Build the platter the way the reference draws it
    Four discrete circles on a dark disc is a diagram of a record. The
    reference makes the grooves a repeating radial gradient at a couple of
    pixels a ring, which reads as vinyl, and lays a conic gradient over it as
    a sheen. The sheen does not turn: a reflection sits on the surface while
    the record moves under it, and spinning it would make it a mark painted
    on the disc instead.
    The tonearm now tracks the track, 16 degrees at the rim to 34 at the
    centre, which is the one part of a turntable that tells you where you are
    without reading anything. The spindle stays still over the turning label,
    because it is the hole the record sits on rather than p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
2026-10-24 Size the load row for a URL, and separate its buttons
    The field was a 1fr grid column, so it stretched the whole panel for one
    line of text, and Load and Eject sat on the row's 8px grid gap with
    nothing between them. It is a flex row now: the field caps at 46rem -
    736 px of an 1146 px row, measured - and the buttons have 14px between
    them and more padding of their own.
    A first attempt capped it at 30rem, which was too short for a URL. The
    cap was also invisible in testing at first, because the default headless
    window is narrow enough that the row never reaches it; measuring the
    element rather than cropping a screenshot is what showed that.
    The placeholder loses its example path too. "paste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
2026-10-24 Let the project load on Windows
    termios, tty and a select() on stdin are POSIX only, and sensors.py
    imported all three at the top. That stopped the entire project loading on
    Windows — import mapping, import sensors, ModuleNotFoundError — even for
    `--ble --web`, which needs none of them.
    They are used by exactly one method, the keyboard simulator's key reader,
    so they are imported there. Without them that method says once that
    keyboard control needs a POSIX terminal and returns, and the pad, sliders
    and buttons in the browser drive the same source just as well.
    Verified by blocking those modules and importing the way main.py does:
    all nine modules load, and _read_keys returns cleanly in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
2026-10-25 Show both hands at once instead of switching between them
    One pad filled the pane and a toggle decided which hand it drove, so you
    could see either hand but never both, and the thing the instrument is
    actually about - two hands doing different jobs - was the one thing the
    screen would not show. Two pads side by side now, each with its own pose,
    its own three sliders and its own colour: teal for the live hand, warm
    for the loop hand, matching the dot, the name and the sliders on each
    card. The hand switcher and its `h` key are gone with it.
    Each pad mirrors its own glove when the hardware is connected, rather
    than one pad mirroring whichever hand was selected.
    sound on, sound off and next i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
2026-10-25 Group the modes and give each one a card
    Ten buttons in one grid is a list you have to read. They are three groups
    now — Capture, Texture, Voice — each with a line saying what the group is
    for, and each mode is a card: its key, a dot for whether it is on, its
    icon and name, and a line saying what it does. "slices" meant nothing
    without already knowing; "chop to beats" does not.
    The icons are the ones that were already there, moved from in front of a
    label into the card's title.
    State comes from one table rather than a line per button, because the
    "N active" count in the header has to be derived from the same source as
    the dots or it drifts from what it is meant to summarise. Checked: f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
2026-10-25 Size PUNCH like something you hit
    It was a 40px bar sitting under the mode cards, the same shape as every
    control you choose by reading it. This is the one you hit, often while
    looking somewhere else, so it is 166px tall with the word at 34px and a
    line underneath saying it is also the wrist flick — the gesture and the
    button are the same thing and the panel never said so.
    The key hints go with it, from a run-on sentence to four pills. They are
    a legend, and a legend is scanned rather than read.
2026-10-25 Trim PUNCH to the height of a mode card
    166px made it the loudest thing in the panel, which is more weight than
    it needs — it only has to be easy to hit. 108px, the same height as the
    cards above it, with the word at 24px instead of 34.
2026-10-25 Stop a shorted button wedging the glove
    A glove connected, reported itself healthy and then never moved. The
    cause was the button: its GPIO reads as pressed permanently on that
    build, so the firmware recorded on boot, filled the buffer, and sat in
    `while (buttonHeld())` waiting for a release that was never coming.
    Recording also returns early from the loop, so no orientation was sent
    either - one heartbeat in thirty seconds, with the panel showing it
    linked and stalled and the hand frozen at zero.
    A press that never ends is a wiring fault, not a very long press. After
    eight seconds - longer than any real press - the button is treated as
    stuck and ignored until it genuinely releases, and the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
2026-10-25 Disable a button that presses itself
    A loaded song kept being replaced by two seconds of room noise. The chain
    is short and entirely mechanical: the button's pin produces presses on its
    own, a hold records from the glove's own mic, the mic hears the song
    coming out of the speakers, and a take REPLACES the loop buffer rather
    than adding to it — so the song becomes a 2.2 s fragment of itself,
    recorded through the air, looping. That is what "it records the music and
    chops it" was.
    Two guards, because the fault turned out not to be what I first assumed.
    A button already down at boot is a short, so it is ignored from the start;
    nobody powers a glove up holding its button. But measurement showe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
2026-10-25 Stop hand tremor pinning the playhead to one spot
    A loaded track would start repeating a fraction of a second, which looked
    like freeze or granular and was neither. The seek threshold was 0.004
    scrub units — 0.36 degrees of roll. Measured, a glove lying completely
    still drifts 3.6 degrees, and a hand trying to hold a position moves
    several, so the playhead was being dragged back to almost the same place
    continuously and the same moment replayed.
    0.025, which is 2.25 degrees. Simulated against a hand holding position:
    at 1.5 degrees of tremor the playhead now covers the full 6 seconds of
    audio rendered rather than sitting still, and a deliberate scrub to 0.1
    and 0.9 still lands at 3.9 s an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
2026-10-25 Keep a misfiring button from overwriting a loaded song
    The earlier guard disabled a button after five presses in ten seconds,
    which catches a pin that chatters but not one that misfires every twenty
    or thirty seconds. Each of those still records two seconds of the room
    from the glove's mic, and a take replaces the loop — so a song vanished
    at random intervals with nothing to show why.
    The firmware now counts over a minute and trips at three, since three
    deliberate presses a minute is already more than this button is for.
    And --no-glove-mic drops takes on the laptop instead, which is certain
    where a counter is a guess: it does not matter how rarely the pin
    misfires if the recording is thr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
2026-10-25 Stop a saved instrument flickering the rail away
    The rail decided which instruments were yours by asking whether a button
    for that name was already on screen. The moment one had been drawn it
    stopped counting as yours, so the next state message emptied the rail and
    the one after drew it again: ten times a second, with the built-ins
    re-fitting themselves narrower around whatever was left.
    Hold the seven shipped names in a set taken at load, compare against that,
    and rebuild only when the set of saved names actually changes. The rail is
    a wrapping row now rather than equal columns, so a new instrument lands on
    the next line instead of squeezing the other seven.
2026-10-25 Let a saved instrument be deleted from the rail
    A designed instrument could be made but never removed: the store had a
    delete and nothing reached it, so the rail only ever grew. Each of your own
    instruments now carries a small x in its top right corner, shown only while
    the pointer is on that button so a row of them does not invite the accident.
    Deleting rewrites the store, so the patch is gone the moment it returns and
    the x sits a few pixels from the name. The last delete is therefore held in
    one slot and the rail offers an undo for eight seconds.
    The buttons are built as nodes rather than a string of HTML while this is
    here. A name is whatever you typed into the designer, and a quote in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
2026-10-31 Drive the status LED as a WS2812B on GPIO16
    The single-colour LED on GPIO19 is gone, replaced by one WS2812B with its
    data line on GPIO16. Driven through the core's own neopixelWrite(), so no
    library is added, and written only when the colour changes rather than fifty
    times a second.
    Colour now carries the state, which the old LED could not: red recording,
    blue while the take goes out over BLE, dim green idle and linked, dim blue
    pulse idle and still advertising. The error colour had been defined and
    never set, so the sensor stall is wired to it — the hand shows the stall as
    it happens instead of only the laptop's log.
    GPIO16 is the PSRAM bus on a WROVER, which this is, so the sketch ref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
2026-10-31 Put the status LED on GPIO23, clear of the PSRAM bus
    GPIO16 is the PSRAM chip select on a WROVER, so the LED there was only
    possible in a build without PSRAM — which costs the 8 s recording buffer and
    leaves internal RAM to be shared with the BLE stack.
    GPIO23 is none of those things: not strapping, not flash, not PSRAM, and
    quiet at boot, so the LED and the long buffer can both exist. Compiles clean
    with PSRAM enabled now, which is the combination that mattered.
2026-10-31 Give each hand its own pin for the glove LED
    19 was free on the instrument board once the status LED moved to 23, but
    that pin is taken on the voice board, so the voice hand uses 27. Both are
    plain GPIOs: no strapping, no flash, no PSRAM, nothing driven at boot.
    The choice rides on HAND_VOICE, which already tells the two boards apart, so
    the wiring difference needs no second build option and cannot be set wrong
    independently of the hand.
    Guards for the other pins that were on the table: 16 and 17 are the PSRAM
    bus, and 12 sets the flash voltage at boot - that one does not light a dark
    LED, it stops the board coming up at all.
2026-10-31 Put the glove LED on the same pin on both hands
    27 on both rather than 19 and 27, so the two gloves are wired identically.
    The per-hand #ifdef is gone with it: a wiring difference that does not
    exist cannot be set the wrong way round.
    The guards stay, since they protect whatever the pin is changed to later:
    16 and 17 are the PSRAM bus, and 12 sets the flash voltage at boot.
2026-11-01 Bring the README up to what the thing actually does
    Three things had drifted. The browser section described an interface that no
    longer exists - one XY pad and a yaw slider, rather than two hands, three
    tabs and a deck. The instrument designer was not mentioned at all, though it
    has its own module and its own store. And the two LEDs had wiring documented
    but no word on what any colour means, which is the only thing that matters
    when the glove is on a battery and there is no serial console.
    Also a file-by-file table in the architecture section: eight modules had
    grown with no map of which one owns what.
2026-11-01 Show the gloves in the README
    Two drawings generated from the firmware's own pin numbers: what sits on the
    glove and what each hand does. The asymmetry between the hands is the
    project's central design decision and a paragraph never conveyed it as
    quickly as the picture does.
2026-11-01 Harmonise the take against itself
    The proposal promised harmonisation of the captured voice and nothing in
    the code did it: pitch could be moved, but only by replacing the original,
    never by sounding beside it.
    It rides on the granular path, because that is the only place where pitch is
    independent of time. A second reader at 1.5x on the ordinary loop would also
    run through the buffer half again as fast and drift away from the voice it
    is supposed to be harmonising; a grain's position and the speed it is read
    at are separate numbers, so the cloud keeps its rhythm while the note moves.
    One cloud, read three times. The grains are scheduled and aged once and
    every voice draws from the same li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
2026-11-01 Let harmony travel through the take instead of holding one chord
    Harmony rode on granular, and granular stops time on purpose: the grains
    come from wherever the hand last pointed and stay there. For granular that
    is the point. For harmony it meant one chord held for as long as the hand
    was still, which reads as stuck - and with a glove whose flex sensor is
    dead there was nothing to move it with.
    Grains can now be spawned at a position in samples rather than always at
    the scrub, and harmony walks that position forward at the loop's own rate.
    The wrist still seeks, exactly as in plain playback, and freeze still works
    because it holds the output through the stutter buffer rather than the
    playh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
2026-11-01 Bounce: write what you are hearing back into the loop
    Every effect lived outside the recording and shaped it on the way out, so
    harmony, granular and the rest applied to the whole buffer at once. A second
    layer could not be shaped differently from the first, which is the thing a
    looper is for.
    Bounce captures one cycle of the processed voice and makes it the recording,
    then clears the modes that produced it so they are not applied to their own
    output a second time. Overdub already layered takes; this is what makes the
    layers independent.
    Verified on a 220 Hz take with harmony on: before the bounce the buffer held
    the root alone, after it the third and fifth are in the samples at 0.58 and
    0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
2026-11-01 Keep what you played
    Nothing the instrument made survived quitting it. Instruments were stored,
    performances were not: a take, its layers, a bounce and everything the hands
    did to them existed only while they were being played.
    Two ways out, because they answer different questions. Export writes the
    loop itself, so a good take can be reloaded another day with --song. Record
    session taps the finished stereo output at the end of the callback and
    captures the lot - both hands, every layer, harmony, the effects, the stereo
    width - which is the one that turns an evening into a track.
    The session is held in memory and written when it stops, since opening a
    file from the audio callback is how you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
2026-11-01 Measure the three criteria that do not need a hand
    The proposal named four measures of success and none of them had a number
    against it. Three are properties of the software and are now measured by
    measure.py, against the real mapping and synthesis code rather than a copy:
    gesture recognition, response time and stability under load.
    None of it needs a glove attached, which is the point - a measurement that
    only runs when the hardware is healthy is one you cannot repeat, and the
    hardware is not healthy. Flex noise is set from the figure already in the
    README: 13 counts of noise in a 212-count swing, so 6% of usable range.
    Two things the writing of it turned up. Postures are only recognised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
2026-11-01 Write down what is still missing
    Three of the four criteria now have measured numbers. The fourth needs
    people and cannot be automated, and two components named in the proposal
    were never built. That belonged somewhere other than a conversation, so
    tech-debt.md records it along with the open hardware faults, the measured
    voltages that rule out the easy explanations for the dead sensor, and an
    order of work that puts the vibration motor last because it is the only
    item the instrument plays perfectly well without.
2026-11-02 Let the modes that can combine, combine
    Three loop modes were treated as one exclusive set by the posture and as
    three free switches by the buttons, and neither was right.
    Granular and harmony genuinely exclude each other: they are two readings of
    the same grains and the callback takes one, so leaving both on lit two cards
    and played one. They now clear each other wherever they are set.
    Slices does not belong in that argument. A fired chunk is mixed on top of
    whatever is playing - measured at +27% RMS over harmony alone - so it
    combines with either reading and always could. It is now independent
    everywhere, and the posture cycles only the three readings rather than
    pretending slices is a f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
2026-11-03 Run on three flex sensors instead of four
    The right glove already has a dead flex channel, and a hand that loses one
    used to lose all three postures at once: _read_posture refused to read
    anything unless both fingers reported. Point genuinely cannot survive, since
    it is the two fingers disagreeing, but fist and open can.
    The difficulty is that the surviving finger is also a continuous control,
    and with no second finger there is nothing to separate using it from meaning
    a posture. A first attempt at a 0.90 threshold detected 0 deliberate fists
    out of 30 - not because of the threshold but because of the dwell. A finger
    held at 0.97 with the measured noise dips below 0.90 about one frame in
    ei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
2026-11-05 Hold the ladder back only where it can run away
    The resonant ladder feeds back round a one-sample delay, so its loop gain
    creeps past unity as the cutoff coefficient approaches 1. Measured, it
    diverges above resonance 2.2 once the coefficient reaches 0.9, which is
    inside what a designed patch may ask for — the patch matcher found the
    corner on its own within a dozen tries and filled the output with overflow
    warnings.
    Resonance is now clamped as the coefficient climbs. Capping the coefficient
    instead was the first attempt and was wrong: it took the guitar's top end
    with it, and the top end is most of what makes it a guitar.
    The clamp applies to designed patches alone. All seven built-ins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
2026-11-05 Play a cover, rather than play the record
    --song puts a recording in the loop buffer, and everything the loop hand
    does then works on it. But you are still playing the recording: scrubbed,
    frozen and sliced, it is their take. A cover is the other thing.
    cover.py measures a passage and throws the audio away. Spectral flux and
    autocorrelation give the pulse; a harmonic-sum pitch track band-limited low
    gives the bass, the same track higher up gives the lead, and pitch-class
    energy above each bass note names the chord over it. A pedal tone is
    reported when one pitch class stays strong while the chords move under it —
    leaving that out left the vamp sounding like two chords rather than like
    the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
2026-11-05 Hand the cover's vamp over as layers, not as a mix
    The synth mutes, solos and deletes layers one at a time, and --cover
    delivered its backing as a single wav — so covering a piece was the one
    place in the instrument where that did not work. You could drop the whole
    vamp or none of it.
    The backing is now rendered as separate parts and installed as one layer
    each: bass, chords, pedal. The bass can drop out for a verse and the chords
    can be soloed to hear the changes, through the panel that was already
    there. Measured on the layers: muting the bass takes 16 dB out below 150 Hz,
    muting the pedal takes 2.9 dB out of the midrange, and every transition
    clicks zero times — the crossfade already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
2026-11-05 Make a mute leave the other layers where they were
    layers_test.py walks the flow you actually perform — record, overdub,
    overdub, then take one out — and gives each take its own note, so which
    layers are sounding is a number instead of an impression. It found two
    things on the first run.
    A mute made everyone else 3 dB louder. _remix scaled the mix to 0.9 of peak
    from the layers that happened to be audible, so taking one out left more
    headroom for the rest to be stretched into. That is not what a mute does on
    any mixer: you take one part out and the others stay where you set them.
    Headroom now comes from the whole stack. Adding a layer still lowers the
    lot and deleting one still raises t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
2026-11-05 Keep the Layers panel on screen for a single take
    The panel hid itself below two layers. Delete one of a pair and the whole
    thing vanished, which reads as the app having lost the take rather than as
    a panel with nothing to compare.
    Worse, it could be a dead end. Mute one layer, delete the other, and what
    is left is a muted take with its M button gone along with the panel:
    silence, nothing on screen to undo it, and no way back short of recording
    over the top. Measured at -48 dB out with one layer still in the stack.
    Shown now whenever there is anything at all. One take with its own M, S
    and x is not clutter — it is the controls for the thing you just recorded.
2026-11-05 Say on the page what became of the take
    Every outcome of a recording was printed to the terminal and nowhere else,
    which is the wrong place: while you are playing you are looking at the
    browser. From there, a take that got thrown away and a take that worked
    looked identical — the button lit, the button unlit, and the Layers panel
    either changed or did not.
    The four endings now reach the page, hot when the take was lost:
    nothing recorded — the microphone sent no audio
    take discarded: almost silent (peak 0.00002). Check mic permission...
    layer 2 added — 2 layers now
    take 1 recorded, 2.0s — this replaced the stack. Use Overdub instead
    That last line is the one worth having. R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
2026-11-05 Address a layer by what it is, not by where it sits
    Bounce flattens the stack into one new layer, and delete renumbers the
    rows. The panel was sending "track:mute:1" — a position — so a press made
    against the list as it stood a moment earlier landed on whichever layer had
    since moved into that slot. Press bounce, then press a button belonging to
    a row the bounce had just removed, and the new bounced take was muted by a
    click that was never meant for it: one layer, nothing audible, and an M lit
    that the user had not pressed.
    Layers now carry an id that is never reused. The panel sends the id, and an
    id that is no longer in the stack is ignored and reported rather than
    silently applied to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
2026-11-05 Let an effect land on one layer and not the others
    Effects live outside the loop buffer and shape it on the way out, so they
    applied to the whole stack: put reverb on the layer you are working on,
    un-mute another, and the second one arrived wet as well. Solo-then-bounce
    was the only way round it and it flattened the stack to get there.
    Each layer now carries an FX flag, and _remix builds two mixes instead of
    one: the layers with FX on go into the buffer the chain reads, the rest are
    summed separately and played back alongside it. The chain still runs
    exactly once, so this costs one array and no DSP. A chain per layer would
    have meant a reverb and a delay line each, and would have broken the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
2026-11-05 Give a layer its own effects, as pills you can take off
    The FX flag could route a layer around the effects but not give it
    different ones: every effected layer shared the single set of settings the
    hand was holding. Put a reverb on one layer, mute it, give another an
    octave down, bring the first back, and both arrived an octave down —
    whatever was set last won, which is not a stack.
    Effects that belong to a layer are now rendered into that layer's samples
    when you add them, with the untouched recording kept beside it. A layer
    carries a list of what has been done to it; taking one off renders the list
    again without it. Nothing is destroyed and nothing is decided at audio
    time, so a layer w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
2026-11-05 Let the pill clicks actually reach the synth, and light them
    The socket drops any event it does not recognise, by prefix, and layerfx:
    was never added to that list. Every pill click was discarded one layer
    below the page: the menu opened, the effect was picked, and nothing
    happened anywhere — no error, no sound, no pill. The same list already had
    to be told about track: for the same reason.
    The panel now shows all six on every row rather than hiding them behind a
    + fx button. One you have not put on this layer is a thin outline; one you
    have takes its own colour and grows an x. Click to put it on, click again
    to take it off — the menu meant two clicks to reach something that fits on
    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
2026-11-05 Redraw the layer row when its effects change
    The panel rebuilds its rows only when a signature over the tracks changes,
    so that replacing them on every state message does not throw away the
    button under the pointer. The chain was not in that signature. Clicking a
    pill therefore changed the layer, changed the sound, and left the row on
    screen exactly as it was: the effect was on and there was no way to see it.
    A lit pill is filled with its hue now rather than washed with 17% of it. On
    a muted row, already at 45% opacity, the tint was close to invisible, and
    the one thing a pill has to do is say which layer is carrying what from
    across the panel.
    Checked by running the panel's own row code a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
2026-11-05 Show the hand's modes on the layers they are reaching
    Two of the Texture panel's modes can belong to a layer rather than to the
    hand, so they are pills now: granular, which scatters the material into
    grains, and harmony, which stacks a third and a fifth taken from whatever
    scale the scene is in — a major third baked over a minor scene would be
    wrong in the same way the live mode takes care not to be. Granular is
    seeded, because taking a later effect off re-renders the chain and a layer
    must not change its mind about which grains it used.
    Slices and Freeze stay out. They are moments, not settings: a fired chunk
    and a held instant belong to the gesture that made them and there is
    nothing to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
2026-11-05 Move the right hand's one sensor to the middle finger
    The right glove carries one flex sensor, on the middle finger, measuring
    7.9k straight and 8.8k bent. Everything downstream assumed two: FLEX_SWAP
    could report the survivor as the index, the panel drew a lit index stuck
    straight, and Point was offered on a hand that cannot make it.
    That glove now reads one channel and always calls it the middle finger,
    whichever pin it landed on. Half a second after connecting it takes the pin
    that reads like a sensor. The left glove is untouched.
    7.9-8.8k through the 15k leg is only about 101 counts, too little to wait for
    self-calibration at 80, so the channel starts from the known range. It adopts
    th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
2026-11-05 Measure the one-sensor finger from where it rests
    The right hand kept freezing with the finger relaxed. The channel learned a
    plain min and max, so one stray high reading left the resting 1726 at the
    "bent" end of a 1716..2207 range: a relaxed finger read 0.97, which is a held
    fist, which freezes the loop. It also assumed the specified 7.9-8.8k, while the
    sensor reads 20.6k through the 15k leg, and assumed bending lowers the reading.
    It now reads distance from the position at connect, in whichever direction the
    sensor moves. Relaxed is 0 by definition, and a glitch that inflates the travel
    can only make a real bend read smaller. Direction locks only once travel is too
    large to be noise; loc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
2026-11-05 Clear BLE subscriptions when a client disconnects
    The glove only accepted one laptop connection per boot. Every later attempt
    brought the link up, so the status LED went green, then service discovery hung
    until the Mac timed out, while the panel said "no glove". Restarting main.py
    could not fix it; replugging the glove could.
    The stack keeps a client's subscription after the link is gone, so the next
    client most likely got 50 notifications a second during discovery. Both
    subscriptions are now cleared on disconnect.
    Measured on the right glove: reconnects without a reboot went from 0 of 2 to
    all working, 5 of 5 connections in the test including two with no reboot
    before them, and two consec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
2026-11-05 Calibrate the right hand's flex between two measured readings
    The finger reacted too much at times and backwards at others. Its whole bend
    is about 107 counts, and its range was learned from movement, so the first
    wobble set both the scale and the direction: a small movement read as a full
    bend, and a wobble the wrong way made a real bend read as straightening.
    The channel now maps between a straight and a bent reading it is told.
    calibrate_flex.py measures them, along with whether waving the hand disturbs
    the sensor, and saves them to flex-cal.json. Until it has been run they come
    from the sensor's 7.9-8.8k and the resting reading. A reading a whole bend
    outside the range is held rather th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
2026-11-05 Refuse to save a flex calibration that fails its own checks
    A real run saved straight 1700 and bent 1636, a 64-count bend, while its own
    readings showed about 1728 to 1565 and printed two warnings beneath the word
    Saved. The first bend had been reached late, which dragged the median towards
    straight, and waving the hand moved the reading by 839 counts.
    Each hold is now measured over its last part, and a result failing any check
    is not saved, since a bad calibration is worse than the 7.9-8.8k default. The
    report shows every hold and how far the hand wave took the reading.
    --watch shows the live reading with its low and high, for wiggling one joint
    at a time to find a loose connection, which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
2026-11-05 Keep working through the right glove's loose connection
    Calibration runs showed the fault: the reading jumps to as much as 4077 as the
    hand moves, while a real bend only moves it down. The joint is sewn in and
    cannot be reached to repair, so the channel now treats anything above straight
    as a dropout and holds the last value.
    A position is only taken as straight while the connection is good, so a dropout
    at connect or during `c` cannot become the zero point.
    A full bend is now 160 counts below rest, as measured, in place of the 107
    worked out from 7.9-8.8k, which reached full at two thirds of a real bend.
    Replayed from the measured numbers: dropouts up to 3130 during an 8 s wave do
    not fr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
2026-11-05 Keep wrist rotation prompt when Bluetooth runs slow
    Rotation lagged badly on the right glove. It was delivering about 20 packets
    a second from a 50 Hz sensor, with gaps up to 300 ms and nothing else running.
    Scanning for the absent left glove barely affected that, 18 against 21.
    Two changes. The firmware now asks for a 15-30 ms connection on connect, which
    took it to 29 packets a second with gaps of about 100 ms at worst. Pose smoothing
    is now a time constant rather than a per-packet factor: identical at 50 Hz, but
    at 20 Hz it reaches 90% in about 100 ms where it took about 200 ms.
    The left glove needs this firmware as well.
2026-11-05 Stop the right hand's tilt pitching the loop twice
    Tilt set the loop's speed, which already moves its pitch, and also gave the
    pitch shifter the same ratio. A 1.59x tilt on a 220 Hz tone came out at 549 Hz
    rather than 350, and returning to level took 145 ms through the shifter's
    buffer against 87 ms for a pitch step on the left hand.
    While the loop plays at the hand's speed the shifter now stays at unity, so the
    tone lands on 350 Hz and returning to level takes 110 ms. Granular, which ignores
    the rate, and the live mic still pitch through the shifter, and the Chipmunk and
    Demon offsets still apply on top.
    Both gloves were first measured delivering about 48 packets a second with
    matching ga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
2026-11-05 Let the left glove's one LED speak for itself
    The left glove's only LED is on GPIO27, which only the laptop drove. It stayed
    dark without the laptop, and with it the sound-off level of 60 came through a
    cap of 48 as 11 of 255, under two layers of fabric, which read as off.
    That build now shows the status colours on GPIO27 until the laptop sends a
    colour, and over it while recording, sending a take or stalled, since the laptop
    cannot know those. The cap goes to 120 on both builds and the sound-off level to
    140, so it now lights at 66 of 255. A disconnect clears the last colour on
    both builds, since a lit LED read as still connected.
    Flashed to the left glove only. The right glove keeps its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
2026-11-05 Play a glove recording even if Bluetooth lost part of it
    The receiver waited for every byte of a take with no timeout. Audio arrives as
    unacknowledged notifications, so one lost packet left the take pending for good:
    the log said "2.2s incoming" and nothing ever played. Later takes were swallowed
    too, because a header was only recognised when nothing was pending.
    A header now always starts a new take, and a take ends when sensor packets
    resume and no audio has come for 0.5 s. It plays if at least half arrived, and
    the log reports how much was lost, or that it failed and nothing changed.
2026-11-05 Stop rebooting the glove when its sensor goes quiet
    Watched over Bluetooth for a minute, the right glove lost its link about every
    8 s lying still, and held it for 19 s with full data while the hand moved. The
    watchdog hard reset the sensor after 3 s of silence, the reset failed, and the
    board rebooted, which is what dropped the laptop.
    A quiet sensor is now only re-enabled, and the hard reset waits for 20 s of
    silence. Over 32 s after flashing there were no link losses. Why the sensor goes
    quiet at rest is still not known, and neither is whether it resumes on its own
    once the hand moves. The right glove keeps its LED cap of 48 for now.
2026-11-05 Put the right glove back on the same firmware as the left
    Measured side by side on a table, a few seconds apart, the right glove delivered
    19 packets a second with the longer sensor reset wait and raised transmit power,
    and 45 with the left glove's exact build, against the left's 47 throughout. No
    link was lost in either run, and the right glove did not reboot lying still.
    This reverts the longer wait. Which of the changes caused the drop is not
    isolated, the transmit power change was never committed, and the same firmware
    family has read 20-29 before, so one good run does not prove the rate will hold.
    The right glove's LED cap is now 120 like the left's.
2026-11-06 Default to four sensors, with one on the right behind a flag
2026-11-06 Cut the README down to what a new reader needs
